tetra-aero/LTC6811_ESP32/Version Update Notes.txt

V1.0
1、Add chrysanthemum chain connection interface. （增加菊花链连接接口 ）

V1.2 
1、Rectify the issue of USB port being obstructed.（修正USB接口被遮挡的问题）
2、Change the maximum output current of the 3.3V DC-DC chip to 2A.（更改3.3V DCDC芯片最大输出电流为2A）
3、Remove the power supply circuit from the traction battery and switch to a 12V storage battery.（取消从动力电池供电电路，更改为12V蓄电池供电）
4、Optimize isolation partition（优化隔离分区）

V1.3
1、Correcting UART interface.
2、Optimizing signal transmission lines.
