tetra-aero/LTC6811_ESP32/LTC6811_ESP32_V6/Master_V6P1/LTC6811_ESP32_Master_V6P1_BOM.xlsx

Item | Qty | Reference | Value | Description | Datasheet | Footprint | Link | MPN | weight | total weight
1 | 44 | C1,C2,C3,C4,C5,C6,C7,C8,C9,C10,C27,C28,C32,C37,C41,C47,C49,C51,C52,C53,C54,C55,C56,C57,C58,C59,C60,C61,C62,C63,C67,C68,C77,C78,C79,C80,C81,C82,C83,C84,C85,C86,C87,C88 | 100nF/100V | 0.1 uF ±10% 100V Ceramic Capacitor X7R 0603 (1608 Metric) | https://www.digikey.jp/en/products/detail/samsung-electro-mechanics/CL10B104KC8NNNC/5961291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 | Capacitor_SMD:C_0603_1608Metric | https://www.digikey.jp/en/products/detail/samsung-electro-mechanics/CL10B104KC8NNNC/5961291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 | CL10B104KC8NNNC | 0.0063 | 0.2772
2 | 2 | C20,C33 | 2.2uF/25V | 2.2 uF ±10% 25V Ceramic Capacitor X5R 0603 (1608 Metric) | https://search.murata.co.jp/Ceramy/image/img/A01X/G101/ENG/GRM188R61E225KA12-01.pdf | Capacitor_SMD:C_0603_1608Metric | https://www.digikey.jp/en/products/detail/murata-electronics/GRM188R61E225KA12D/4905349 | GRM188R61E225KA12D | 0.0063 | 0.0126
3 | 2 | C21,C48 | 1nF/16V | 1000 pF ±10% 16V Ceramic Capacitor X7R 0603 (1608 Metric) | https://connect.kemet.com:7667/gateway/IntelliData-ComponentDocumentation/1.0/download/datasheet/C0603C102K4RECAUTO | Capacitor_SMD:C_0603_1608Metric | https://www.digikey.jp/en/products/detail/kemet/C0603C102K4RECAUTO/8640472 | C0603C102K4RECAUTO | 0.0063 | 0.0126
4 | 10 | C24,C26,C29,C30,C45,C50,C69,C70,C73,C74 | 10nF/100V | 10000 pF ±10% 100V Ceramic Capacitor X7R 0603 (1608 Metric) | https://content.kemet.com/datasheets/KEM_X7R_FT_VW_AUDI.pdf | Capacitor_SMD:C_0603_1608Metric | https://www.digikey.jp/en/products/detail/kemet/C0603X103K1RAC3316/10315782 | C0603X103K1RAC3316 | 0.0063 | 0.063
5 | 7 | C31,C34,C35,C38,C39,C64,C65 | 1uF/25V | 1 uF ±10% 25V Ceramic Capacitor X7R 0603 (1608 Metric) | https://mm.digikey.com/Volume0/opasdata/d220001/medias/docus/3644/CL10B105KA8NNNC_spec.pdf | Capacitor_SMD:C_0603_1608Metric | https://www.digikey.jp/en/products/detail/samsung-electro-mechanics/CL10B105KA8NNNC/3886842 | CL10B105KA8NNNC | 0.0063 | 0.0441
6 | 2 | C40,C42 | 4.7uF/16V | 4.7 uF ±10% 16V Ceramic Capacitor X5R 0603 (1608 Metric) | https://mm.digikey.com/Volume0/opasdata/d220001/medias/docus/2328/CL10A475KO8NNNC_Spec.pdf | Capacitor_SMD:C_0603_1608Metric | https://www.digikey.jp/en/products/detail/samsung-electro-mechanics/CL10A475KO8NNNC/3887442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 | CL10A475KO8NNNC | 0.0063 | 0.0126
7 | 3 | CR1,CR2,CR3 | S-562T | CURRENT REGULATOR DIODES 100V 5. | https://www.semitec-global.com/uploads/2022/01/P22-23-CRD.pdf | Diode_SMD:D_SOD-123F | https://www.digikey.jp/en/products/detail/semitec-usa-corp/S-562T/16578981 | S-562T
8 | 4 | D1,D4,D9,D25 | LED Red | Red 631nm LED Indication - Discrete 2V 0603 (1608 Metric) | https://optoelectronics.liteon.com/upload/download/DS-22-99-0151/LTST-C190KRKT.pdf | LED_SMD:LED_0603_1608Metric | https://www.digikey.jp/en/products/detail/liteon/LTST-C190KRKT/386817 | LTST-C190KRKT | 0.028 | 0.112
9 | 4 | D6,D7,D22,D23 | 1N4148W | Diode 100 V 300mA Surface Mount SOD-123 | https://www.diodes.com/assets/Datasheets/BAV16W_1N4148W.pdf | Diode_SMD:D_SOD-123 | https://www.digikey.jp/en/products/detail/diodes-incorporated/1N4148W-7-F/814371 | 1N4148W-7-F | 0.01 | 0.04
10 | 2 | D8,D24 | BZT52H-C62 | Zener Diode 62 V 375 mW ±5% Surface Mount SOD-123F | https://assets.nexperia.com/documents/data-sheet/BZT52H_SER.pdf | Diode_SMD:D_SOD-123F | https://www.digikey.jp/en/products/detail/nexperia-usa-inc/BZT52H-C62-115/1162867 | BZT52H-C62,115 | 0.0098 | 0.0196
11 | 24 | D10,D11,D12,D13,D14,D15,D16,D17,D18,D19,D20,D21,D26,D27,D28,D29,D30,D31,D32,D33,D34,D35,D36,D37 | PDZ7.5B | Zener Diode 7.6 V 400 mW ±2% Surface Mount SOD-323 | https://assets.nexperia.com/documents/data-sheet/PDZ-B_SER.pdf | Diode_SMD:D_SOD-323_HandSoldering | https://www.digikey.jp/en/products/detail/nexperia-usa-inc/PDZ7-5BZ/7495708 | PDZ7.5BZ | 0.001 | 0.024
12 | 26 | F1,F2,F3,F4,F5,F6,F7,F8,F9,F10,F11,F12,F13,F14,F15,F16,F17,F18,F19,F20,F21,F22,F23,F24,F25,F26 | MPZ2012S102ATD25 | 1 kOhms @ 100 MHz 1 Power Line Ferrite Bead 0805 (2012 Metric) 1.5A 150mOhm | https://product.tdk.com/en/system/files | Fuse:Fuse_0805_2012Metric | https://www.digikey.jp/en/products/detail/tdk-corporation/MPZ2012S102ATD25/5040327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 | MPZ2012S102ATD25 | 0.008 | 0.208
13 | 2 | FB1,FB2 | BLM18PG330SN1D | 33 Ohms @ 100 MHz 1 Power Line Ferrite Bead 0603 (1608 Metric) 3A 25mOhm | https://www.murata.com/en-us/products/productdata/8796738650142/ENFA0003.pdf | Resistor_SMD:R_0603_1608Metric | https://www.digikey.jp/en/products/detail/murata-electronics/BLM18PG330SN1D/1948325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 | BLM18PG330SN1D | 0.035 | 0.07
14 |  | J1 | B6B-XH-A | Connector Header Through Hole 6 position 0.098" (2.50mm) | https://www.jst-mfg.com/product/pdf/eng/eXH.pdf | Connector_JST:JST_XH_B6B-XH-A_1x06_P2.50mm_Vertical | https://www.digikey.jp/en/products/detail/jst-sales-america-inc/B6B-XH-A/1000381 | B6B-XH-A
15 | 2 | J5,J23 | CAN | Connector Header Through Hole 4 position 0.098" (2.50mm) | chrome-extension://efaidnbmnnnibpcajpcglclefindmkaj/https://www.jst-mfg.com/product/pdf/eng/eXH.pdf | Connector_JST:JST_XH_B4B-XH-A_1x04_P2.50mm_Vertical | https://www.digikey.jp/en/products/detail/jst-sales-america-inc/B4B-XH-A/1651047 | B4B-XH-A | 0.4 | 0.8
16 | 1 | J6 | B2P-VH-B | Connector Header Through Hole 2 position 0.100" (2.54mm) | https://tools.molex.com/pdm_docs/sd/705430001_sd.pdf | Connector_JST:JST_VH_B2P-VH-B_1x02_P3.96mm_Vertical | https://www.digikey.jp/en/products/detail/jst-sales-america-inc/B2P-VH/926547 | B2P-VH | 0.58 | 0.58
17 | 4 | J10,J11,J12,J13 | B7B-XH-A | Connector Header Through Hole 7 position 0.098" (2.50mm) | https://www.jst-mfg.com/product/pdf/eng/eXH.pdf | Connector_JST:JST_XH_B7B-XH-A_1x07_P2.50mm_Vertical_BAT_6S | https://www.digikey.jp/en/products/detail/jst-sales-america-inc/B7B-XH-A/1651050 | B7B-XH-A | 0.652 | 2.608
18 | 2 | Q1,Q14 | NSV1C201MZ4 | Bipolar (BJT) Transistor NPN 100 V 2 A 100MHz 800 mW Surface Mount SOT-223 (TO-261) | https://www.onsemi.com/pdf/datasheet/nss1c201mz4-d.pdf | Package_TO_SOT_SMD:SOT-223 | https://www.digikey.jp/en/products/detail/onsemi/NSV1C201MZ4T1G/4848737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 | NSV1C201MZ4T1G | 0.112 | 0.224
19 | 24 | Q2,Q3,Q4,Q5,Q6,Q7,Q8,Q9,Q10,Q11,Q12,Q13,Q15,Q16,Q17,Q18,Q19,Q20,Q21,Q22,Q23,Q24,Q25,Q26 | TSM2323 | P-Channel 20 V 4.7A (Ta) 1.25W (Ta) Surface Mount SOT-23 | https://www.taiwansemi.com/assets/uploads/datasheet/TSM2323_F15.pdf | Package_TO_SOT_SMD:SOT-23 | https://www.digikey.jp/en/products/detail/taiwan-semiconductor-corporation/TSM2323CX-RFG/7360264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 | TSM2323CX RFG | 0.008 | 0.192
20 | 3 | Q27,Q28,Q28 | SSM3J332R,LF | P-MOSFET transistor, gate/source/drain | https://toshiba.semicon-storage.com/info/SSM3J332R_datasheet_en_20250523.pdf?did=2620&prodName=SSM3J332R | PCM_Package_TO_SOT_SMD_AKL:TSOT-23 | https://www.digikey.jp/en/products/detail/toshiba-semiconductor-and-storage/SSM3J332R-LF/3522371 | SSM3J332R,LF
21 | 6 | R1,R2,R36,R37,R46,R49 | 49.9R | 49.9 Ohms ±1% 0.1W, 1/10W Chip Resistor 0603 (1608 Metric) Automotive AEC-Q200 Thick Film | https://industrial.panasonic.com/cdbs/www-data/pdf/RDA0000/AOA0000C304.pdf | Resistor_SMD:R_0603_1608Metric | https://www.digikey.jp/en/products/detail/panasonic-electronic-components/ERJ-3EKF49R9V/196378 | ERJ-3EKF49R9V | 0.002 | 0.012
22 | 21 | R3,R4,R5,R6,R7,R8,R9,R10,R11,R12R13,R14,R16,,R34,R102,R103,R104,R105,R144,R148,R149,R151 | 10K | 10 kOhms ±1% 0.1W, 1/10W Chip Resistor 0603 (1608 Metric) Moisture Resistant Thick Film | https://www.yageo.com/upload/media/product/products/datasheet/rchip/PYu-RC_Group_51_RoHS_L_12.pdf | Resistor_SMD:R_0603_1608Metric | https://www.digikey.jp/en/products/detail/yageo/RC0603FR-0710KL/726880 | RC0603FR-0710KL | 0.002 | 0.042
23 | 2 | R27,R33 | 470R | 470 Ohms ±5% 0.1W, 1/10W Chip Resistor 0603 (1608 Metric) Moisture Resistant Thick Film | https://www.yageo.com/upload/media/product/products/datasheet/rchip/PYu-RC_Group_51_RoHS_L_12.pdf | Resistor_SMD:R_0603_1608Metric | https://www.digikey.jp/en/products/detail/yageo/RC0603JR-07470RL/726791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 | RC0603JR-07470RL | 0.002 | 0.004
24 | 4 | R29,R32,R154,R155 | 51R | 51 Ohms ±5% 0.1W, 1/10W Chip Resistor 0603 (1608 Metric) Moisture Resistant Thick Film | https://www.yageo.com/upload/media/product/productsearch/datasheet/rchip/PYu-RC_Group_51_RoHS_L_12.pdf | Resistor_SMD:R_0603_1608Metric | https://www.digikey.jp/en/products/detail/yageo/RC0603JR-0751RL/726803 | RC0603JR-0751RL | 0.002 | 0.008
25 | 9 | R15,R17,R21,R35,R38,R42,R47,R97,R98 | 1K | 1 kOhms ±1% 0.1W, 1/10W Chip Resistor 0603 (1608 Metric) Moisture Resistant Thick Film | https://www.yageo.com/upload/media/product/products/datasheet/rchip/PYu-RC_Group_51_RoHS_L_12.pdf | Resistor_SMD:R_0603_1608Metric | https://www.digikey.jp/en/products/detail/yageo/RC0603FR-071KL/726843 | RC0603FR-071KL | 0.002 | 0.018
26 | 1 | R39 | 2K | 2 kOhms ±1% 0.1W, 1/10W Chip Resistor 0603 (1608 Metric) Moisture Resistant Thick Film | https://www.yageo.com/upload/media/product/app/datasheet/rchip/pyu-rc_group_51_rohs_l.pdf | Resistor_SMD:R_0603_1608Metric | https://www.digikey.jp/en/products/detail/yageo/RC0603FR-072KL/727009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 | RC0603FR-072KL | 0.002 | 0.002
27 | 28 | R40,R41,R56,R59,R62,R65,R68,R71,R74,R77,R80,R83,R86,R89,R91,R92,R107,R110,R113,R116,R119,R122,R125,R128,R131,R134,R137,R140 | 100R | 100 Ohms ±1% 0.1W, 1/10W Chip Resistor 0603 (1608 Metric) Moisture Resistant Thick Film | https://www.yageo.com/upload/media/product/app/datasheet/rchip/pyu-rc_group_51_rohs_l.pdf | Resistor_SMD:R_0603_1608Metric | https://www.digikey.jp/en/products/detail/yageo/RC0603FR-07100RL/726888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 | RC0603FR-07100RL | 0.002 | 0.056
28 | 4 | R43,R45,R94,R96 | 0 | 0 Ohms Jumper Chip Resistor 0603 (1608 Metric) Moisture Resistant Thick Film | https://www.yageo.com/upload/media/product/products/datasheet/rchip/PYu-RC_Group_51_RoHS_L_12.pdf | Resistor_SMD:R_0603_1608Metric | https://www.digikey.jp/en/products/detail/yageo/RC0603JR-070RL/726675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 | RC0603JR-070RL | 0.002 | 0.008
29 | 2 | R44,R95 | 1M | 1 MOhms ±5% 0.1W, 1/10W Chip Resistor 0603 (1608 Metric) Moisture Resistant Thick Film | https://www.yageo.com/upload/media/product/app/datasheet/rchip/pyu-rc_group_51_rohs_l.pdf | Resistor_SMD:R_0603_1608Metric | https://www.digikey.jp/en/products/detail/yageo/RC0603JR-071ML/726678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 | RC0603JR-071ML | 0.002 | 0.004
30 | 2 | R48,R99 | 1.2K | 1.2 kOhms ±5% 0.1W, 1/10W Chip Resistor 0603 (1608 Metric) Moisture Resistant Thick Film | https://www.yageo.com/upload/media/product/productsearch/datasheet/rchip/PYu-RC_Group_51_RoHS_L_12.pdf | Resistor_SMD:R_0603_1608Metric | https://www.digikey.jp/en/products/detail/yageo/RC0603JR-071K2L/726683 | RC0603JR-071K2L | 0.002 | 0.004
31 | 24 | R55,R58,R61,R64,R67,R70,R73,R76,R79,R82,R85,R88,R106,R109,R112,R115,R118,R121,R124,R127,R130,R133,R136,R139 | 36R 1W 2512 | 36 Ohms ±5% 1W Chip Resistor 2512 (6432 Metric) Automotive AEC-Q200 Thick Film | https://www.seielect.com/catalog/sei-rmcf_rmcp.pdf | Resistor_SMD:R_2512_6332Metric | https://www.digikey.jp/en/products/detail/stackpole-electronics-inc/RMCF2512JT36R0/1716346 | RTT25360JTE | 0.004 | 0.096
32 | 24 | R57,R60,R63,R66,R69,R72,R75,R78,R81,R84,R87,R90,R108,R111,R114,R117,R120,R123,R126,R129,R132,R135,R138,R141 | 3.3K | 3.3 kOhms ±1% 0.1W, 1/10W Chip Resistor 0603 (1608 Metric) Moisture Resistant Thick Film | https://www.yageo.com/upload/media/product/app/datasheet/rchip/pyu-rc_group_51_rohs_l.pdf | Resistor_SMD:R_0603_1608Metric | https://www.digikey.jp/en/products/detail/yageo/RC0603FR-073K3L/727126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 | RC0603FR-073K3L | 0.002 | 0.048
33 | 1 | R153 | 120R | 120 Ohms ±5% 0.1W, 1/10W Chip Resistor 0603 (1608 Metric) Moisture Resistant Thick Film | https://www.yageo.com/upload/media/product/app/datasheet/rchip/pyu-rc_group_51_rohs_l.pdf | Resistor_SMD:R_0603_1608Metric | https://www.digikey.jp/en/products/detail/yageo/RC0603JR-07120RL/726706 | RC0603JR-07120RL | 0.002 | 0.002
34 | 1 | SW1 | 218-8LPSTJ | Dip Switch SPST 8 Position Surface Mount Slide (Standard) Actuator 25mA 24VDC | https://www.ctscorp.com/Files/DataSheets/Switches/DIP-Switches/CTS-Switches-DIP-218-Series-Datasheet.pdf | Button_Switch_SMD:SW_218-8LPSTJ_11.33×6.05_P1.27 | https://www.digikey.jp/en/products/detail/cts-electrocomponents/218-8LPSTJ/5223872 | 218-8LPSTJ | 2 | 2
35 | 2 | TH1,TH6 | 10K NTC SMD | THERMISTOR NTC 10KOHM 3380K 0603 | https://www.murata.com/en-us/api/pdfdownloadapi?cate=luNTCforTempeSenso&partno=NCU18XH103F6SRB | Resistor_SMD:R_0603_1608Metric | https://www.digikey.jp/en/products/detail/murata-electronics/NCU18XH103F6SRB/7243451 | NCU18XH103F6SRB | 0.034 | 0.068
36 | 8 | TH2,TH3,TH4,TH5,TH7,TH8,TH9,TH10 | 10K NTC | THERMISTOR NTC 10KOHM 3380K BEAD | https://www.cantherm.com/wp-content/uploads/2017/05/cantherm_mf52_1.pdf | Resistor_THT:R_Axial_DIN0204_L3.6mm_D1.6mm_P1.90mm_Vertical | https://www.digikey.jp/en/products/detail/cantherm/MF52C1103F3380/1840604 | MF52C1103F3380 | 0.28 | 2.24
37 | 3 | TR1,TR3,TR7 | HM2108NL | 135uH Pulse Transformer Surface Mount | https://productfinder.pulseelectronics.com/api/open/part-attachments/datasheet/HM2108NL | Transformer_SMD:HM2108NL | https://www.digikey.jp/en/products/detail/pulse-electronics/HM2108NL/7914611 | HM2108NL | 2 | 6
38 | 1 | U1 | MCP23017T-E/SS | I/O Expander 16 I2C 1.7 MHz 28-SSOP | https://ww1.microchip.com/downloads/aemDocuments/documents/APID/ProductDocuments/DataSheets/MCP23017-Data-Sheet-DS20001952.pdf | Package_SO:SSOP-28_5.3x10.2mm_P0.65mm | https://www.digikey.jp/en/products/detail/microchip-technology/MCP23017T-E-SS/964185 | MCP23017T-E/SS | 0.7704 | 0.7704
39 | 1 | U2 | MCP2562T-E/SN | 1/1 Transceiver Half CANbus 8-SOIC | https://ww1.microchip.com/downloads/en/DeviceDoc/20005167C.pdf | Package_SO:SOIC-8_3.9x4.9mm_P1.27mm | https://www.digikey.jp/en/products/detail/microchip-technology/MCP2562T-E-SN/4079891 | MCP2562T-E/SN | 0.54 | 0.54
40 | 1 | U3 | BD33FC0FP-E2 | Linear Voltage Regulator IC Positive Fixed 1 Output 1A TO-252 | https://fscdn.rohm.com/en/products/databook/datasheet/ic/power/linear_regulator/bdxxfc0wefj-e.pdf | Package_TO_SOT_SMD:TO252-3_ROM | https://www.digikey.jp/en/products/detail/rohm-semiconductor/BD33FC0FP-E2/7896452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 | BD33FC0FP-E2 | 3.698 | 3.698
41 | 1 | U4 | BD50FC0FP-E2 | Linear Voltage Regulator IC Positive Fixed 1 Output 1A TO-252 | https://fscdn.rohm.com/en/products/databook/datasheet/ic/power/linear_regulator/bdxxfc0wefj-e.pdf | Package_TO_SOT_SMD:TO252-3_ROM | https://www.digikey.jp/en/products/detail/rohm-semiconductor/BD50FC0FP-E2/7896453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 | BD50FC0FP-E2 | 4.885 | 4.885
42 | 3 | U5,U6,U7 | TLP291 | Optoisolator Transistor Output 3750Vrms 1 Channel 4-SO | https://toshiba.semicon-storage.com/info/TLP291%28SE_datasheet_en_20190708.pdf?did=14152&prodName=TLP291(SE | Package_SO:SOIC-4_4.55x2.6mm_P1.27mm | https://www.digikey.jp/en/products/detail/toshiba-semiconductor-and-storage/TLP291-GR-TP-SE/4562877 | TLP291(GR-TP,SE
43 | 1 | U8 | ESP32-DevKitC V4 | - ESP32-WROOM-32E Transceiver; 802.11 b/g/n (Wi-Fi, WiFi, WLAN), Bluetooth庐 Smart Ready 4.x Dual Mode 2.4GHz Evaluation Board | https://mm.digikey.com/Volume0/opasdata/d220001/medias/docus/754/ESP32-DevKitC_GSG_Ver1.4_2017.pdf | RF_Module:ESP32-DevKitc V4_DIP-38_27.9mm脳48.2mm | https://www.digikey.jp/en/products/detail/espressif-systems/ESP32-DEVKITC-32E/12091810 | ESP32-DEVKITC-32E | 272.16 | 272.16
44 | 1 | U9 | LTC6820 | Isolated Communications Interface Interface 16-MSOP | https://www.analog.com/media/en/technical-documentation/data-sheets/LTC6820.pdf | Package_SO:MSOP-16_3x4mm_P0.5mm | https://www.digikey.jp/en/products/detail/analog-devices-inc/LTC6820IMS-PBF/3838555 | LTC6820IMS#PBF | 0.035866 | 0.035866
45 | 2 | U11,U12 | LTC6811HG-1 | Battery Battery Monitor IC Multi-Chemistry 48-SSOP | https://www.analog.com/media/en/technical-documentation/data-sheets/LTC6811-1-6811-2.pdf | Package_SO:TSSOP-48_6.1x12.5mm_P0.5mm | https://www.digikey.jp/en/products/detail/analog-devices-inc/LTC6811HG-1-3ZZPBF/9739208 | LTC6811HG-1#3ZZPBF | 2 | 4
 | 8 |  | B2B-ZR | Connector Header Through Hole 2 position 0.059" (1.50mm) | https://www.jst-mfg.com/product/pdf/eng/eZH.pdf | Connector_JST:JST_ZR_B2B-ZR_1x02_P1.50mm_Vertical | https://www.digikey.jp/en/products/detail/jst-sales-america-inc/B2B-ZR/926564 | B2B-ZR
 | 8 |  | ZHR-2 | 2 Rectangular Connectors - Housings Receptacle Natural 0.059" (1.50mm) | https://www.jst-mfg.com/product/pdf/eng/eZH.pdf |  | https://www.digikey.jp/en/products/detail/jst-sales-america-inc/ZHR-2/566476 | ZHR-2
 | 16 |  | SZH-003T-P0.5 | CONN SOCKET 28-32AWG CRIMP TIN | https://www.jst.com/wp-content/uploads/2025/06/eZM.pdf |  | https://www.digikey.jp/en/products/detail/jst-sales-america-inc/SZH-003T-P0-5/608722 | SZH-003T-P0.5
46 | 1 | PCB |  | 200mm*55mm |  |  |  |  | 32.56 | 32.56
 |  |  |  |  |  |  |  |  |  | 0
 |  |  |  |  |  |  |  |  |  | 0
 |  |  |  |  |  |  |  |  |  | 334.560966
