tetra-aero/LTC6811_ESP32/Master/ESP32_Master_V2/ESP32_Master_V2_BOM.xlsx

ESP32_Master_V2_BOM
Item | Qty | Reference(s) | Value | Footprint | Datasheet | Description | Link | MPN
1 | 5 | C1, C10, C13, C24, C27 | 10uF/16V | Capacitor_SMD:C_0805_2012Metric | https://mm.digikey.com/Volume0/opasdata/d220001/medias/docus/609/CL21A106KOQNNNE_Spec.pdf | 10uF ±10% 16V Ceramic Capacitor X5R 0805 (2012 Metric) | https://www.digikey.jp/en/products/detail/samsung-electro-mechanics/CL21A106KOQNNNE/3886754 | CL21A106KOQNNNE
2 | 17 | C2, C5, C6, C8, C9, C18, C19, C20, C21, C23, C25, C28, C29, C31, C32, C33, C37 | 100nF/100V | Capacitor_SMD:C_0603_1608Metric | https://www.digikey.jp/en/products/detail/samsung-electro-mechanics/CL10B104KC8NNNC/5961291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 | 0.1uF ±10% 100V Ceramic Capacitor X7R 0603 (1608 Metric) | https://www.digikey.jp/en/products/detail/samsung-electro-mechanics/CL10B104KC8NNNC/5961291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 | CL10B104KC8NNNC
3 | 3 | C3, C11, C12 | 2.2uF/25V | Capacitor_SMD:C_0603_1608Metric | https://search.murata.co.jp/Ceramy/image/img/A01X/G101/ENG/GRM188R61E225KA12-01.pdf | 2.2uF ±10% 25V Ceramic Capacitor X5R 0603 (1608 Metric) | https://www.digikey.jp/en/products/detail/murata-electronics/GRM188R61E225KA12D/4905349 | GRM188R61E225KA12D
4 | 2 | C4, C7 | 330pF/100V | Capacitor_SMD:C_0603_1608Metric | https://search.murata.co.jp/Ceramy/image/img/A01X/G101/ENG/GRM188R72A331KA01-01.pdf | 330 pF ±10% 100V Ceramic Capacitor X7R 0603 (1608 Metric) | https://www.digikey.jp/en/products/detail/murata-electronics/GRM188R72A331KA01D/587128 | GRM188R72A331KA01D
5 | 2 | C14, C15 | 2.2nF/16V | Capacitor_SMD:C_0603_1608Metric | https://connect.kemet.com:7667/gateway/IntelliData-ComponentDocumentation/1.0/download/datasheet/C0603C222K4RECAUTO | 2200 pF ±10% 16V Ceramic Capacitor X7R 0603 (1608 Metric) | https://www.digikey.jp/en/products/detail/kemet/C0603C222K4RECAUTO/8646528 | C0603C222K4RECAUTO
6 | 2 | C16, C17 | 220pF/50V | Capacitor_SMD:C_0603_1608Metric | https://search.murata.co.jp/Ceramy/image/img/A01X/G101/ENG/GCM1885C1H221JA16-01.pdf | 220 pF ±5% 50V Ceramic Capacitor C0G, NP0 0603 (1608 Metric) | https://www.digikey.jp/en/products/detail/murata-electronics/GCM1885C1H221JA16D/1765211 | GCM1885C1H221JA16D
7 | 4 | C22, C30, C36, C71 | 1uF/25V | Capacitor_SMD:C_0603_1608Metric | https://mm.digikey.com/Volume0/opasdata/d220001/medias/docus/3644/CL10B105KA8NNNC_spec.pdf | 1 µF ±10% 25V Ceramic Capacitor X7R 0603 (1608 Metric) | https://www.digikey.jp/en/products/detail/samsung-electro-mechanics/CL10B105KA8NNNC/3886842 | CL10B105KA8NNNC
8 | 1 | C26 | 4.7uF/16V | Capacitor_SMD:C_0603_1608Metric | https://mm.digikey.com/Volume0/opasdata/d220001/medias/docus/2328/CL10A475KO8NNNC_Spec.pdf | 4.7uF ±10% 16V Ceramic Capacitor X5R 0603 (1608 Metric) | https://www.digikey.jp/en/products/detail/samsung-electro-mechanics/CL10A475KO8NNNC/3887442 | CL10A475KO8NNNC
9 | 2 | C34, C35 | 10nF/100V | Capacitor_SMD:C_0603_1608Metric | https://search.murata.co.jp/Ceramy/image/img/A01X/G101/ENG/GCM188R72A103KA37-01.pdf | 10000 pF ±10% 100V Ceramic Capacitor X7R 0603 (1608 Metric) | https://www.digikey.jp/en/products/detail/murata-electronics/GCM188R72A103KA37D/1641655 | GCM188R72A103KA37D
10 | 2 | D1, D3 | LED Red | LED_SMD:LED_0603_1608Metric | https://docs.broadcom.com/doc/AV02-0112EN | Red 626nm LED Indication - Discrete 1.9V 0603 (1608 Metric) | https://www.digikey.jp/en/products/detail/broadcom-limited/HSMC-C191/2403196 | HSMC-C191
11 | 1 | D2 | ESD24VS2U | Package_TO_SOT_SMD:SOT-23 | https://www.infineon.com/dgdl/Infineon-ESD24VS2U-DS-v01_01-en.pdf?fileId=db3a3043340fff53013413a2249d2ff3 | 41V Clamp 5A (8/20us) Ipp Tvs Diode Surface Mount PG-SOT23 | https://www.digikey.jp/en/products/detail/infineon-technologies/ESD24VS2UE6327HTSA1/1785650 | ESD24VS2UE6327HTSA1
12 | 2 | D4, D5 | MBR0520 | Diode_SMD:D_SOD-123 | http://www.mccsemi.com/up_pdf/MBR0520~MBR0580(SOD123).pdf | Diode 20 V 500mA Surface Mount SOD-123 | https://www.digikey.jp/en/products/detail/micro-commercial-co/MBR0520-TP/717250 | MBR0520-TP
13 | 4 | J1，J3，J7, J8 | JST_VH_B2P | Connector_JST:JST_VH_B2P-VH-B_1x02_P3.96mm_Vertical | https://www.jst-mfg.com/product/pdf/eng/eVH.pdf | Connector Header Through Hole 2 position 0.156" (3.96mm) | https://www.digikey.jp/en/products/detail/jst-sales-america-inc/B2P-VH/926547 | B2P-VH
14 | 2 | J2，J6 | JTAG /NC | Connector_PinHeader_2.54mm:PinHeader_1x04_P2.54mm_Vertical | https://cdn.amphenol-cs.com/media/wysiwyg/files/drawing/g800wxxxxxxeu_1.pdf | Connector Header Through Hole 4 position 0.100" (2.54mm) | https://www.digikey.jp/en/products/detail/amphenol-cs-commercial-products/G800W304018EU/13682993 | G800W304018EU
15 | 1 | L1 | 3.3uH | Inductor_SMD:L_Bourns_SRP5030T | https://www.bourns.com/docs/Product-Datasheets/SRP5030CC.pdf | 3.3uH Shielded Wirewound Inductor 5 A 38mOhm Max Nonstandard | https://www.digikey.jp/en/products/detail/bourns-inc/SRP5030CC-3R3M/21263799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 | SRP5030CC-3R3M
16 | 2 | R1, R10 | 470R | Resistor_SMD:R_0603_1608Metric | https://www.yageo.com/upload/media/product/products/datasheet/rchip/PYu-RC_Group_51_RoHS_L_12.pdf | 470 Ohms ±5% 0.1W, 1/10W Chip Resistor 0603 (1608 Metric) Moisture Resistant Thick Film | https://www.digikey.jp/en/products/detail/yageo/RC0603JR-07470RL/726791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 | RC0603JR-07470RL
17 | 4 | R9, R11, R12, R14 | 470KΩ ±0.1% 250mW | Resistor_SMD:R_0805_2012Metric | https://industrial.panasonic.com/cdbs/www-data/pdf/RDM0000/AOA0000C328.pdf | 470 kOhms ±0.1% 0.25W, 1/4W Chip Resistor 0805 (2012 Metric) Automotive AEC-Q200, Pulse Withstanding Thick Film | https://www.digikey.jp/en/products/detail/panasonic-electronic-components/ERJ-PB6B4703V/6213681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 | ERJ-PB6B4703V
18 | 1 | R13 | 100uOhm 1% 15W | Resistor_SMD:R_PSR500HTQFB0L10_Metric_Pad5.2x8.75mm_Hole | https://fscdn.rohm.com/en/products/databook/datasheet/passive/resistor/chip_resistor/psr-e.pdf | 100uOhms ±1% 15W Chip Resistor Nonstandard Automotive AEC-Q200, Current Sense Metal Element | https://www.digikey.jp/en/products/detail/rohm-semiconductor/PSR500HTQFB0L10/17140191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 | PSR500HTQFB0L10
19 | 1 | R15 | 1KΩ ±0.1% 250mW | Resistor_SMD:R_0805_2012Metric | https://industrial.panasonic.com/cdbs/www-data/pdf/RDM0000/AOA0000C328.pdf | 1 kOhms ±0.1% 0.25W, 1/4W Chip Resistor 0805 (2012 Metric) Automotive AEC-Q200, Pulse Withstanding Thick Film | https://www.digikey.jp/en/products/detail/panasonic-electronic-components/ERJ-PB6B1001V/6213377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 | ERJ-PB6B1001V
20 | 8 | R16, R17, R18, R24, R25, R26, R27, R32 | 1K | Resistor_SMD:R_0603_1608Metric | https://www.vishay.com/docs/20035/dcrcwe3.pdf | 1 kOhms ±1% 0.1W, 1/10W Chip Resistor 0603 (1608 Metric) Automotive AEC-Q200 Thick Film | https://www.digikey.jp/en/products/detail/vishay-dale/CRCW06031K00FKEA/1179809 | CRCW06031K00FKEA
21 | 1 | R19 | 10R | Resistor_SMD:R_0603_1608Metric | https://www.yageo.com/upload/media/product/app/datasheet/rchip/pyu-rc_group_51_rohs_l.pdf | 10 Ohms ±5% 0.1W, 1/10W Chip Resistor 0603 (1608 Metric) Moisture Resistant Thick Film | https://www.digikey.jp/en/products/detail/yageo/RC0603JR-0710RL/726699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 | RC0603JR-0710RL
22 | 4 | R20, R21, R22, R23 | 100R | Resistor_SMD:R_0603_1608Metric | https://www.yageo.com/upload/media/product/app/datasheet/rchip/pyu-rc_group_51_rohs_l.pdf | 100 Ohms ±1% 0.1W, 1/10W Chip Resistor 0603 (1608 Metric) Moisture Resistant Thick Film | https://www.digikey.jp/en/products/detail/yageo/RC0603FR-07100RL/726888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 | RC0603FR-07100RL
23 | 2 | R28, R29 | 5.6K | Resistor_SMD:R_0603_1608Metric | https://www.yageo.com/upload/media/product/productsearch/datasheet/rchip/PYu-RC_Group_51_RoHS_L_12.pdf | 5.6 kOhms ±5% 0.1W, 1/10W Chip Resistor 0603 (1608 Metric) Moisture Resistant Thick Film | https://www.digikey.jp/en/products/detail/yageo/RC0603JR-075K6L/726799 | RC0603JR-075K6L
24 | 2 | R30, R31 | 3.3K | Resistor_SMD:R_0603_1608Metric | https://www.yageo.com/upload/media/product/app/datasheet/rchip/pyu-rc_group_51_rohs_l.pdf | 3.3 kOhms ±1% 0.1W, 1/10W Chip Resistor 0603 (1608 Metric) Moisture Resistant Thick Film | https://www.digikey.jp/en/products/detail/yageo/RC0603FR-073K3L/727126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 | RC0603FR-073K3L
25 | 2 | R33, R34 | 33K | Resistor_SMD:R_0603_1608Metric | https://www.yageo.com/upload/media/product/productsearch/datasheet/rchip/PYu-AC_51_RoHS_L_10.pdf | 33 kOhms ±1% 0.1W, 1/10W Chip Resistor 0603 (1608 Metric) Automotive AEC-Q200, Moisture Resistant Thick Film | https://www.digikey.jp/en/products/detail/yageo/AC0603FR-0733KL/6006447 | AC0603FR-0733KL
26 | 2 | R35, R36 | 4.7K | Resistor_SMD:R_0603_1608Metric | https://www.yageo.com/upload/media/product/products/datasheet/rchip/PYu-RC_Group_51_RoHS_L_12.pdf | 4.7 kOhms ±5% 0.1W, 1/10W Chip Resistor 0603 (1608 Metric) Moisture Resistant Thick Film | https://www.digikey.jp/en/products/detail/yageo/RC0603JR-074K7L/726785 | RC0603JR-074K7L
27 | 1 | R37 | 100K | Resistor_SMD:R_0603_1608Metric | https://www.yageo.com/upload/media/product/app/datasheet/rchip/pyu-rc_group_51_rohs_l.pdf | 100 kOhms ±5% 0.1W, 1/10W Chip Resistor 0603 (1608 Metric) Moisture Resistant Thick Film | https://www.digikey.jp/en/products/detail/yageo/RC0603JR-07100KL/726698 | RC0603JR-07100KL
28 | 1 | R38 | 22.1K | Resistor_SMD:R_0603_1608Metric | https://www.seielect.com/catalog/sei-rmcf_rmcp.pdf | 22.1 kOhms ±1% 0.1W, 1/10W Chip Resistor 0603 (1608 Metric) Automotive AEC-Q200 Thick Film | https://www.digikey.jp/en/products/detail/stackpole-electronics-inc/RMCF0603FT22K1/1760764 | RMCF0603FT22K1
29 | 1 | R43 | 10K | Resistor_SMD:R_0603_1608Metric | https://www.seielect.com/catalog/sei-rmcf_rmcp.pdf | 10 kOhms ±1% 0.1W, 1/10W Chip Resistor 0603 (1608 Metric) Automotive AEC-Q200 Thick Film | https://www.digikey.jp/en/products/detail/stackpole-electronics-inc/RMCF0603FT10K0/1761235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 | RMCF0603FT10K0
30 | 1 | R44 | 806R | Resistor_SMD:R_0603_1608Metric | https://www.yageo.com/upload/media/product/app/datasheet/rchip/pyu-rc_group_51_rohs_l.pdf | 806 Ohms ±1% 0.1W, 1/10W Chip Resistor 0603 (1608 Metric) Moisture Resistant Thick Film | https://www.digikey.jp/en/products/detail/yageo/RC0603FR-07806RL/727397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 | RC0603FR-07806RL
31 | 2 | R45, R46 | 51R | Resistor_SMD:R_0603_1608Metric | https://www.yageo.com/upload/media/product/productsearch/datasheet/rchip/PYu-RC_Group_51_RoHS_L_12.pdf | 51 Ohms ±5% 0.1W, 1/10W Chip Resistor 0603 (1608 Metric) Moisture Resistant Thick Film | https://www.digikey.jp/en/products/detail/yageo/RC0603JR-0751RL/726803 | RC0603JR-0751RL
32 | 1 | R47 | 1.2K | Resistor_SMD:R_0603_1608Metric | https://www.yageo.com/upload/media/product/productsearch/datasheet/rchip/PYu-RC_Group_51_RoHS_L_12.pdf | 1.2 kOhms ±5% 0.1W, 1/10W Chip Resistor 0603 (1608 Metric) Moisture Resistant Thick Film | https://www.digikey.jp/en/products/detail/yageo/RC0603JR-071K2L/726683 | RC0603JR-071K2L
33 | 1 | R48 | 2K | Resistor_SMD:R_0603_1608Metric | https://www.yageo.com/upload/media/product/app/datasheet/rchip/pyu-rc_group_51_rohs_l.pdf | 2 kOhms ±1% 0.1W, 1/10W Chip Resistor 0603 (1608 Metric) Moisture Resistant Thick Film | https://www.digikey.jp/en/products/detail/yageo/RC0603FR-072KL/727009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 | RC0603FR-072KL
34 | 1 | TR1 | Transformer | Connector_Wuerth:WURTH-760390015 | https://mm.digikey.com/Volume0/opasdata/d220001/medias/docus/2416/760390015%20Dwg.pdf | Forward, Push-Pull Converters For For DC/DC Converters SMPS Transformer 3125Vrms Isolation 10kHz Surface Mount | https://www.digikey.jp/en/products/detail/w%C3%BCrth-elektronik/760390015/3831267 | 760390015
35 | 1 | TR2 | HM2108NL | Transformer_SMD:HM2108NL | https://productfinder.pulseelectronics.com/api/open/part-attachments/datasheet/HM2108NL | 135uH Pulse Transformer Surface Mount | https://www.digikey.jp/en/products/detail/pulse-electronics/HM2108NL/7914611 | HM2108NL
36 | 1 | U1 | TPS76350 | Package_TO_SOT_SMD:SOT-23-5 | https://www.ti.com/lit/ds/symlink/tps763.pdf?ts=1704882534161 | Linear Voltage Regulator IC Positive Fixed 1 Output 150mA SOT-23-5 | https://www.digikey.jp/en/products/detail/texas-instruments/TPS76350DBVR/382163 | TPS76350DBVR
37 | 2 | U2,U3 | AMC1301 | Package_SO:SSO-8_6.8x5.9mm_P1.27mm_Clearance8mm | https://www.ti.com/lit/ds/symlink/amc1301.pdf?ts=1697691105837 | Isolation Amplifier 1 Circuit 8-SOIC | https://www.digikey.jp/en/products/detail/texas-instruments/AMC1301DWV/6131500 | AMC1301DWV
38 | 1 | U4 | SN6501DBV | Package_TO_SOT_SMD:SOT-23-5 | https://www.ti.com.cn/cn/lit/ds/symlink/sn6501.pdf?ts=1707800085827 | Transformer Driver PMIC SOT-23-5 | https://www.digikey.jp/en/products/detail/texas-instruments/SN6501DBVR/3431175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 | SN6501DBVR
39 | 1 | U5 | OPA2197IDR | Package_SO:SOIC-8_3.9x4.9mm_P1.27mm | https://www.ti.com/lit/ds/symlink/opa2197.pdf?HQS=dis-dk-null-digikeymode-dsf-pf-null-wwe&ts=1698207032697 | General Purpose Amplifier 2 Circuit Rail-to-Rail 8-SOIC | https://www.digikey.jp/en/products/detail/texas-instruments/OPA2197IDR/6175210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 | OPA2197IDR
40 | 1 | U6 | ISL28022 | Package_SO:MSOP-10_3x3mm_P0.5mm | https://www.renesas.com/us/en/document/dst/isl28022-datasheet | Power Supply Controller Power Supply Monitor 10-MSOP | https://www.digikey.jp/en/products/detail/renesas-electronics-america-inc/ISL28022FUZ-T7A/4765786 | ISL28022FUZ-T7A
41 | 1 | U7 | LMR51420XDDCR | Package_TO_SOT_SMD:SOT-23-6_Handsoldering | https://www.ti.com/lit/ds/symlink/lmr51420.pdf | Buck Switching Regulator IC Positive Adjustable 0.6V 1 Output 2A SOT-23-6 Thin, TSOT-23-6 | https://www.digikey.jp/en/products/detail/texas-instruments/LMR51420XDDCR/16705125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 | LMR51420XDDCR
42 | 1 | U8 | ESP32-DevKitC V4 | RF_Module:ESP32-DevKitc V4_DIP-38_27.9mmﾃ・8.2mm | https://mm.digikey.com/Volume0/opasdata/d220001/medias/docus/754/ESP32-DevKitC_GSG_Ver1.4_2017.pdf | - ESP32-WROOM-32E Transceiver; 802.11 b/g/n (Wi-Fi, WiFi, WLAN), Bluetoothﾂｮ Smart Ready 4.x Dual Mode 2.4GHz Evaluation Board | https://www.digikey.jp/en/products/detail/espressif-systems/ESP32-DEVKITC-32E/12091810 | ESP32-DEVKITC-32E
43 | 1 | U9 | LTC6820 | Package_SO:MSOP-16_3x4mm_P0.5mm | https://www.analog.com/media/en/technical-documentation/data-sheets/LTC6820.pdf | Isolated Communications Interface Interface 16-MSOP | https://www.digikey.jp/en/products/detail/analog-devices-inc/LTC6820IMS-PBF/3838555 | LTC6820IMS#PBF
44 | 1 | U10 | ISO1050DUBR | Package_SO:SOP-8_6.62x9.15mm_P2.54mm | https://www.ti.com/general/docs/suppproductinfo.tsp?distId=10 | 1/1 Transceiver, Isolated Half CANbus 8-SOP | https://www.digikey.jp/en/products/detail/texas-instruments/ISO1050DUBR/2094633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 | ISO1050DUBR
