tetra-aero/LTC6811_ESP32/LTC6811_ESP32_V1p3/document/LTC6811_ESP32_V1p3_BOM.xlsx

LTC6811_ESP32_V1p3 BOM
 | Reference | Value | Footprint | Datasheet | Description | Link | MPN | Quantity
1 | BZ1 | AI-1027-TWT-5V | Buzzer_Beeper:Beeper_AI-1027-TWT-5V | https://www.puiaudio.com/media/SpecSheet/AI-1027-TWT-5V-2-R.pdf | Buzzers Indicator, Internally Driven Electromechanical/Magnetic 5 V 30mA 2.73kHz 82dB @ 5V, 10cm Through Hole PC Pins | https://www.digikey.jp/en/products/detail/pui-audio-inc/AI-1027-TWT-5V-2-R/5011389 | AI-1027-TWT-5V-2-R | 1
2 | C1, C10, C13, C24, C27 | 10uF/16V | Capacitor_SMD:C_0805_2012Metric | https://mm.digikey.com/Volume0/opasdata/d220001/medias/docus/609/CL21A106KOQNNNE_Spec.pdf | 10 uF ±10% 16V Ceramic Capacitor X5R 0805 (2012 Metric) | https://www.digikey.jp/en/products/detail/samsung-electro-mechanics/CL21A106KOQNNNE/3886754 | CL21A106KOQNNNE | 5
3 | C2, C5, C6, C8, C9, C18-C21, C23, C25, C28, C32, C33, C37, C40, C48, C49, C54-C70 | 100nF/100V | Capacitor_SMD:C_0603_1608Metric | https://www.digikey.jp/en/products/detail/samsung-electro-mechanics/CL10B104KC8NNNC/5961291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 | 0.1 uF ±10% 100V Ceramic Capacitor X7R 0603 (1608 Metric) | https://www.digikey.jp/en/products/detail/samsung-electro-mechanics/CL10B104KC8NNNC/5961291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 | CL10B104KC8NNNC | 35
4 | C3, C11, C12, C38, C41 | 2.2uF/25V | Capacitor_SMD:C_0603_1608Metric | https://search.murata.co.jp/Ceramy/image/img/A01X/G101/ENG/GRM188R61E225KA12-01.pdf | 2.2 uF ±10% 25V Ceramic Capacitor X5R 0603 (1608 Metric) | https://www.digikey.jp/en/products/detail/murata-electronics/GRM188R61E225KA12D/4905349 | GRM188R61E225KA12D | 5
5 | C4, C7 | 330pF/100V | Capacitor_SMD:C_0603_1608Metric | https://datasheets.kyocera-avx.com/KGM_X7R.pdf | 330 pF ±10% 100V Ceramic Capacitor X7R 0603 (1608 Metric) | https://www.digikey.jp/en/products/detail/kyocera-avx/KGM15AR72A331KT/563306 | GRM188R72A331KA01D | 2
6 | C14, C15 | 2.2nF/16V | Capacitor_SMD:C_0603_1608Metric | https://connect.kemet.com:7667/gateway/IntelliData-ComponentDocumentation/1.0/download/datasheet/C0603C222K4RECAUTO | 2200 pF ±10% 16V Ceramic Capacitor X7R 0603 (1608 Metric) | https://www.digikey.jp/en/products/detail/kemet/C0603C222K4RECAUTO/8646528 | C0603C222K4RECAUTO | 2
7 | C16, C17 | 220pF/50V | Capacitor_SMD:C_0603_1608Metric | https://search.murata.co.jp/Ceramy/image/img/A01X/G101/ENG/GCM1885C1H221JA16-01.pdf | 220 pF ±5% 50V Ceramic Capacitor C0G, NP0 0603 (1608 Metric) | https://www.digikey.jp/en/products/detail/murata-electronics/GCM1885C1H221JA16D/1765211 | GCM1885C1H221JA16D | 2
8 | C22, C53 | 100pF/100V | Capacitor_SMD:C_0603_1608Metric | https://search.murata.co.jp/Ceramy/image/img/A01X/G101/ENG/GCM188R72A103KA37-01.pdf | 100 pF ±10% 100V Ceramic Capacitor X7R 0603 (1608 Metric) | https://www.digikey.jp/en/products/detail/murata-electronics/GCM188R72A103KA37D/1641655 | 0603B101K101SD | 2
9 | C26, C39 | 4.7uF/16V | Capacitor_SMD:C_0603_1608Metric | https://mm.digikey.com/Volume0/opasdata/d220001/medias/docus/2328/CL10A475KO8NNNC_Spec.pdf | 4.7 uF ±10% 16V Ceramic Capacitor X5R 0603 (1608 Metric) | https://www.digikey.jp/en/products/detail/samsung-electro-mechanics/CL10A475KO8NNNC/3887442 | CL10A475KO8NNNC | 2
10 | C34, C35 | 10nF/100V | Capacitor_SMD:C_0603_1608Metric | https://search.murata.co.jp/Ceramy/image/img/A01X/G101/ENG/GCM188R72A103KA37-01.pdf | 10000 pF ±10% 100V Ceramic Capacitor X7R 0603 (1608 Metric) | https://www.digikey.jp/en/products/detail/murata-electronics/GCM188R72A103KA37D/1641655 | GCM188R72A103KA37D | 2
11 | C36, C46, C47, C50-C52, C71 | 1uF/25V | Capacitor_SMD:C_0603_1608Metric | https://mm.digikey.com/Volume0/opasdata/d220001/medias/docus/3644/CL10B105KA8NNNC_spec.pdf | 1 uF ±10% 25V Ceramic Capacitor X7R 0603 (1608 Metric) | https://www.digikey.jp/en/products/detail/samsung-electro-mechanics/CL10B105KA8NNNC/3886842 | 0603B105K250XD | 7
12 | D1-D3, D12 | LED Red | LED_SMD:LED_0603_1608Metric | https://optoelectronics.liteon.com/upload/download/DS-22-99-0151/LTST-C190KRKT.pdf | Red 631nm LED Indication - Discrete 2V 0603 (1608 Metric) | https://www.digikey.jp/en/products/detail/liteon/LTST-C190KRKT/386817 | LTST-C190KRKT | 4
13 | D4, D5 | MBR0520 | Diode_SMD:D_SOD-123 | http://www.mccsemi.com/up_pdf/MBR0520~MBR0580(SOD123).pdf | Diode 20 V 500mA Surface Mount SOD-123 | https://www.digikey.jp/en/products/detail/micro-commercial-co/MBR0520-TP/717250 | MBR0520-TP | 2
14 | D7 | ESD24VS2U | Package_TO_SOT_SMD:SOT-23 | https://www.infineon.com/dgdl/Infineon-ESD24VS2U-DS-v01_01-en.pdf?fileId=db3a3043340fff53013413a2249d2ff3 | 41V Clamp 5A (8/20us) Ipp Tvs Diode Surface Mount PG-SOT23 | https://www.digikey.jp/en/products/detail/infineon-technologies/ESD24VS2UE6327HTSA1/1785650 | ESD24VS2UE6327HTSA1 | 1
15 | D9, D10 | 1N4148W | Diode_SMD:D_SOD-123 | https://www.diodes.com/assets/Datasheets/BAV16W_1N4148W.pdf | Diode 100 V 300mA Surface Mount SOD-123 | https://www.digikey.jp/en/products/detail/diodes-incorporated/1N4148W-7-F/814371 | 1N4148W-7-F | 2
16 | D11 | BZT52H-C62 | Diode_SMD:D_SOD-123F | https://assets.nexperia.com/documents/data-sheet/BZT52H_SER.pdf | Zener Diode 62 V 375 mW ±5% Surface Mount SOD-123F | https://www.digikey.jp/en/products/detail/nexperia-usa-inc/BZT52H-C62-115/1162867 | BZT52H-C62,115 | 1
17 | D13-D24 | PDZ7.5B | Diode_SMD:D_SOD-323_HandSoldering | https://assets.nexperia.com/documents/data-sheet/PDZ-B_SER.pdf | Zener Diode 7.6 V 400 mW ±2% Surface Mount SOD-323 | https://www.digikey.jp/en/products/detail/nexperia-usa-inc/PDZ7-5BZ/7495708 | PDZ7.5BZ | 12
18 | F1-F6, F8-F14 | MPZ2012S102ATD25 | Fuse:Fuse_0805_2012Metric | https://product.tdk.com/en/system/files | 1 kOhms @ 100 MHz 1 Power Line Ferrite Bead 0805 (2012 Metric) 1.5A 150mOhm | https://www.digikey.jp/en/products/detail/tdk-corporation/MPZ2012S102ATD25/5040327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 | MPZ2012S102ATD25 | 13
19 | FB1 | BLM18PG330SN1D | Resistor_SMD:R_0603_1608Metric | https://www.murata.com/en-us/products/productdata/8796738650142/ENFA0003.pdf | 33 Ohms @ 100 MHz 1 Power Line Ferrite Bead 0603 (1608 Metric) 3A 25mOhm | https://www.digikey.jp/en/products/detail/murata-electronics/BLM18PG330SN1D/1948325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 | BLM18PG330SN1D | 1
20 | J1, J15 | PB MB | Connector_JST:JST_VH_B2P-VH-B_1x02_P3.96mm_Vertical | https://www.jst-mfg.com/product/pdf/eng/eVH.pdf | Connector Header Through Hole 2 position 0.156" (3.96mm) | https://www.digikey.jp/en/products/detail/jst-sales-america-inc/B2P-VH/926547 | B2P-VH | 2
21 | J4 | USB | Connector_USB:Micro_USB_B-2013499-1 | chrome-extension://efaidnbmnnnibpcajpcglclefindmkaj/https://www.te.com/usa-en/product-2013499-1.datasheet.pdf | USB - micro B USB 2.0 Receptacle Connector 5 Position Surface Mount, Right Angle; Through Hole | https://www.digikey.jp/en/products/detail/te-connectivity-amp-connectors/2013499-1/4021843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 | 2013499-1 | 1
22 | J13, J14 | B7B-XH-A | Connector_JST:JST_XH_B7B-XH-A_1x07_P2.50mm_Vertical_BAT_6S | https://www.jst-mfg.com/product/pdf/eng/eXH.pdf | Connector Header Through Hole 7 position 0.098" (2.50mm) | https://www.digikey.jp/en/products/detail/jst-sales-america-inc/B7B-XH-A/1651050 | B7B-XH-A | 2
23 | L1 | 3.3uH | Inductor_SMD:L_Bourns_SRP5030T | https://www.bourns.com/docs/Product-Datasheets/SRP5030CC.pdf | 3.3 uH Shielded Wirewound Inductor 5 A 38mOhm Max Nonstandard | https://www.digikey.jp/en/products/detail/bourns-inc/SRP5030CC-3R3M/21263799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 | SRP5030CC-3R3M | 1
24 | Q1 | BSS138 | Package_TO_SOT_SMD:SOT-23 | https://mm.digikey.com/Volume0/opasdata/d220001/medias/docus/3037/BSS138.pdf | N-Channel 50 V 220mA (Ta) 350mW (Ta) Surface Mount SOT-23 | https://www.digikey.jp/en/products/detail/anbon-semiconductor-int-l-limited/BSS138/16708474 | BSS138 | 1
25 | Q2 | NSV1C201MZ4 | Package_TO_SOT_SMD:SOT-223 | https://www.onsemi.com/pdf/datasheet/nss1c201mz4-d.pdf | Bipolar (BJT) Transistor NPN 100 V 2 A 100MHz 800 mW Surface Mount SOT-223 (TO-261) | https://www.digikey.jp/en/products/detail/onsemi/NSV1C201MZ4T1G/4848737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 | NSV1C201MZ4T1G | 1
26 | Q3-Q14 | TSM2323 | Package_TO_SOT_SMD:SOT-23 | https://www.taiwansemi.com/assets/uploads/datasheet/TSM2323_F15.pdf | P-Channel 20 V 4.7A (Ta) 1.25W (Ta) Surface Mount SOT-23 | https://www.digikey.jp/en/products/detail/taiwan-semiconductor-corporation/TSM2323CX-RFG/7360264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 | TSM2323CX RFG | 12
27 | R1, R2, R10 | 470R | Resistor_SMD:R_0603_1608Metric | https://www.yageo.com/upload/media/product/products/datasheet/rchip/PYu-RC_Group_51_RoHS_L_12.pdf | 470 Ohms ±5% 0.1W, 1/10W Chip Resistor 0603 (1608 Metric) Moisture Resistant Thick Film | https://www.digikey.jp/en/products/detail/yageo/RC0603JR-07470RL/726791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 | RC0603JR-07470RL | 3
28 | R5 | 1.5K | Resistor_SMD:R_0603_1608Metric | https://www.yageo.com/upload/media/product/products/datasheet/rchip/PYu-RC_Group_51_RoHS_L_12.pdf | 1.5 kOhms ±5% 0.1W, 1/10W Chip Resistor 0603 (1608 Metric) Moisture Resistant Thick Film | https://www.digikey.jp/en/products/detail/yageo/RC0603JR-071K5L/726689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 | RC0603JR-071K5L | 1
29 | R6-R8, R35, R36 | 4.7K | Resistor_SMD:R_0603_1608Metric | https://www.yageo.com/upload/media/product/products/datasheet/rchip/PYu-RC_Group_51_RoHS_L_12.pdf | 4.7 kOhms ±5% 0.1W, 1/10W Chip Resistor 0603 (1608 Metric) Moisture Resistant Thick Film | https://www.digikey.jp/en/products/detail/yageo/RC0603JR-074K7L/726785 | RC0603JR-074K7L | 5
30 | R9, R11, R12, R14 | 470K ±0.1% 250mW | Resistor_SMD:R_0805_2012Metric | https://industrial.panasonic.com/cdbs/www-data/pdf/RDM0000/AOA0000C328.pdf | 470 kOhms ±0.1% 0.25W, 1/4W Chip Resistor 0805 (2012 Metric) Automotive AEC-Q200, Pulse Withstanding Thick Film | https://www.digikey.jp/en/products/detail/panasonic-electronic-components/ERJ-PB6B4703V/6213681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 | ERJ-PB6B4703V | 4
31 | R13 | 0.1MR 1% 15W | Resistor_SMD:R_PSR500HTQFB0L10_Metric_Pad5.2x8.75mm_HandSolder | https://fscdn.rohm.com/en/products/databook/datasheet/passive/resistor/chip_resistor/psr-e.pdf | 100 uOhms ±1% 15W Chip Resistor Nonstandard Automotive AEC-Q200, Current Sense Metal Element | https://www.digikey.jp/en/products/detail/rohm-semiconductor/PSR500HTQFB0L10/17140191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 | PSR500HTQFB0L10 | 1
32 | R15 | 1K ±0.1% 250mW | Resistor_SMD:R_0805_2012Metric | https://industrial.panasonic.com/cdbs/www-data/pdf/RDM0000/AOA0000C328.pdf | 1 kOhms ±0.1% 0.25W, 1/4W Chip Resistor 0805 (2012 Metric) Automotive AEC-Q200, Pulse Withstanding Thick Film | https://www.digikey.jp/en/products/detail/panasonic-electronic-components/ERJ-PB6B1001V/6213377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 | ERJ-PB6B1001V | 1
33 | R16-R18, R24-R27, R32 | 1K | Resistor_SMD:R_0603_1608Metric | https://www.vishay.com/docs/20035/dcrcwe3.pdf | 1 kOhms ±1% 0.1W, 1/10W Chip Resistor 0603 (1608 Metric) Automotive AEC-Q200 Thick Film | https://www.digikey.jp/en/products/detail/vishay-dale/CRCW06031K00FKEA/1179809 | CRCW06031K00FKEA | 8
34 | R19 | 10R | Resistor_SMD:R_0603_1608Metric | https://www.yageo.com/upload/media/product/app/datasheet/rchip/pyu-rc_group_51_rohs_l.pdf | 10 Ohms ±5% 0.1W, 1/10W Chip Resistor 0603 (1608 Metric) Moisture Resistant Thick Film | https://www.digikey.jp/en/products/detail/yageo/RC0603JR-0710RL/726699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 | RC0603JR-0710RL | 1
35 | R20-R23, R53, R54,R58， R61, R69, R72, R75, R78, R81, R84, R87, R90, R93, R96, R99, R102 | 100R | Resistor_SMD:R_0603_1608Metric | https://www.yageo.com/upload/media/product/app/datasheet/rchip/pyu-rc_group_51_rohs_l.pdf | 100 Ohms ±1% 0.1W, 1/10W Chip Resistor 0603 (1608 Metric) Moisture Resistant Thick Film | https://www.digikey.jp/en/products/detail/yageo/RC0603FR-07100RL/726888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 | RC0603FR-07100RL | 20
36 | R28, R29 | 5.6K | Resistor_SMD:R_0603_1608Metric | https://www.yageo.com/upload/media/product/productsearch/datasheet/rchip/PYu-RC_Group_51_RoHS_L_12.pdf | 5.6 kOhms ±5% 0.1W, 1/10W Chip Resistor 0603 (1608 Metric) Moisture Resistant Thick Film | https://www.digikey.jp/en/products/detail/yageo/RC0603JR-075K6L/726799 | RC0603JR-075K6L | 2
37 | R30, R31, R70, R73, R76, R79, R82, R85, R88, R91, R94, R97, R100, R103 | 3.3K | Resistor_SMD:R_0603_1608Metric | https://www.yageo.com/upload/media/product/app/datasheet/rchip/pyu-rc_group_51_rohs_l.pdf | 3.3 kOhms ±1% 0.1W, 1/10W Chip Resistor 0603 (1608 Metric) Moisture Resistant Thick Film | https://www.digikey.jp/en/products/detail/yageo/RC0603FR-073K3L/727126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 | RC0603FR-073K3L | 14
38 | R33, R34 | 33K | Resistor_SMD:R_0603_1608Metric | https://www.yageo.com/upload/media/product/app/datasheet/rchip/pyu-rc_group_51_rohs_l.pdf | 33 kOhms ±1% 0.1W, 1/10W Chip Resistor 0603 (1608 Metric) Moisture Resistant Thick Film | https://www.digikey.jp/en/products/detail/yageo/RC0603FR-0733KL/727159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 | RC0603FR-0733KL | 2
39 | R37, R62-R65, R67 | 100K | Resistor_SMD:R_0603_1608Metric | https://www.yageo.com/upload/media/product/app/datasheet/rchip/pyu-rc_group_51_rohs_l.pdf | 100 kOhms ±5% 0.1W, 1/10W Chip Resistor 0603 (1608 Metric) Moisture Resistant Thick Film | https://www.digikey.jp/en/products/detail/yageo/RC0603JR-07100KL/726698 | RC0603JR-07100KL | 6
40 | R38 | 22.1K | Resistor_SMD:R_0603_1608Metric | https://www.seielect.com/catalog/sei-rmcf_rmcp.pdf | 22.1 kOhms ±1% 0.1W, 1/10W Chip Resistor 0603 (1608 Metric) Automotive AEC-Q200 Thick Film | https://www.digikey.jp/en/products/detail/stackpole-electronics-inc/RMCF0603FT22K1/1760764 | RMCF0603FT22K1 | 1
41 | R43, R51, R52 | 10K | Resistor_SMD:R_0603_1608Metric | https://www.seielect.com/catalog/sei-rmcf_rmcp.pdf | 10 kOhms ±1% 0.1W, 1/10W Chip Resistor 0603 (1608 Metric) Automotive AEC-Q200 Thick Film | https://www.digikey.jp/en/products/detail/stackpole-electronics-inc/RMCF0603FT10K0/1761235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 | RMCF0603FT10K0 | 3
42 | R44, R60 | 806R | Resistor_SMD:R_0603_1608Metric | https://www.yageo.com/upload/media/product/app/datasheet/rchip/pyu-rc_group_51_rohs_l.pdf | 806 Ohms ±1% 0.1W, 1/10W Chip Resistor 0603 (1608 Metric) Moisture Resistant Thick Film | https://www.digikey.jp/en/products/detail/yageo/RC0603FR-07806RL/727397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 | RC0603FR-07806RL | 2
43 | R45, R46 | 51R | Resistor_SMD:R_0603_1608Metric | https://www.yageo.com/upload/media/product/productsearch/datasheet/rchip/PYu-RC_Group_51_RoHS_L_12.pdf | 51 Ohms ±5% 0.1W, 1/10W Chip Resistor 0603 (1608 Metric) Moisture Resistant Thick Film | https://www.digikey.jp/en/products/detail/yageo/RC0603JR-0751RL/726803 | RC0603JR-0751RL | 2
44 | R47, R59, R66 | 1.2K | Resistor_SMD:R_0603_1608Metric | https://www.yageo.com/upload/media/product/productsearch/datasheet/rchip/PYu-RC_Group_51_RoHS_L_12.pdf | 1.2 kOhms ±5% 0.1W, 1/10W Chip Resistor 0603 (1608 Metric) Moisture Resistant Thick Film | https://www.digikey.jp/en/products/detail/yageo/RC0603JR-071K2L/726683 | RC0603JR-071K2L | 3
45 | R48 | 2K | Resistor_SMD:R_0603_1608Metric | https://www.yageo.com/upload/media/product/app/datasheet/rchip/pyu-rc_group_51_rohs_l.pdf | 2 kOhms ±1% 0.1W, 1/10W Chip Resistor 0603 (1608 Metric) Moisture Resistant Thick Film | https://www.digikey.jp/en/products/detail/yageo/RC0603FR-072KL/727009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 | RC0603FR-072KL | 1
46 | R49, R50, R55, R57 | 0 | Resistor_SMD:R_0603_1608Metric | https://www.yageo.com/upload/media/product/products/datasheet/rchip/PYu-RC_Group_51_RoHS_L_12.pdf | 0 Ohms Jumper Chip Resistor 0603 (1608 Metric) Moisture Resistant Thick Film | https://www.digikey.jp/en/products/detail/yageo/RC0603JR-070RL/726675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 | RC0603JR-070RL | 4
47 | R56 | 1M | Resistor_SMD:R_0603_1608Metric | https://www.yageo.com/upload/media/product/app/datasheet/rchip/pyu-rc_group_51_rohs_l.pdf | 1 MOhms ±5% 0.1W, 1/10W Chip Resistor 0603 (1608 Metric) Moisture Resistant Thick Film | https://www.digikey.jp/en/products/detail/yageo/RC0603JR-071ML/726678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 | RC0603JR-071ML | 1
48 | R68, R71, R74, R77, R80, R83, R86, R89, R92, R95, R98, R101 | 36R 1W 2512 | Resistor_SMD:R_2512_6332Metric | https://www.seielect.com/catalog/sei-rmcf_rmcp.pdf | 36 Ohms ±5% 1W Chip Resistor 2512 (6432 Metric) Automotive AEC-Q200 Thick Film | https://www.digikey.jp/en/products/detail/stackpole-electronics-inc/RMCF2512JT36R0/1716346 | RTT25360JTE | 12
49 | TH1 | 100K NTC | Resistor_SMD:R_0603_1608Metric | https://www.tdk-electronics.tdk.com/inf/50/db/ntc/NTC_SMD_Automotive_series_0603.pdf | NTC Thermistor 100k 0603 (1608 Metric) | https://www.digikey.jp/en/products/detail/epcos-tdk-electronics/B57355V5104F360/7347813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 | B57355V5104F360 | 1
50 | TH2-TH5 | 100K NTC | Resistor_THT:R_Axial_DIN0204_L3.6mm_D1.6mm_P1.90mm_Vertical | https://www.cantherm.com/wp-content/uploads/2017/05/cantherm_mf52_1.pdf | THERM NTC 100KOHM 4150K BEAD | https://www.digikey.jp/en/products/detail/cantherm/MF52C1104F4150/1840605 | MF52C1104F4150 | 4
51 | TR1 | Transformer | Connector_Wuerth:WURTH-760390015 | https://mm.digikey.com/Volume0/opasdata/d220001/medias/docus/2416/760390015%20Dwg.pdf | Forward, Push-Pull Converters For For DC/DC Converters SMPS Transformer 3125Vrms Isolation 10kHz Surface Mount | https://www.digikey.jp/en/products/detail/w%C3%BCrth-elektronik/760390015/3831267 | 760390015 | 1
52 | TR2-TR4 | HM2108NL | Transformer_SMD:HM2108NL | https://productfinder.pulseelectronics.com/api/open/part-attachments/datasheet/HM2108NL | 135uH Pulse Transformer Surface Mount | https://www.digikey.jp/en/products/detail/pulse-electronics/HM2108NL/7914611 | HM2108NL | 3
53 | U1 | TPS76350 | Package_TO_SOT_SMD:SOT-23-5 | chrome-extension://efaidnbmnnnibpcajpcglclefindmkaj/https://www.ti.com.cn/cn/lit/ds/symlink/tps763-q1.pdf?ts=1710725186011 | Linear Voltage Regulator IC Positive Fixed 1 Output 150mA SOT-23-5 | https://www.digikey.jp/en/products/detail/texas-instruments/TPS76350DBVR/382163 | TPS76350DBVR | 1
54 | U2,U3 | AMC1301 | Package_SO:SSO-8_6.8x5.9mm_P1.27mm_Clearance8mm | https://www.ti.com/lit/ds/symlink/amc1301.pdf?HQS=dis-dk-null-digikeymode-dsf-pf-null-wwe&ts=1697614208280 | Isolation Amplifier 1 Circuit 8-SOIC | https://www.digikey.jp/en/products/detail/texas-instruments/AMC1301DWV/6131500 | AMC1301DWV | 2
55 | U4 | SN6501DBV | Package_TO_SOT_SMD:SOT-23-5 | https://www.ti.com.cn/cn/lit/ds/symlink/sn6501.pdf?ts=1707800085827 | Transformer Driver PMIC SOT-23-5 | https://www.digikey.jp/en/products/detail/texas-instruments/SN6501DBVR/3431175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 | SN6501DBVR | 1
56 | U5 | OPA2197IDR | PCM_4ms_Package_SOIC:SOIC-8_3.9x4.9mm_Pitch1.27mm | https://www.ti.com/lit/ds/symlink/opa2197.pdf?HQS=dis-dk-null-digikeymode-dsf-pf-null-wwe&ts=1698207032697 | General Purpose Amplifier 2 Circuit Rail-to-Rail 8-SOIC | https://www.digikey.jp/en/products/detail/texas-instruments/OPA2197IDR/6175210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 | OPA2197IDR | 1
57 | U6 | ISL28022 | PCM_4ms_Package_SSOP:MSOP-10_3x3mm_P0.5mm | https://www.renesas.com/us/en/document/dst/isl28022-datasheet | Power Supply Controller Power Supply Monitor 10-MSOP | https://www.digikey.jp/en/products/detail/renesas-electronics-america-inc/ISL28022FUZ-T7A/4765786 | ISL28022FUZ-T7A | 1
58 | U7 | LMR51420XDDCR | Package_TO_SOT_SMD:SOT-23-6_Handsoldering | https://www.ti.com/lit/ds/symlink/lmr51420.pdf | Buck Switching Regulator IC Positive Adjustable 0.6V 1 Output 2A SOT-23-6 Thin, TSOT-23-6 | https://www.digikey.jp/en/products/detail/texas-instruments/LMR51420XDDCR/16705125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 | LMR51420XDDCR | 1
59 | U8 | ESP32-DevKitC V4 | RF_Module:ESP32-DevKitc V4_DIP-38_27.9mm脳48.2mm | https://mm.digikey.com/Volume0/opasdata/d220001/medias/docus/754/ESP32-DevKitC_GSG_Ver1.4_2017.pdf | - ESP32-WROOM-32E Transceiver; 802.11 b/g/n (Wi-Fi, WiFi, WLAN), Bluetooth庐 Smart Ready 4.x Dual Mode 2.4GHz Evaluation Board | https://www.digikey.jp/en/products/detail/espressif-systems/ESP32-DEVKITC-32E/12091810 | ESP32-DEVKITC-32E | 1
60 | U9 | LTC6820 | Package_SO:MSOP-16_3x4mm_P0.5mm | https://www.analog.com/media/en/technical-documentation/data-sheets/LTC6820.pdf | Isolated Communications Interface Interface 16-MSOP | https://www.digikey.jp/en/products/detail/analog-devices-inc/LTC6820IMS-PBF/3838555 | LTC6820IMS#PBF | 1
61 | U10 | CP2104 | Package_DFN_QFN:HVQFN-24-1EP_4x4mm_P0.5mm_EP2.6x2.6mm | https://www.silabs.com/documents/public/data-sheets/cp2104.pdf | USB Bridge, USB to UART USB 2.0 UART Interface 24-QFN (4x4) | https://www.digikey.jp/en/products/detail/silicon-labs/CP2104-F03-GM/2486177 | CP2104-F03-GM | 1
62 | U12 | LTC6811HG-1 | Package_SO:TSSOP-48_6.1x12.5mm_P0.5mm | https://www.analog.com/media/en/technical-documentation/data-sheets/LTC6811-1-6811-2.pdf | Battery Battery Monitor IC Multi-Chemistry 48-SSOP | https://www.digikey.jp/en/products/detail/analog-devices-inc/LTC6811HG-1-3ZZPBF/9739208 | LTC6811HG-1#3ZZPBF | 1
