tetra-aero/LTC6811_ESP32/LTC6811_ESP32_V5/Slaves/LTC6811_ESP32_V5.step

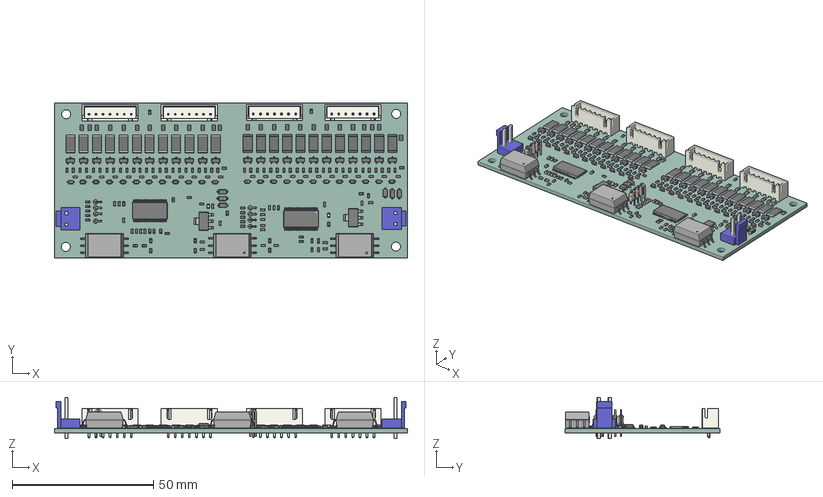
[picture p3: CAD file, 2024-09-13, an earlier design]
LTC6811_ESP32_V5/Slaves/LTC6811_ESP32_V5.step
125.0 x 55.0 x 14.6 mm
D_SOD_123 x 4
R_0603_1608Metric x 86
SOT_23 x 24
D_SOD_323 x 24
Fuse_0805_2012Metric x 26
B2P-VH x 2
C_0603_1608Metric x 52
R_Axial_DIN0204_L36mm_D16mm_P190mm_Vertical x 8
R_2512_6332Metric x 24
JST_B7B_XH_A x 4
TSSOP_48_61x125mm_P05mm x 2
D_SOD_123F x 2
LED_0603_1608Metric x 2
SOT_223 x 2
LTC6811_ESP32_Slaves_V5_PCB
