tetra-aero/LTC6811_ESP32/LTC6811_ESP32_V1p3/document/LTC6811_ESP32_V1p3.pdf

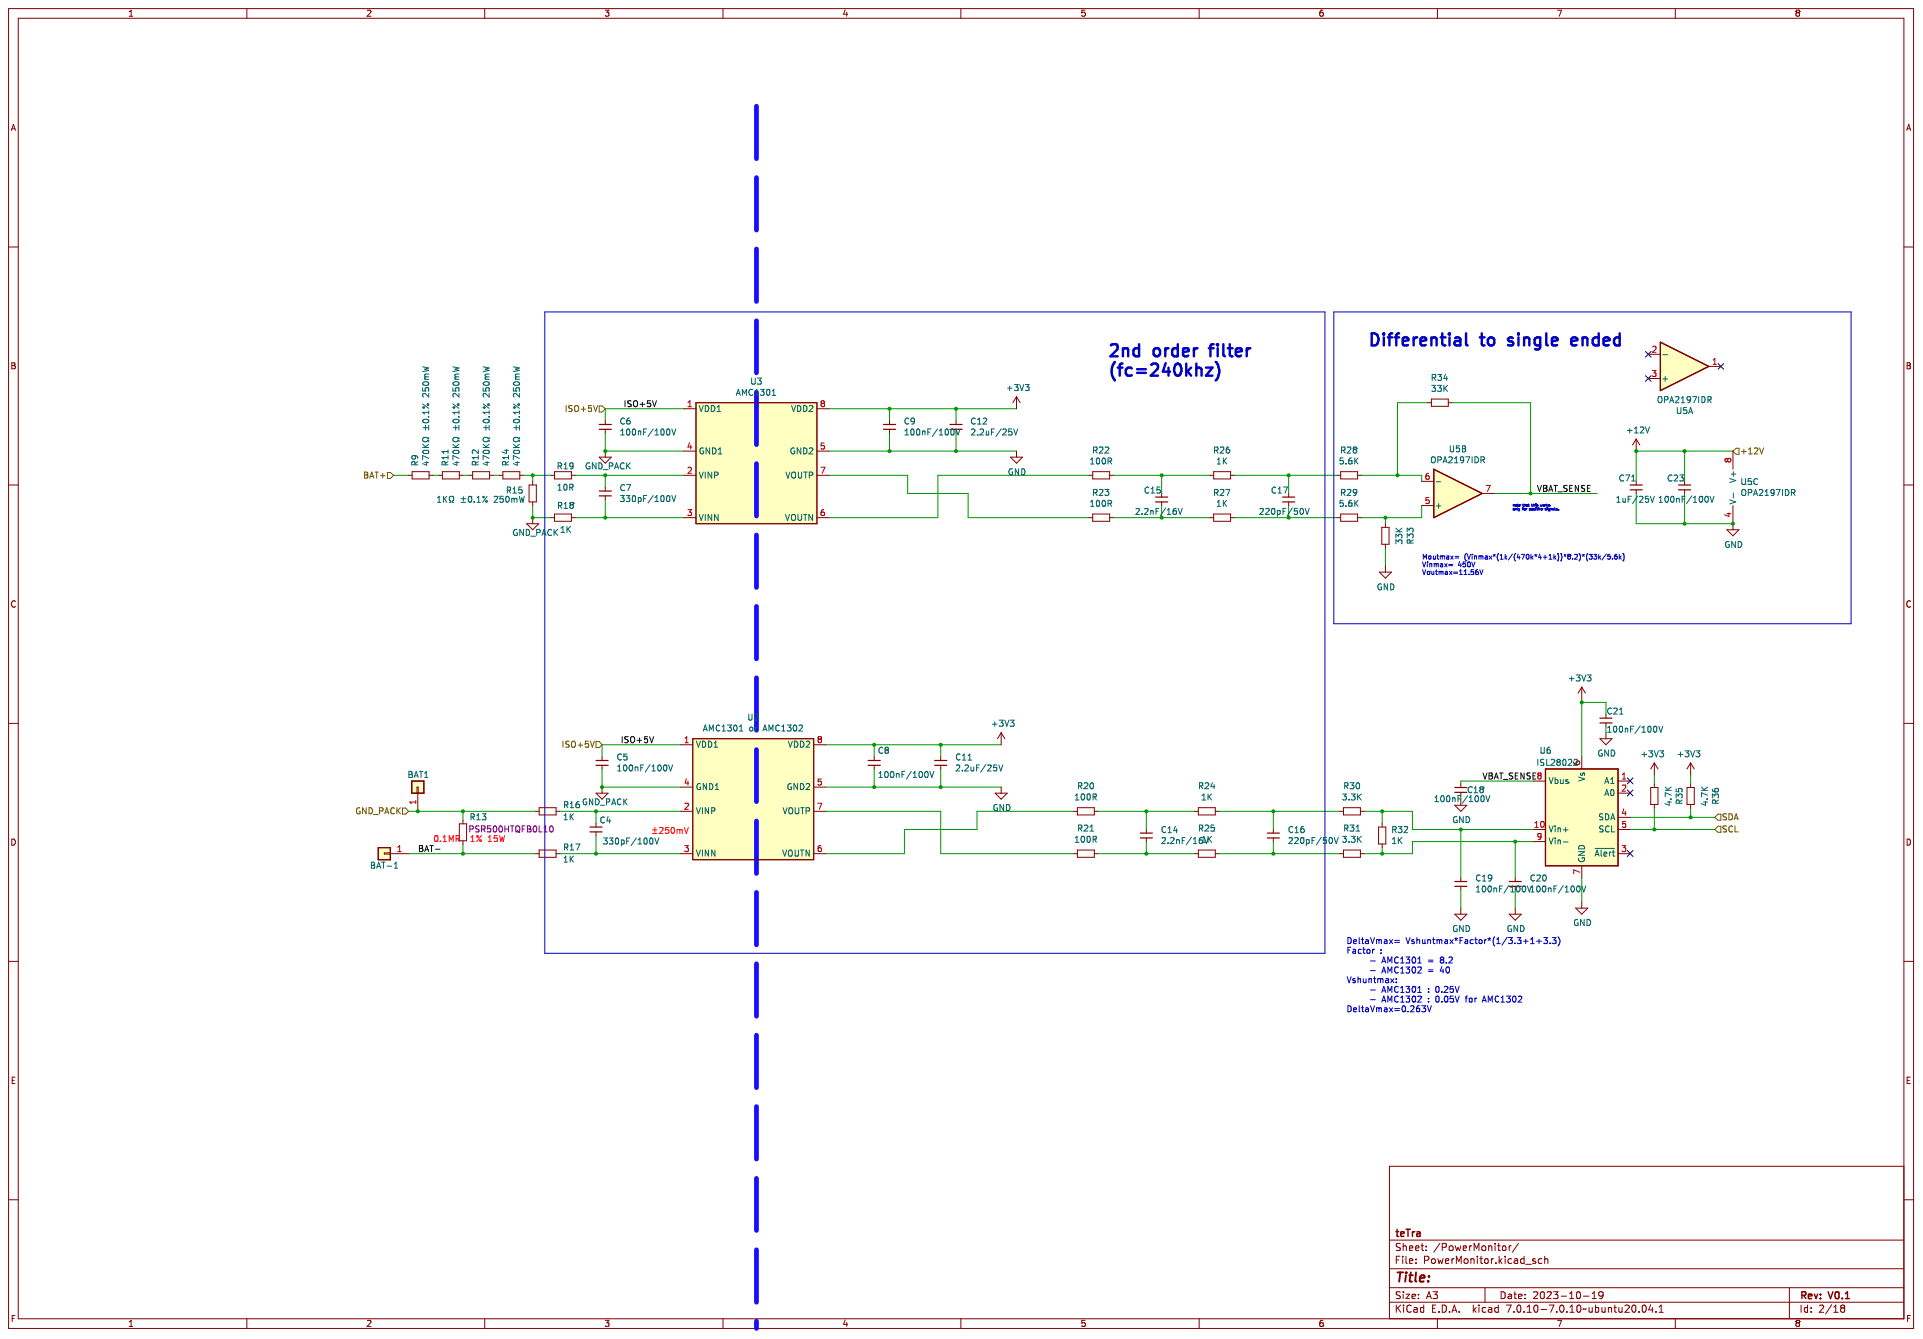
[picture p22: page 2]

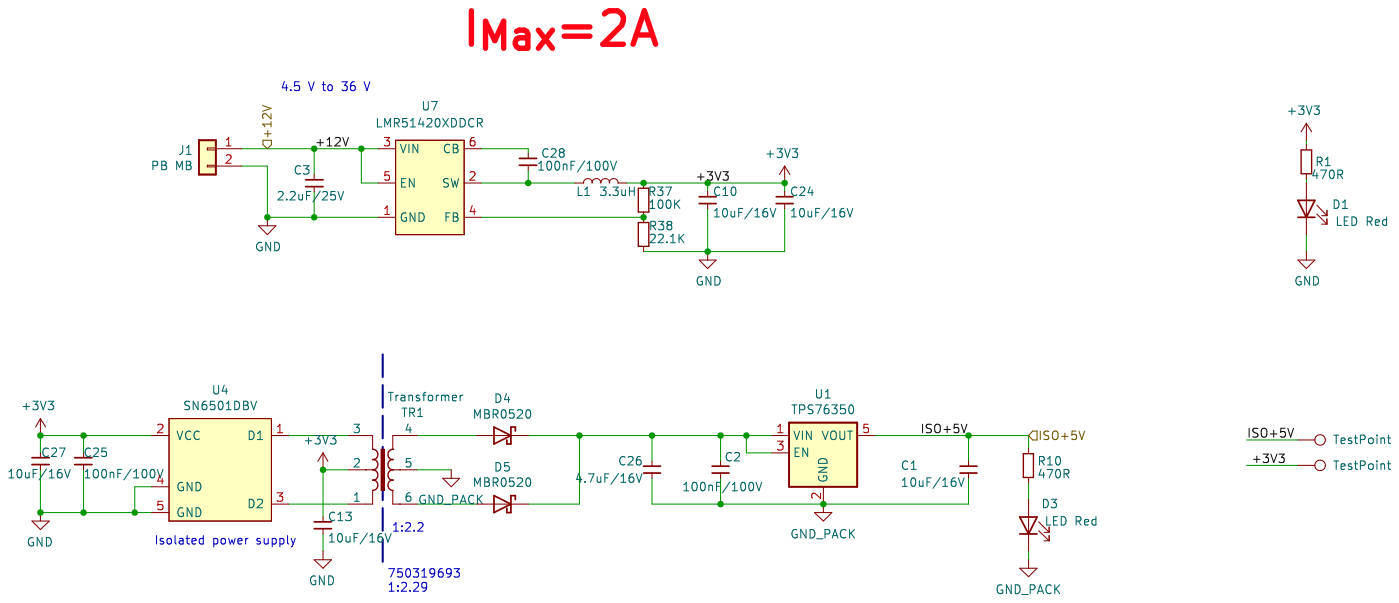
[picture p23: page 3]

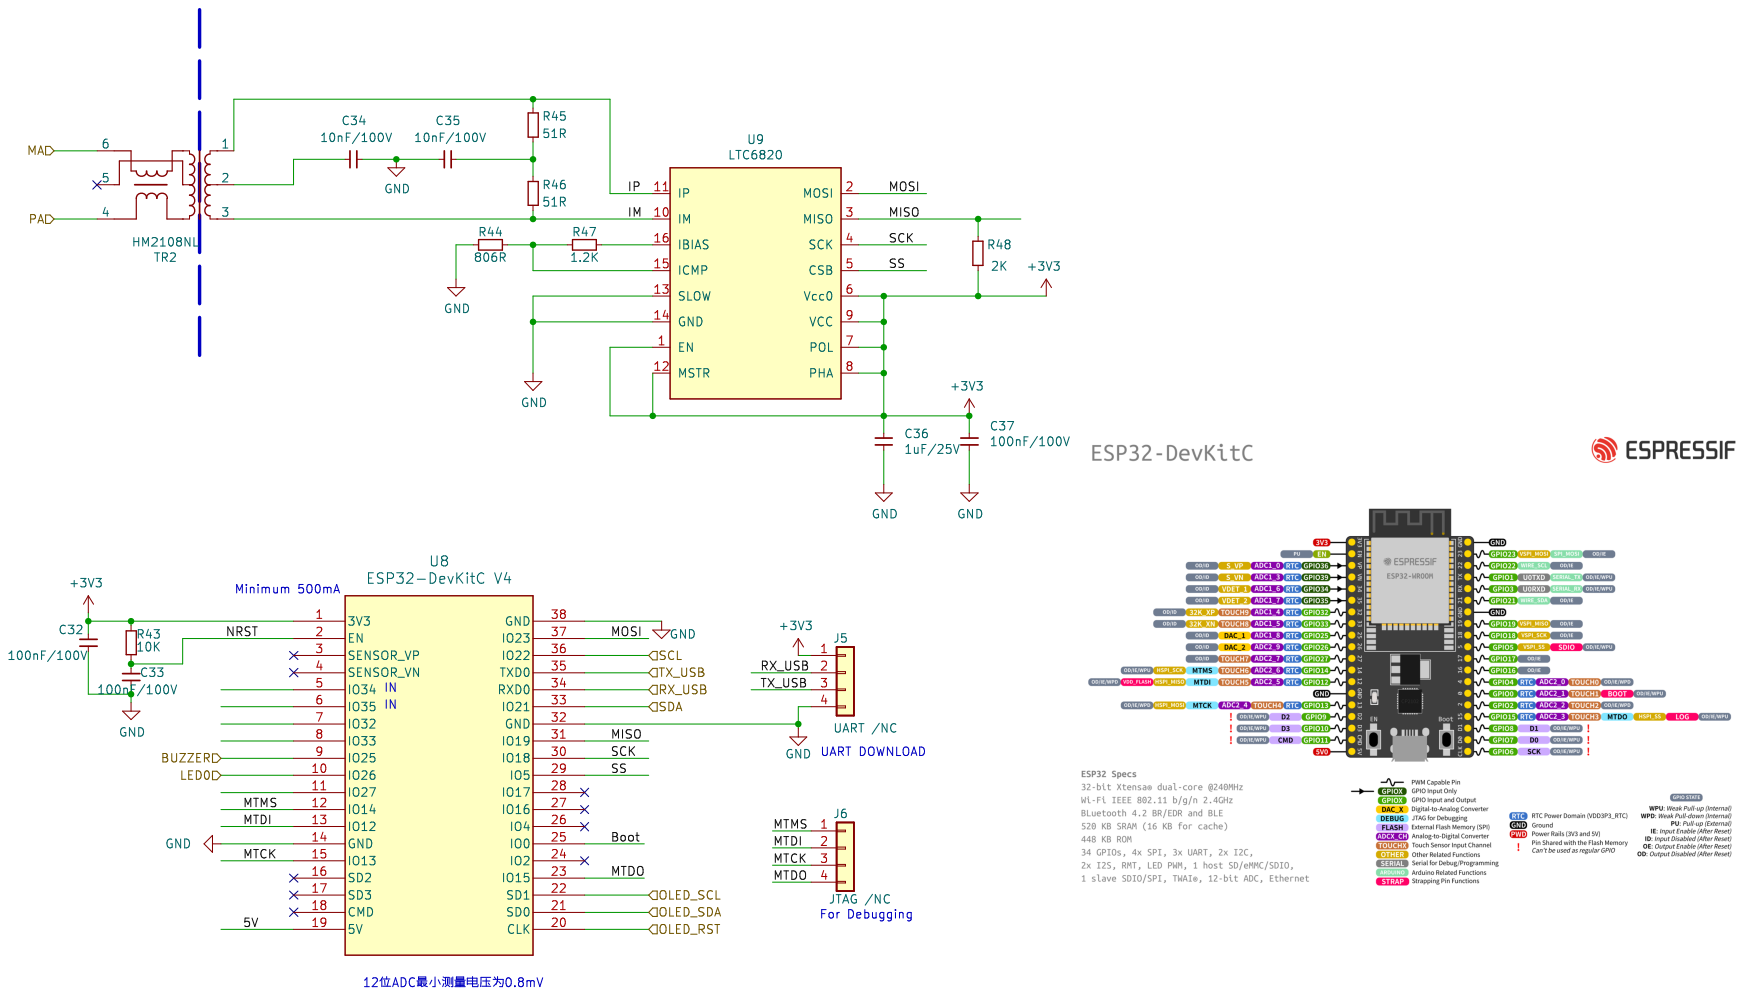
[picture p24: page 4]

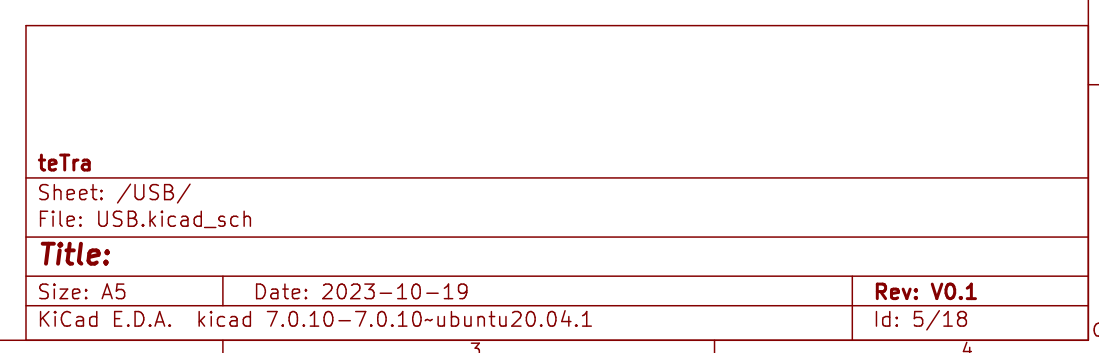
[picture p25: page 5]

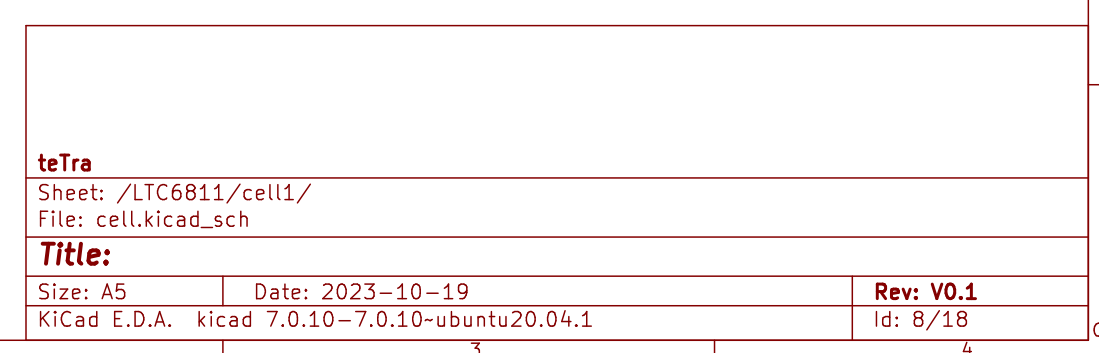
[picture p26: page 7]

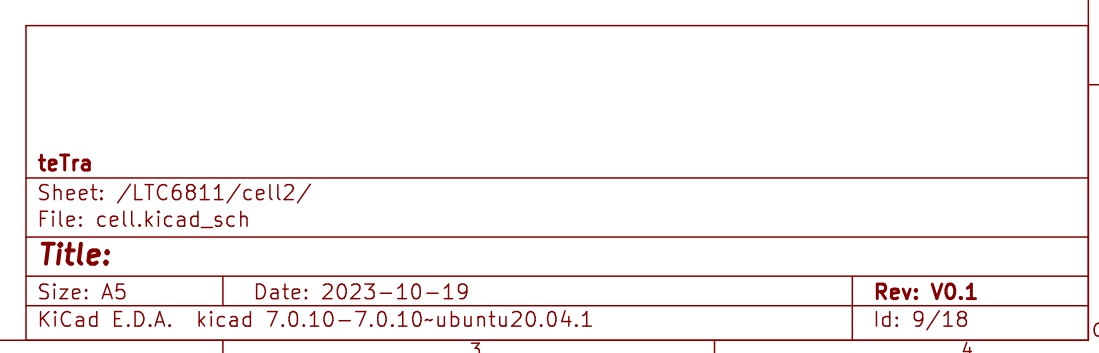
[picture p27: page 8]

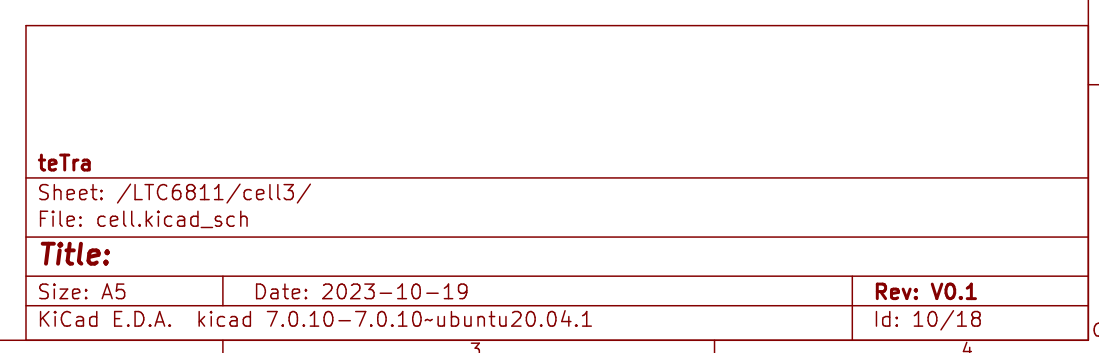
[picture p28: page 9]

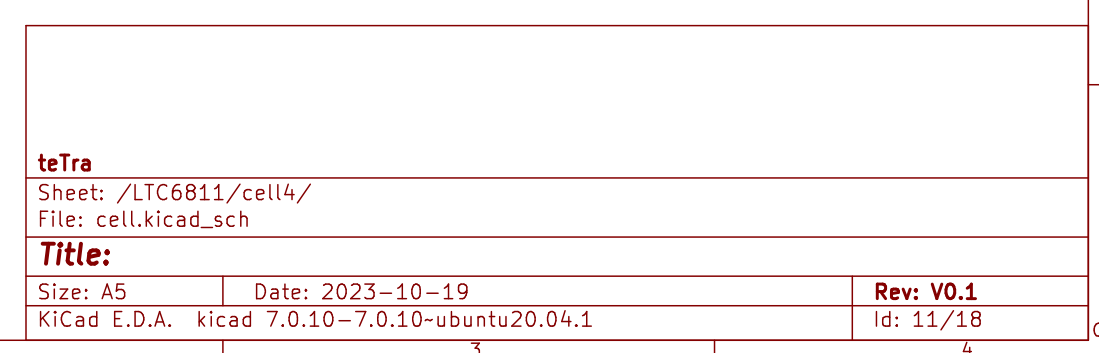
[picture p29: page 10]

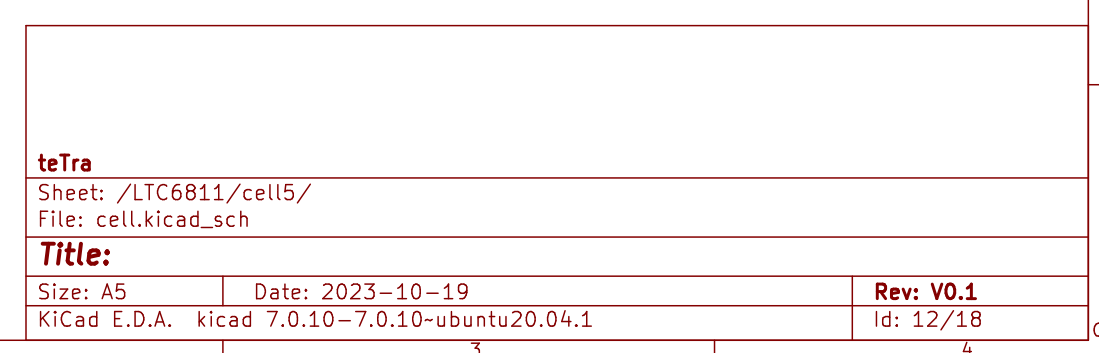
[picture p30: page 11]

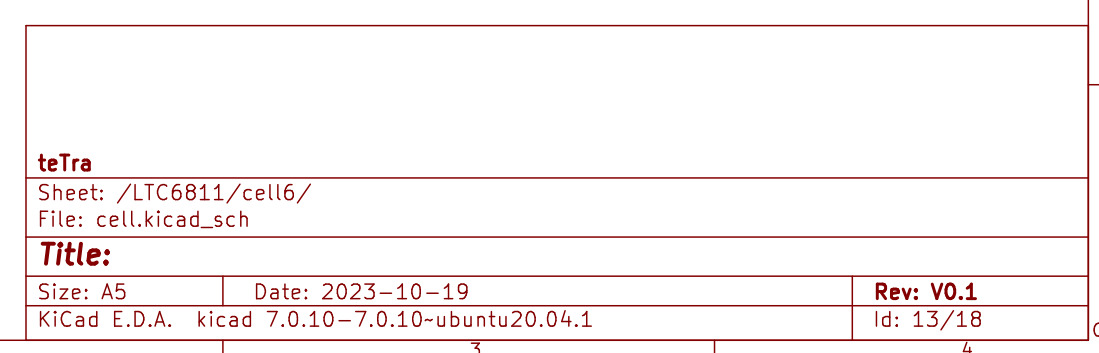
[picture p31: page 12]

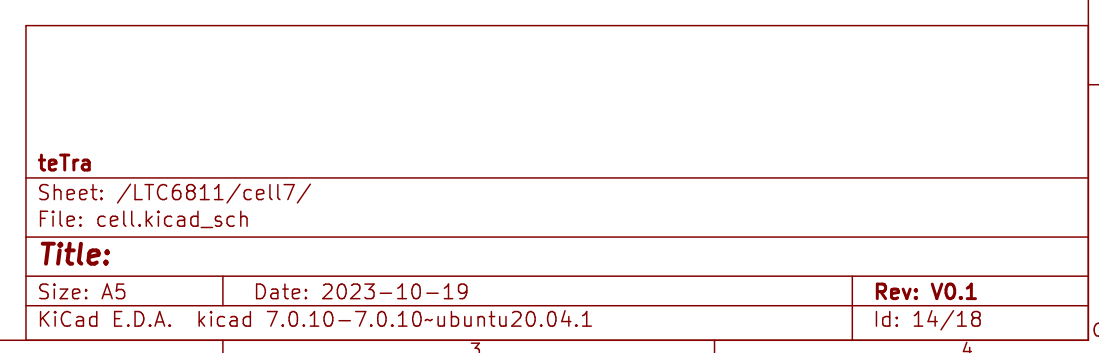
[picture p32: page 13]

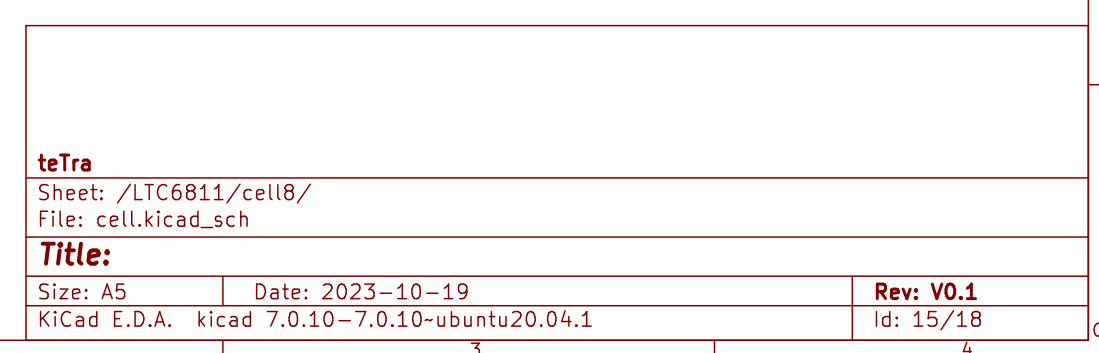
[picture p33: page 14]

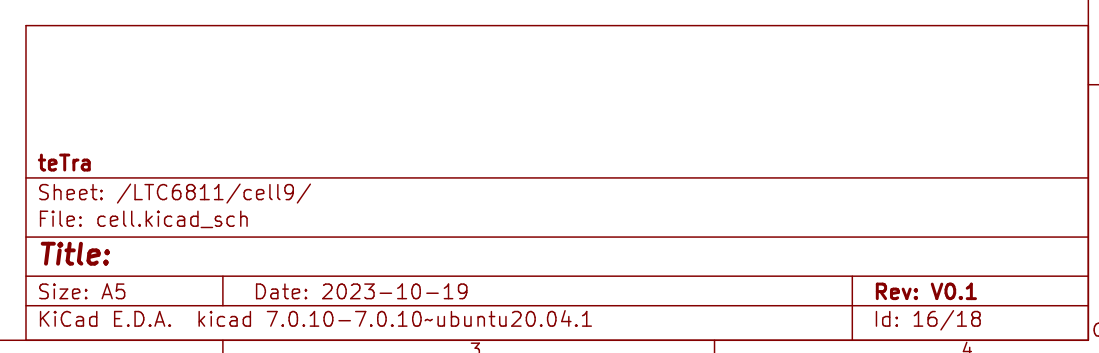
[picture p34: page 15]

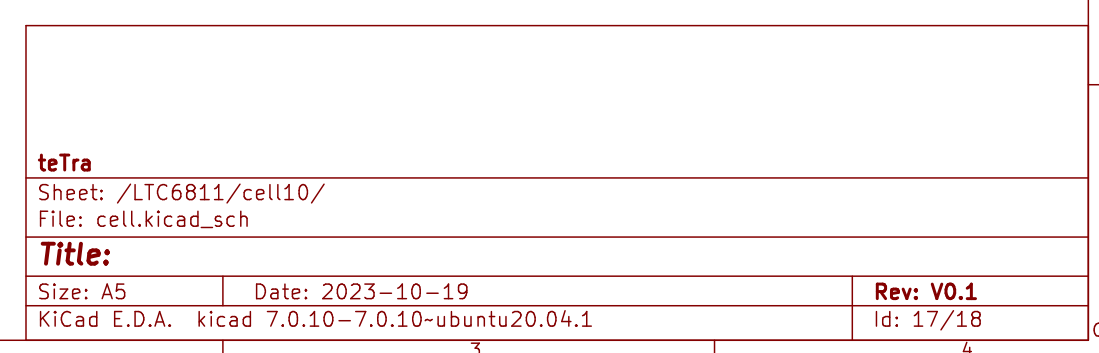
[picture p35: page 16]

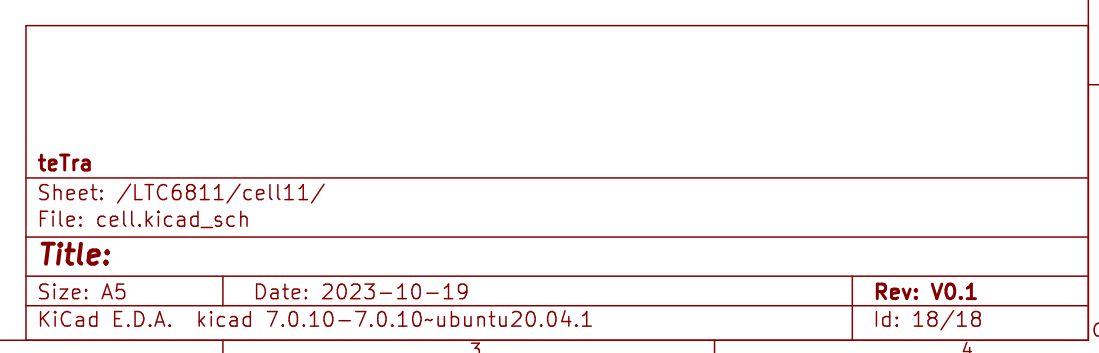
[picture p36: page 17]

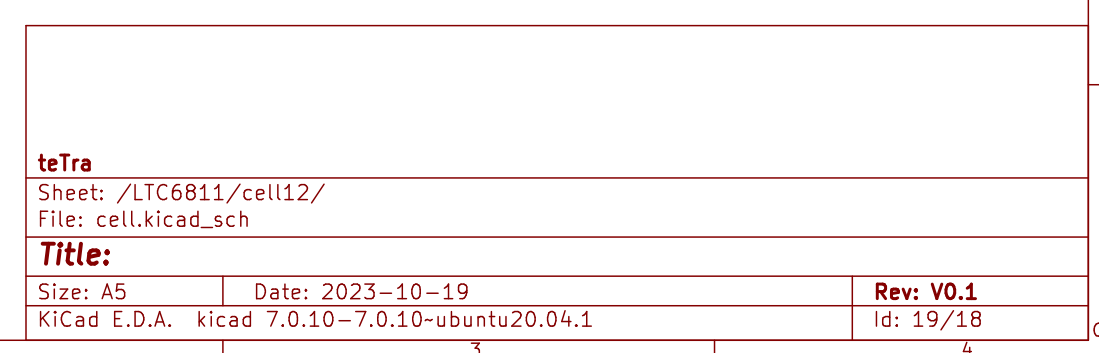
[picture p37: page 18]
