tetra-aero/LTC6811_ESP32/LTC6811_ESP32_V6/Master_V6P1/LTC6811_ESP32_Master_V6P1.kicad_pcb

## KiCad design LTC6811_ESP32_V6/Master_V6P1/LTC6811_ESP32_Master_V6P1.kicad_pcb (2025-11-14)

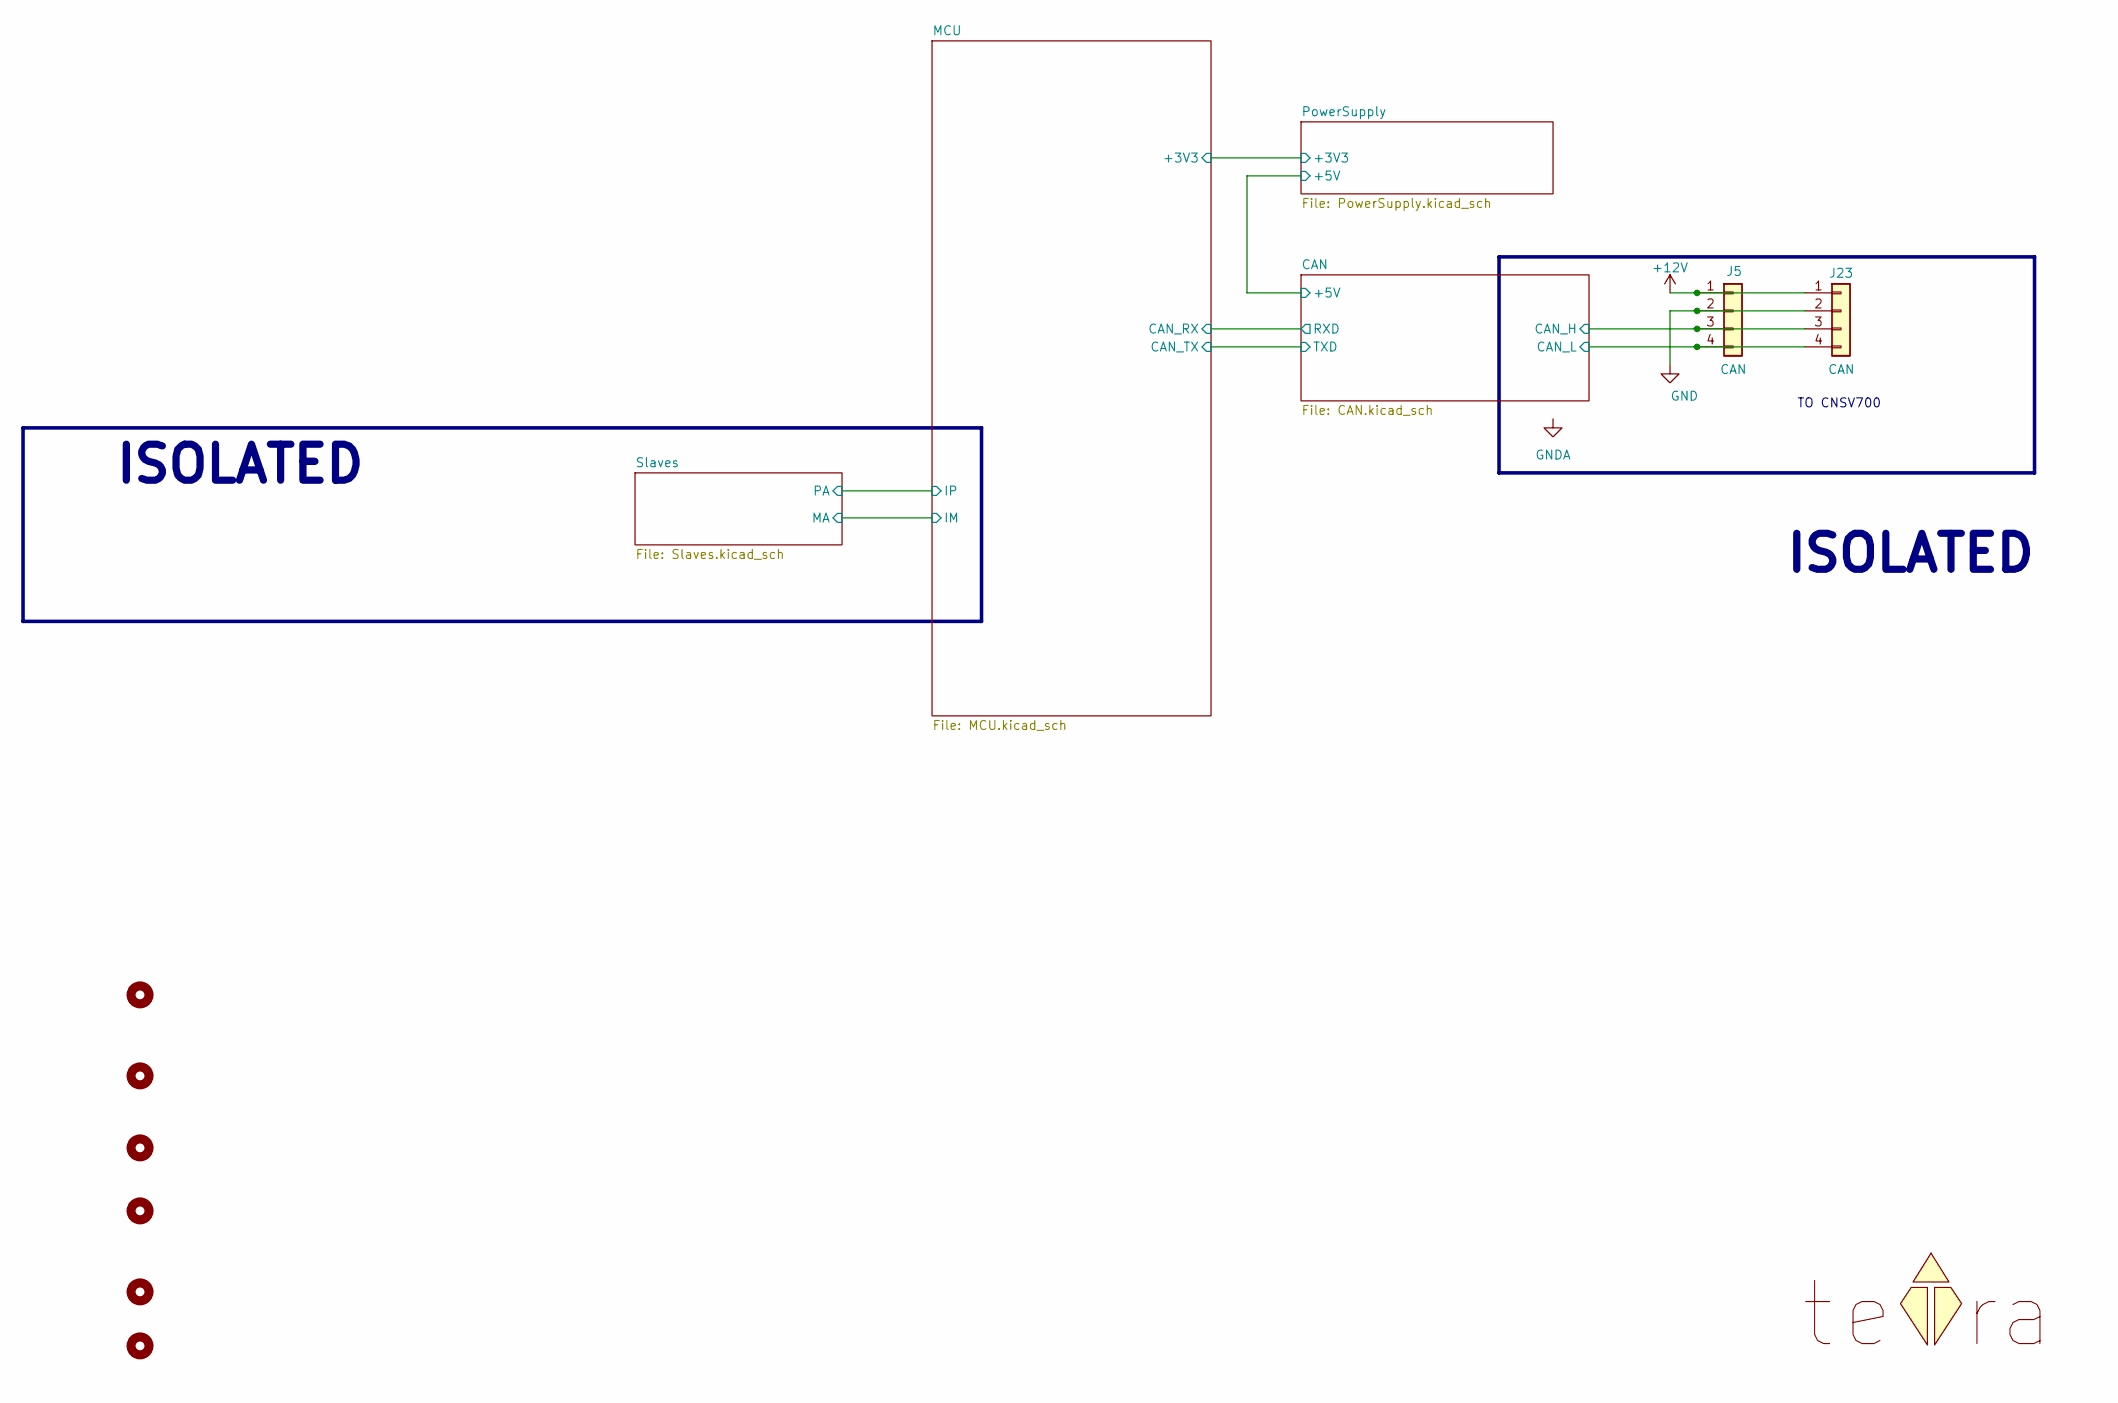
[picture p38: schematic LTC6811_ESP32_Master_V6P1.kicad_sch, BMS-Master]

Parts:
J3, J4, J7, J18, J19, J21: Hole /NC; MountingHole_3.2mm_M3_ISO7380; MPN N/A
J5, J23: CAN; JST_XH_B4B-XH-A_1x04_P2.50mm_Vertical; MPN B4B-XH-A
LOGO1: teTra /NC; teTra-LOGO

Connections:
+12V: J5.1, J23.1; also elsewhere on the board
/CAN/CAN_H: J5.3, J23.3; also elsewhere on the board
/CAN/CAN_L: J5.4, J23.4; also elsewhere on the board
GND: J5.2, J23.2; also elsewhere on the board

Notes on the sheet:
ISOLATED
TO CNSV700

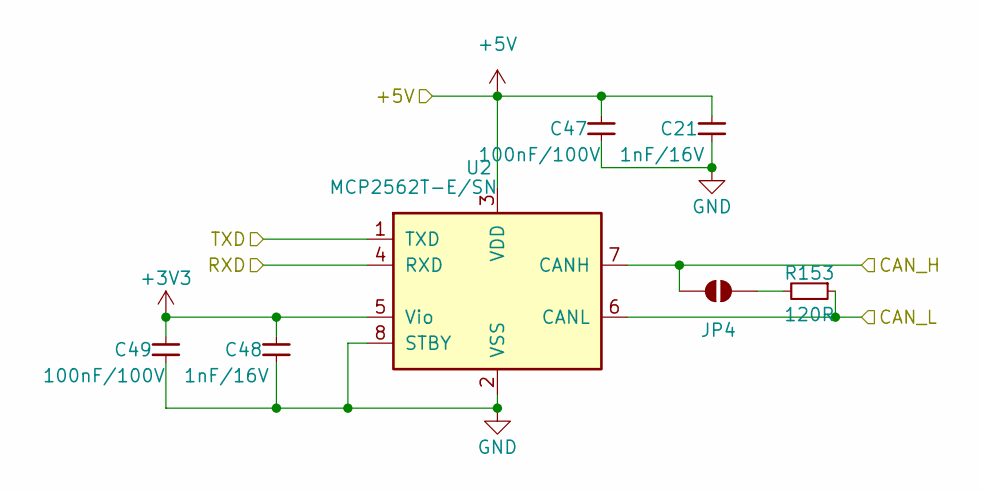
[picture p39: schematic CAN.kicad_sch]

Parts:
C21, C48: 1nF/16V; C_0603_1608Metric; MPN C0603C102K4RECAUTO
C47, C49: 100nF/100V; C_0603_1608Metric; MPN CL10B104KC8NNNC
JP4: SolderJumper_2_Open; SolderJumper-2_P1.3mm_Open_RoundedPad1.0x1.5mm
R153: 120R; R_0603_1608Metric; MPN RC0603JR-07120RL
U2: MCP2562T-E/SN; SOIC-8_3.9x4.9mm_P1.27mm; MPN MCP2562T-E/SN

Connections:
+3V3: C48.1, C49.1, U2.5 (Vio); also elsewhere on the board
+5V: C21.1, C47.1, U2.3 (VDD); also elsewhere on the board
/CAN/CAN_H: JP4.1 (A), U2.7 (CANH); also elsewhere on the board
/CAN/CAN_L: R153.1, U2.6 (CANL); also elsewhere on the board
/CAN/RXD: U2.4 (RXD); also elsewhere on the board
/CAN/TXD: U2.1 (TXD); also elsewhere on the board
GND: C21.2, C47.2, C48.2, C49.2, U2.2 (VSS), U2.8 (STBY); also elsewhere on the board
unnamed: JP4.2 (B), R153.2

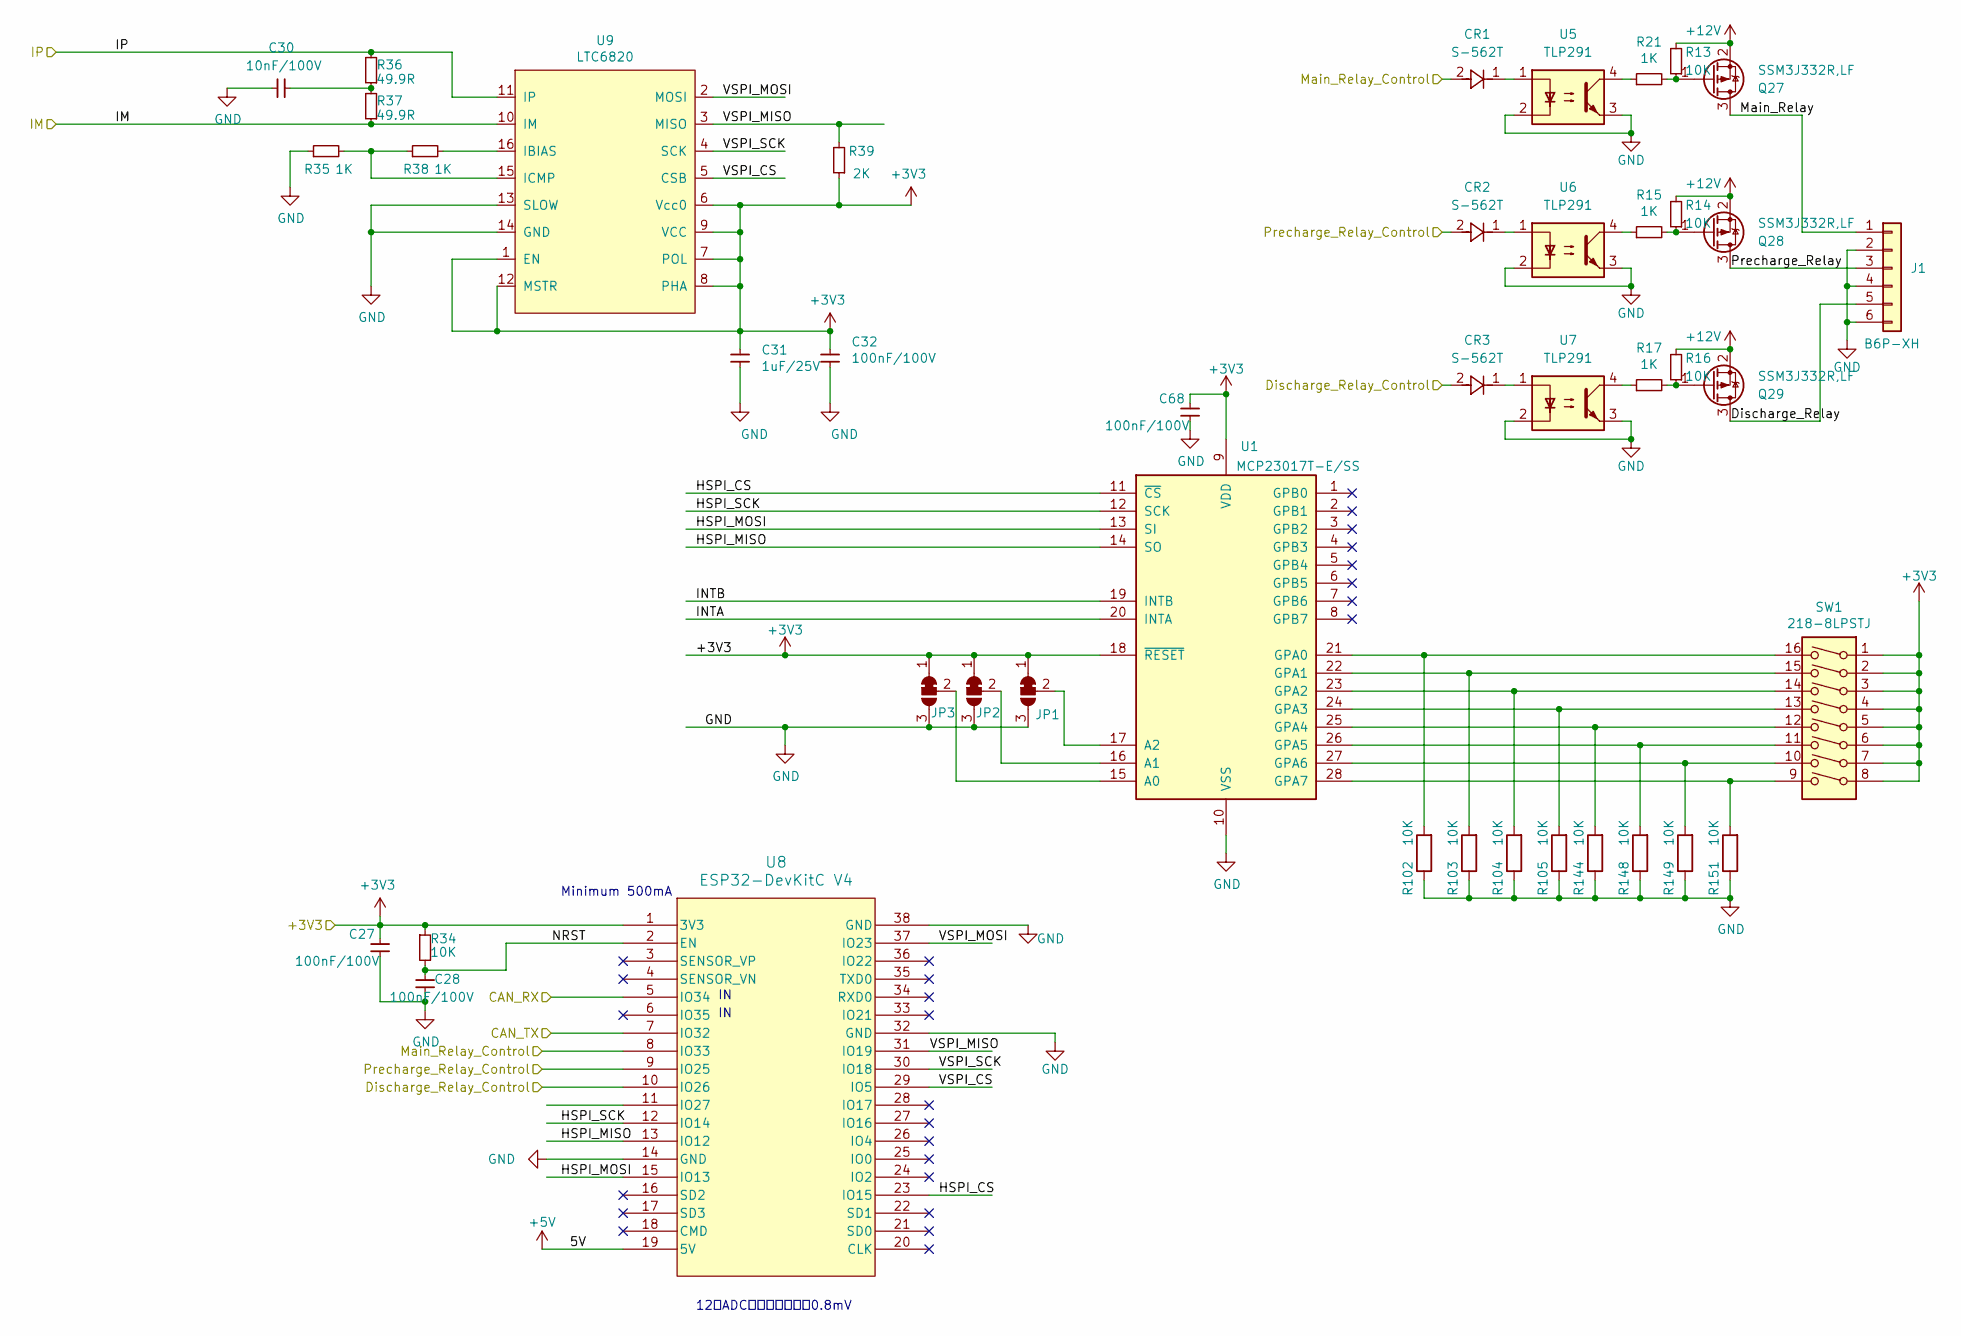
[picture p40: schematic MCU.kicad_sch]

Parts:
C27, C28, C32, C68: 100nF/100V; C_0603_1608Metric; MPN CL10B104KC8NNNC
C30: 10nF/100V; C_0603_1608Metric; MPN C0603X103K1RAC3316
C31: 1uF/25V; C_0603_1608Metric; MPN CL10B105KA8NNNC
CR1, CR2, CR3: S-562T; D_SOD-123F; MPN S-562T
J1: B6P-XH; JST_XH_B6B-XH-A_1x06_P2.50mm_Vertical; MPN B6B-XH-A
JP1, JP2, JP3: SolderJumper_3_Bridged12; SolderJumper-3_P1.3mm_Open_Pad1.0x1.5mm_NumberLabels
Q27, Q28, Q29: SSM3J332R,LF; TSOT-23; MPN SSM3J332R,LF
R13, R14, R16, R34, R102, R103, R104, R105, R144, R148, R149, R151: 10K; R_0603_1608Metric; MPN RC0603FR-071KL
R15, R17, R21, R35, R38: 1K; R_0603_1608Metric; MPN RC0603FR-071KL
R36, R37: 49.9R; R_0603_1608Metric; MPN ERJ-3EKF49R9V
R39: 2K; R_0603_1608Metric; MPN RC0603FR-072KL
SW1: 218-8LPSTJ; SW_218-8LPSTJ_11.33×6.05_P1.27; MPN 218-8LPSTJ
U1: MCP23017T-E/SS; SSOP-28_5.3x10.2mm_P0.65mm; MPN MCP23017T-E/SS
U5, U6, U7: TLP291; SOIC-4_4.55x2.6mm_P1.27mm; MPN TLP291(GR-TP,SE
U8: ESP32-DevKitC V4; ESP32-DevKitc V4_DIP-38_27.9mm×48.2mm; MPN ESP32-DEVKITC-32E
U9: LTC6820; MSOP-16_3x4mm_P0.5mm; MPN LTC6820IMS#PBF

Connections:
+3V3: C27.2, C31.2, C32.1, C68.2, JP1.1 (A), JP2.1 (A), JP3.1 (A), R34.1, R39.1, SW1.1, SW1.2, SW1.3, SW1.4, SW1.5, SW1.6, SW1.7, SW1.8, U1.9 (VDD), U1.18 (~RESET), U8.1 (3V3), U9.1 (EN), U9.6 (Vcc0), U9.7 (POL), U9.8 (PHA), U9.9 (VCC), U9.12 (MSTR); also elsewhere on the board
+5V: U8.19 (5V); also elsewhere on the board
+12V: Q27.2 (S), Q28.2 (S), Q29.2 (S), R13.2, R14.2, R16.2; also elsewhere on the board
/CAN/RXD: U8.5 (IO34); also elsewhere on the board
/CAN/TXD: U8.7 (IO32); also elsewhere on the board
/MCU/Discharge_Relay: J1.5, Q29.3 (D)
/MCU/Discharge_Relay_Control: CR3.2, U8.10 (IO26)
/MCU/HSPI_CS: U1.11 (~CS), U8.23 (IO15)
/MCU/HSPI_MISO: U1.14 (SO), U8.13 (IO12)
/MCU/HSPI_MOSI: U1.13 (SI), U8.15 (IO13)
/MCU/HSPI_SCK: U1.12 (SCK), U8.12 (IO14)
/MCU/IM: R37.1, U9.10 (IM); also elsewhere on the board
/MCU/INTA: U1.20 (INTA)
/MCU/INTB: U1.19 (INTB)
/MCU/IP: R36.2, U9.11 (IP); also elsewhere on the board
/MCU/Main_Relay: J1.1, Q27.3 (D)
/MCU/Main_Relay_Control: CR1.2, U8.8 (IO33)
/MCU/NRST: C28.2, R34.2, U8.2 (EN)
/MCU/Precharge_Relay: J1.3, Q28.3 (D)
/MCU/Precharge_Relay_Control: CR2.2, U8.9 (IO25)
/MCU/VSPI_CS: U8.29 (IO5), U9.5 (CSB)
/MCU/VSPI_MISO: R39.2, U8.31 (IO19), U9.3 (MISO)
/MCU/VSPI_MOSI: U8.37 (IO23), U9.2 (MOSI)
/MCU/VSPI_SCK: U8.30 (IO18), U9.4 (SCK)
GND: C27.1, C28.1, C30.1, C31.1, C32.2, C68.1, J1.2, J1.4, J1.6, JP1.3 (B), JP2.3 (B), JP3.3 (B), R35.1, R102.1, R103.1, R104.1, R105.1, R144.1, R148.1, R149.1, R151.1, U1.10 (VSS), U5.2, U5.3, U6.2, U6.3, U7.2, U7.3, U8.14 (GND), U8.32 (GND), U8.38 (GND), U9.13 (SLOW), U9.14 (GND); also elsewhere on the board
unnamed: C30.2, R36.1, R37.2
unnamed: CR1.1, U5.1
unnamed: CR2.1, U6.1
unnamed: CR3.1, U7.1
unnamed: JP1.2 (C), U1.17 (A2)
unnamed: JP2.2 (C), U1.16 (A1)
unnamed: JP3.2 (C), U1.15 (A0)
unnamed: Q27.1 (G), R13.1, R21.2
unnamed: Q28.1 (G), R14.1, R15.2
unnamed: Q29.1 (G), R16.1, R17.2
unnamed: R15.1, U6.4
unnamed: R17.1, U7.4
unnamed: R21.1, U5.4
unnamed: R102.2, SW1.16, U1.21 (GPA0)
unnamed: R103.2, SW1.15, U1.22 (GPA1)
unnamed: R104.2, SW1.14, U1.23 (GPA2)
unnamed: R105.2, SW1.13, U1.24 (GPA3)
unnamed: R144.2, SW1.12, U1.25 (GPA4)
unnamed: R148.2, SW1.11, U1.26 (GPA5)
unnamed: R149.2, SW1.10, U1.27 (GPA6)
unnamed: R151.2, SW1.9, U1.28 (GPA7)
unnamed: R38.2, U9.16 (IBIAS)
unnamed: R35.2, R38.1, U9.15 (ICMP)

Notes on the sheet:
12位ADC最小测量电压为0.8mV
Minimum 500mA

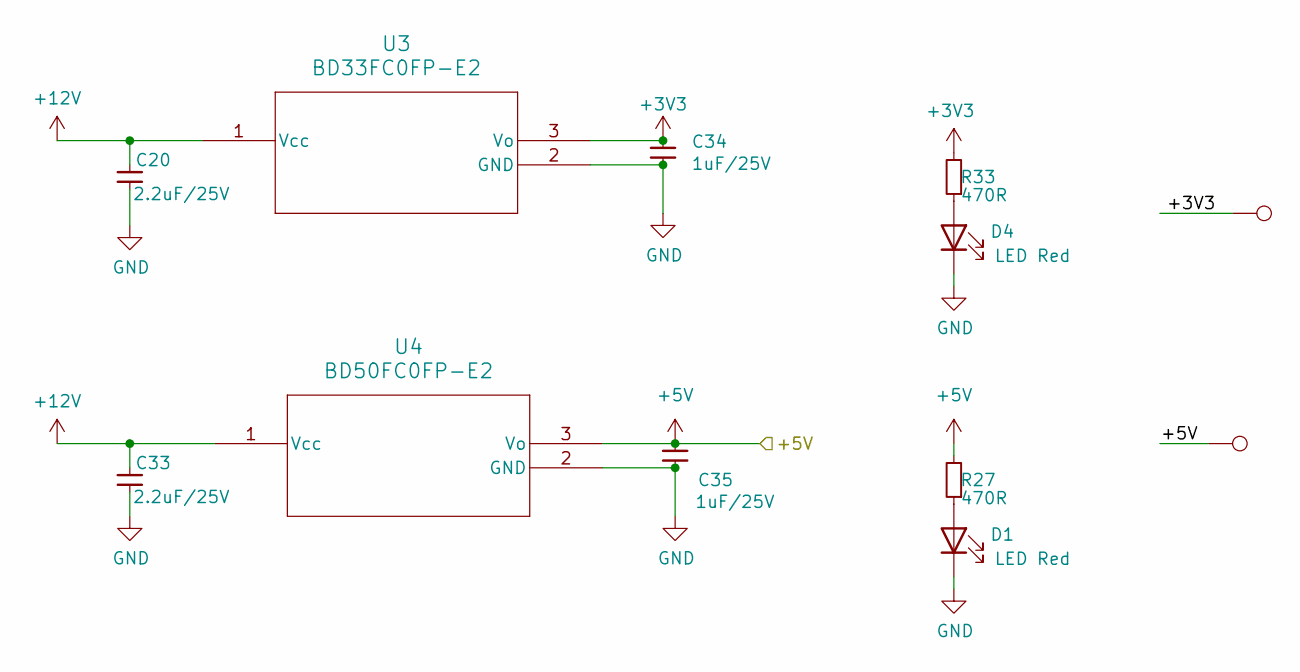
[picture p41: schematic PowerSupply.kicad_sch]

Parts:
C20, C33: 2.2uF/25V; C_0603_1608Metric; MPN GRM188R61E225KA12D
C34, C35: 1uF/25V; C_0603_1608Metric; MPN CL10B105KA8NNNC
D1, D4: LED Red; LED_0603_1608Metric; MPN LTST-C190KRKT
R27, R33: 470R; R_0603_1608Metric; MPN RC0603JR-07470RL
TP1: 5V; TestPoint_Pad_D1.0mm
TP2: 3V3; TestPoint_Pad_D1.0mm
U3: BD33FC0FP-E2; TO252-3_ROM; MPN BD33FC0FP-E2
U4: BD50FC0FP-E2; TO252-3_ROM; MPN BD50FC0FP-E2

Connections:
+3V3: C34.2, R33.2, TP2.1, U3.3 (Vo); also elsewhere on the board
+5V: C35.2, R27.2, TP1.1, U4.3 (Vo); also elsewhere on the board
+12V: C20.1, C33.1, U3.1 (Vcc), U4.1 (Vcc); also elsewhere on the board
GND: C20.2, C33.2, C34.1, C35.1, D1.1 (K), D4.1 (K), U3.2 (GND), U4.2 (GND); also elsewhere on the board
unnamed: D1.2 (A), R27.1
unnamed: D4.2 (A), R33.1

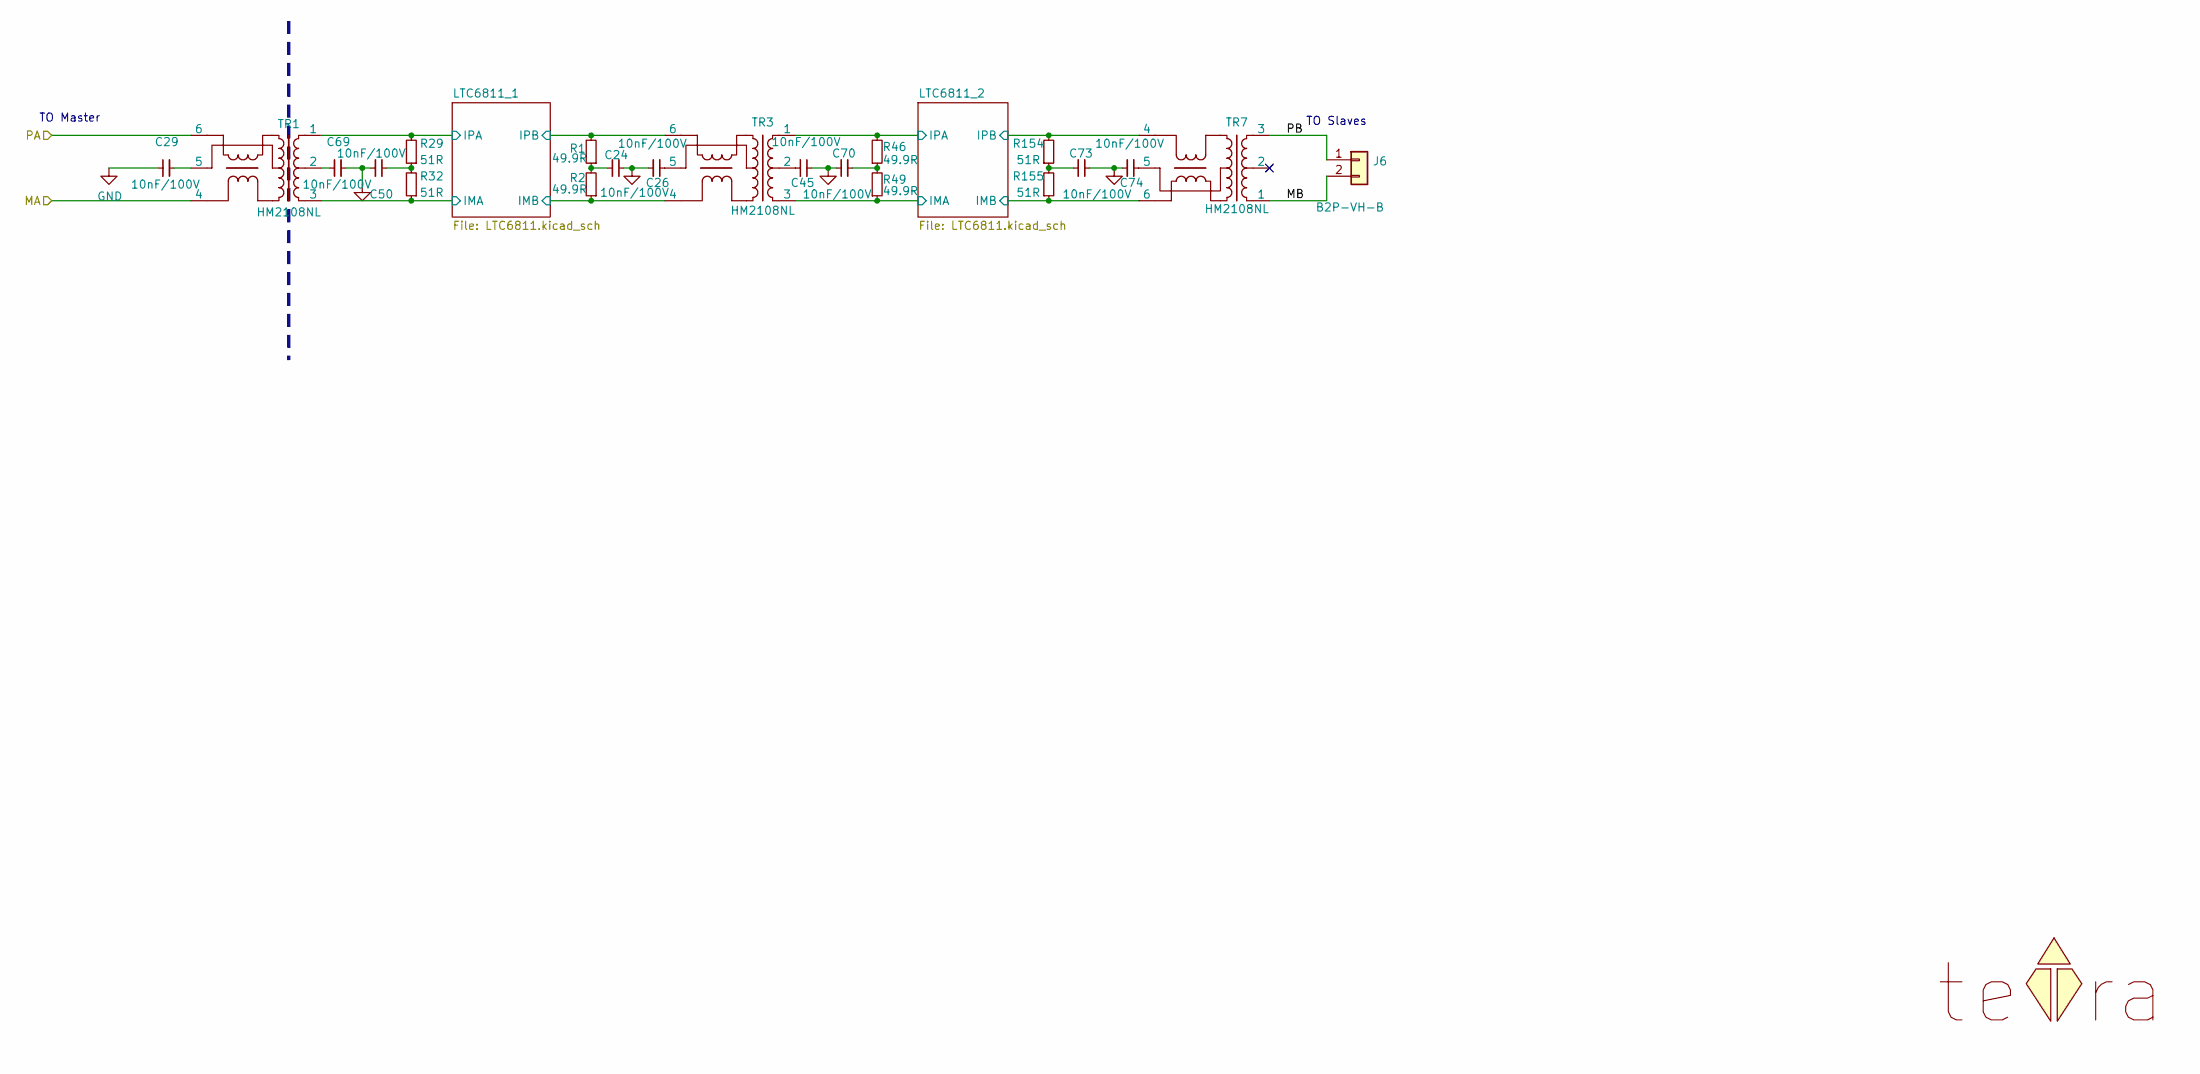
[picture p42: schematic Slaves.kicad_sch]

Parts:
C24, C26, C29, C45, C50, C69, C70, C73, C74: 10nF/100V; C_0603_1608Metric; MPN C0603X103K1RAC3316
J6: B2P-VH-B; JST_VH_B2P-VH-B_1x02_P3.96mm_Vertical; MPN B2P-VH
LOGO2: teTra /NC; teTra-LOGO
R1, R2, R46, R49: 49.9R; R_0603_1608Metric; MPN ERJ-3EKF49R9V
R29, R32, R154, R155: 51R; R_0603_1608Metric; MPN RC0603JR-0751RL
TR1, TR3, TR7: HM2108NL; MPN HM2108NL

Connections:
/MCU/IM: TR1.4; also elsewhere on the board
/MCU/IP: TR1.6; also elsewhere on the board
/Slaves/LTC6811_1/IMA: R32.1, TR1.3; also elsewhere on the board
/Slaves/LTC6811_1/IMB: R2.1, TR3.4; also elsewhere on the board
/Slaves/LTC6811_1/IPA: R29.2, TR1.1; also elsewhere on the board
/Slaves/LTC6811_1/IPB: R1.2, TR3.6; also elsewhere on the board
/Slaves/LTC6811_2/IMA: R49.1, TR3.3; also elsewhere on the board
/Slaves/LTC6811_2/IMB: R155.1, TR7.6; also elsewhere on the board
/Slaves/LTC6811_2/IPA: R46.2, TR3.1; also elsewhere on the board
/Slaves/LTC6811_2/IPB: R154.2, TR7.4; also elsewhere on the board
/Slaves/MB: J6.2, TR7.1
/Slaves/PB: J6.1, TR7.3
GND: C29.1; also elsewhere on the board
GND_PACK: C24.2, C26.2, C45.2, C50.2, C69.2, C70.2, C73.1, C74.2; also elsewhere on the board
unnamed: C24.1, R1.1, R2.2
unnamed: C26.1, TR3.5
unnamed: C29.2, TR1.5
unnamed: C45.1, TR3.2
unnamed: C50.1, R29.1, R32.2
unnamed: C69.1, TR1.2
unnamed: C70.1, R46.1, R49.2
unnamed: C73.2, R154.1, R155.2
unnamed: C74.1, TR7.5

Notes on the sheet:
TO Slaves
TO Master
