tetra-aero/LTC6811_ESP32/LTC6811_ESP32_V6/Master_V6P1/LTC6811_ESP32_Master_V6P1.kicad_pcb

## KiCad design LTC6811_ESP32_V6/Master_V6P1/LTC6811_ESP32_Master_V6P1.kicad_pcb (continued)

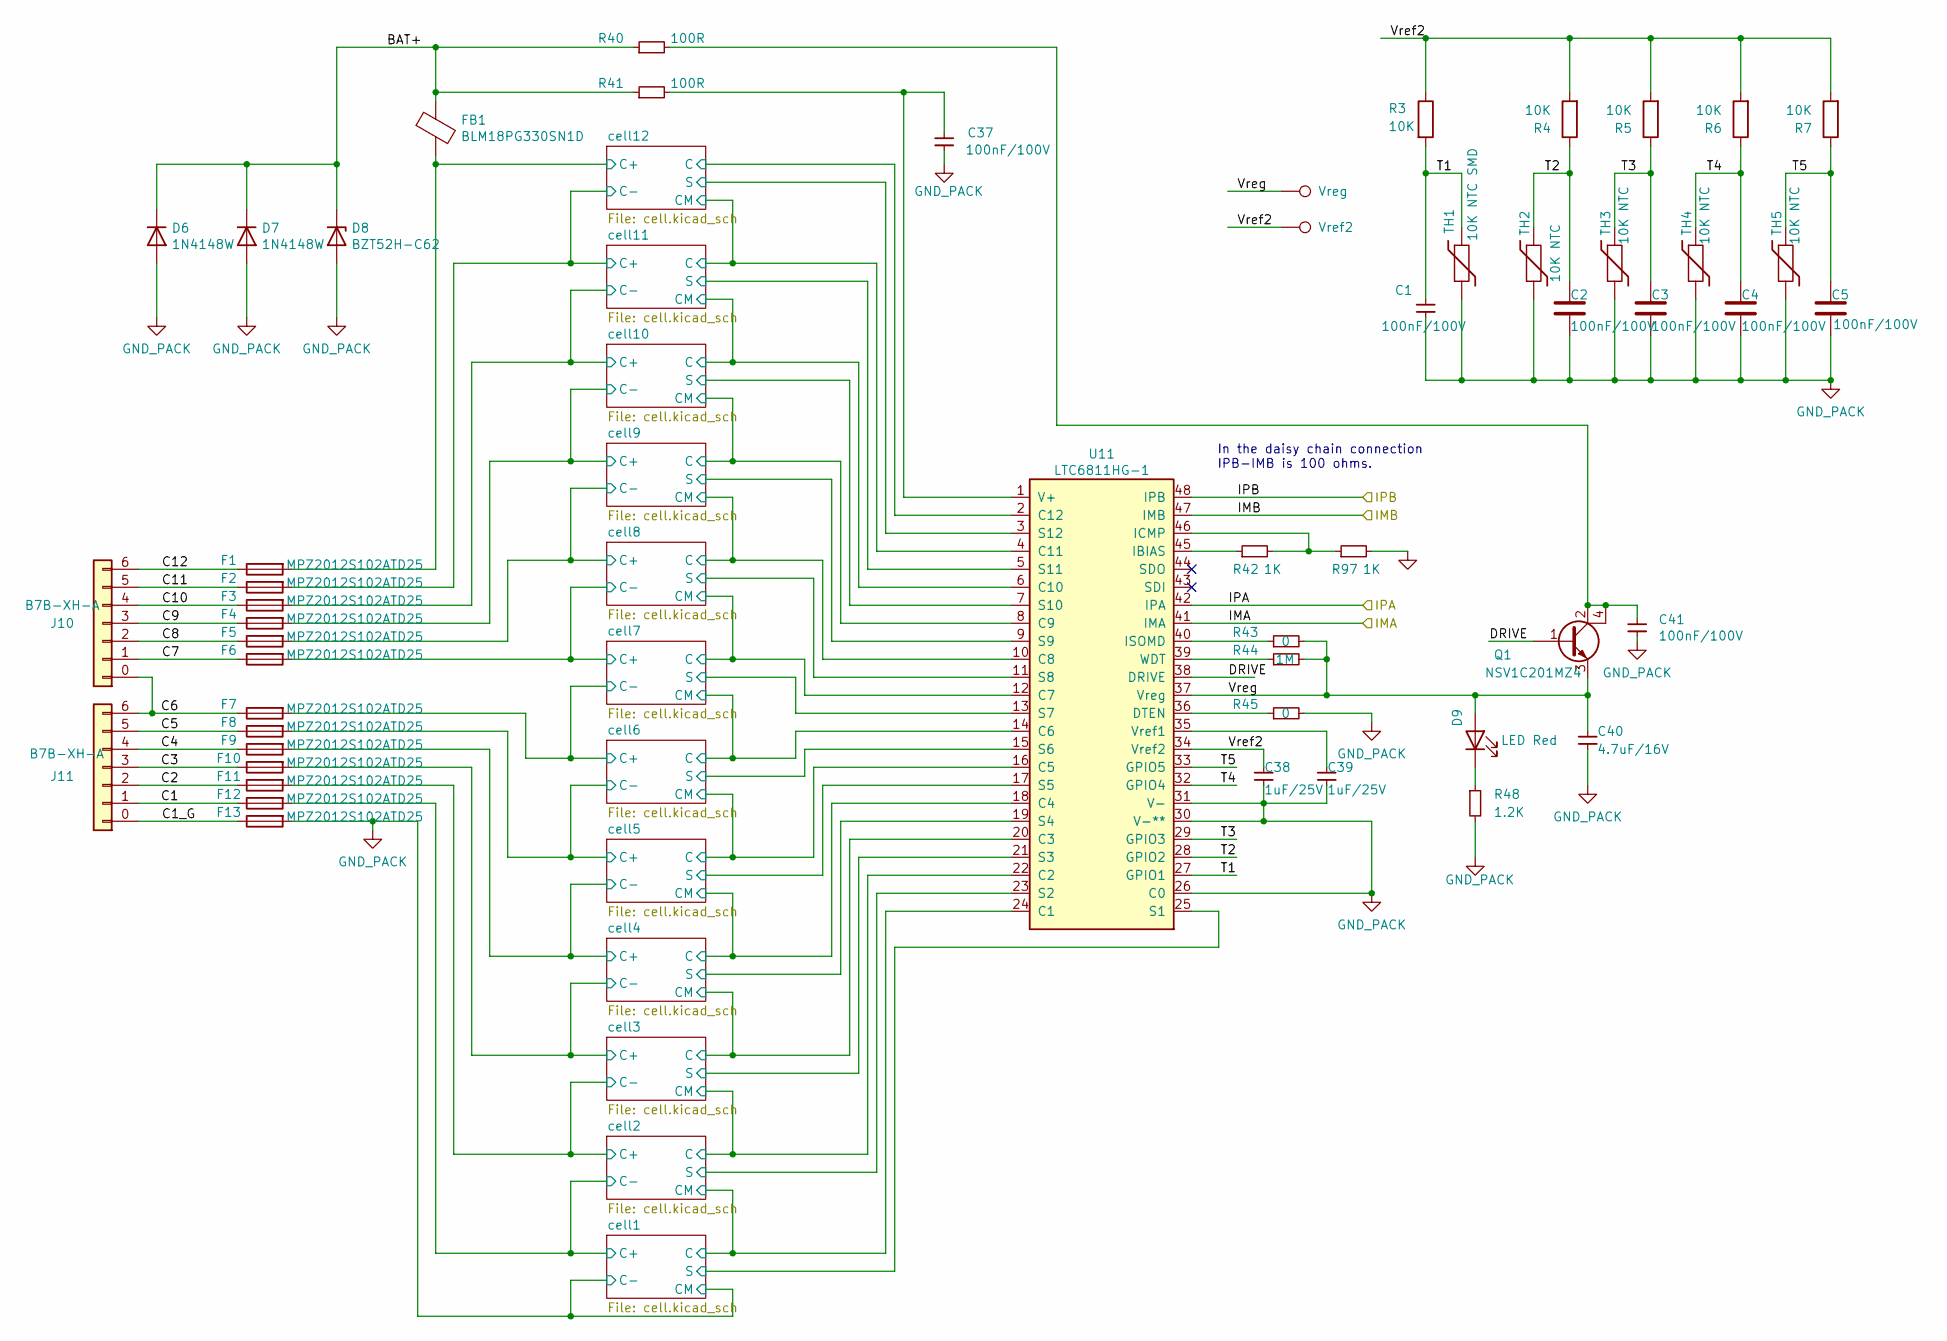
[picture p43: schematic LTC6811.kicad_sch]

Parts:
C1, C2, C3, C4, C5, C37, C41: 100nF/100V; C_0603_1608Metric; MPN CL10B104KC8NNNC
C38, C39: 1uF/25V; C_0603_1608Metric; MPN CL10B105KA8NNNC
C40: 4.7uF/16V; C_0603_1608Metric; MPN CL10A475KO8NNNC
D6, D7: 1N4148W; D_SOD-123; MPN 1N4148W-7-F
D8: BZT52H-C62; D_SOD-123F; MPN BZT52H-C62,115
D9: LED Red; LED_0603_1608Metric; MPN LTST-C190KRKT
F1, F2, F3, F4, F5, F6, F7, F8, F9, F10, F11, F12, F13: MPZ2012S102ATD25; Fuse_0805_2012Metric; MPN MPZ2012S102ATD25
FB1: BLM18PG330SN1D; R_0603_1608Metric; MPN BLM18PG330SN1D
J10, J11: B7B-XH-A; JST_XH_B7B-XH-A_1x07_P2.50mm_Vertical_BAT_6S; MPN B7B-XH-A
Q1: NSV1C201MZ4; SOT-223; MPN NSV1C201MZ4T1G
R3, R4, R5, R6, R7: 10K; R_0603_1608Metric; MPN RC0603FR-071KL
R40, R41: 100R; R_0603_1608Metric; MPN RC0603FR-07100RL
R42, R97: 1K; R_0603_1608Metric; MPN RC0603FR-071KL
R43, R45: 0; R_0603_1608Metric; MPN RC0603JR-070RL
R44: 1M; R_0603_1608Metric; MPN RC0603JR-071ML
R48: 1.2K; R_0603_1608Metric; MPN RC0603JR-071K2L
TH1: 10K NTC SMD; R_0603_1608Metric; MPN NCU18XH103F6SRB
TH2, TH3, TH4, TH5: 10K NTC; JST_ZR_B2B-ZR_1x02_P1.50mm_Vertical; MPN MF52C1103F3380
TP3: Vreg; TestPoint_Pad_D1.0mm
TP4: Vref2; TestPoint_Pad_D1.0mm
U11: LTC6811HG-1; TSSOP-48_6.1x12.5mm_P0.5mm; MPN LTC6811HG-1#3ZZPBF

Connections:
/Slaves/LTC6811_1/BAT+: D6.1 (K), D7.1 (K), D8.1 (K), FB1.1, R40.1, R41.1
/Slaves/LTC6811_1/C1: F12.1, J11.1 (Pin_2)
/Slaves/LTC6811_1/C1_G: F13.1, J11.0 (Pin_1)
/Slaves/LTC6811_1/C2: F11.1, J11.2 (Pin_3)
/Slaves/LTC6811_1/C3: F10.1, J11.3 (Pin_4)
/Slaves/LTC6811_1/C4: F9.1, J11.4 (Pin_5)
/Slaves/LTC6811_1/C5: F8.1, J11.5 (Pin_6)
/Slaves/LTC6811_1/C6: F7.1, J10.0 (Pin_1), J11.6 (Pin_7)
/Slaves/LTC6811_1/C7: F6.1, J10.1 (Pin_2)
/Slaves/LTC6811_1/C8: F5.1, J10.2 (Pin_3)
/Slaves/LTC6811_1/C9: F4.1, J10.3 (Pin_4)
/Slaves/LTC6811_1/C10: F3.1, J10.4 (Pin_5)
/Slaves/LTC6811_1/C11: F2.1, J10.5 (Pin_6)
/Slaves/LTC6811_1/C12: F1.1, J10.6 (Pin_7)
/Slaves/LTC6811_1/DRIVE: Q1.1 (B), U11.38 (DRIVE)
/Slaves/LTC6811_1/IMA: U11.41 (IMA); also elsewhere on the board
/Slaves/LTC6811_1/IMB: U11.47 (IMB); also elsewhere on the board
/Slaves/LTC6811_1/IPA: U11.42 (IPA); also elsewhere on the board
/Slaves/LTC6811_1/IPB: U11.48 (IPB); also elsewhere on the board
/Slaves/LTC6811_1/T1: C1.1, R3.2, TH1.1, U11.27 (GPIO1)
/Slaves/LTC6811_1/T2: C2.1, R4.1, TH2.1, U11.28 (GPIO2)
/Slaves/LTC6811_1/T3: C3.1, R5.1, TH3.1, U11.29 (GPIO3)
/Slaves/LTC6811_1/T4: C4.1, R6.1, TH4.1, U11.32 (GPIO4)
/Slaves/LTC6811_1/T5: C5.1, R7.1, TH5.1, U11.33 (GPIO5)
/Slaves/LTC6811_1/Vref2: C38.1, R3.1, R4.2, R5.2, R6.2, R7.2, TP4.1, U11.34 (Vref2)
/Slaves/LTC6811_1/Vreg: C40.1, D9.2 (A), Q1.3 (E), R43.2, R44.2, TP3.1, U11.37 (Vreg)
/Slaves/LTC6811_1/cell1/C: U11.24 (C1); also elsewhere on the board
/Slaves/LTC6811_1/cell1/C+: F12.2; also elsewhere on the board
/Slaves/LTC6811_1/cell1/S: U11.25 (S1); also elsewhere on the board
/Slaves/LTC6811_1/cell2/C: U11.22 (C2); also elsewhere on the board
/Slaves/LTC6811_1/cell2/C+: F11.2; also elsewhere on the board
/Slaves/LTC6811_1/cell2/S: U11.23 (S2); also elsewhere on the board
/Slaves/LTC6811_1/cell3/C: U11.20 (C3); also elsewhere on the board
/Slaves/LTC6811_1/cell3/C+: F10.2; also elsewhere on the board
/Slaves/LTC6811_1/cell3/S: U11.21 (S3); also elsewhere on the board
/Slaves/LTC6811_1/cell4/C: U11.18 (C4); also elsewhere on the board
/Slaves/LTC6811_1/cell4/C+: F9.2; also elsewhere on the board
/Slaves/LTC6811_1/cell4/S: U11.19 (S4); also elsewhere on the board
/Slaves/LTC6811_1/cell5/C: U11.16 (C5); also elsewhere on the board
/Slaves/LTC6811_1/cell5/C+: F8.2; also elsewhere on the board
/Slaves/LTC6811_1/cell5/S: U11.17 (S5); also elsewhere on the board
/Slaves/LTC6811_1/cell6/C: U11.14 (C6); also elsewhere on the board
/Slaves/LTC6811_1/cell6/C+: F7.2; also elsewhere on the board
/Slaves/LTC6811_1/cell6/S: U11.15 (S6); also elsewhere on the board
/Slaves/LTC6811_1/cell7/C: U11.12 (C7); also elsewhere on the board
/Slaves/LTC6811_1/cell7/C+: F6.2; also elsewhere on the board
/Slaves/LTC6811_1/cell7/S: U11.13 (S7); also elsewhere on the board
/Slaves/LTC6811_1/cell8/C: U11.10 (C8); also elsewhere on the board
/Slaves/LTC6811_1/cell8/C+: F5.2; also elsewhere on the board
/Slaves/LTC6811_1/cell8/S: U11.11 (S8); also elsewhere on the board
/Slaves/LTC6811_1/cell9/S: U11.9 (S9); also elsewhere on the board
/Slaves/LTC6811_1/cell10/C: U11.6 (C10); also elsewhere on the board
/Slaves/LTC6811_1/cell10/C+: F3.2; also elsewhere on the board
/Slaves/LTC6811_1/cell10/C-: F4.2; also elsewhere on the board
/Slaves/LTC6811_1/cell10/CM: U11.8 (C9); also elsewhere on the board
/Slaves/LTC6811_1/cell10/S: U11.7 (S10); also elsewhere on the board
/Slaves/LTC6811_1/cell11/C: U11.4 (C11); also elsewhere on the board
/Slaves/LTC6811_1/cell11/C+: F2.2; also elsewhere on the board
/Slaves/LTC6811_1/cell11/S: U11.5 (S11); also elsewhere on the board
/Slaves/LTC6811_1/cell12/C: U11.2 (C12); also elsewhere on the board
/Slaves/LTC6811_1/cell12/C+: F1.2, FB1.2; also elsewhere on the board
/Slaves/LTC6811_1/cell12/S: U11.3 (S12); also elsewhere on the board
GND_PACK: C1.2, C2.2, C3.2, C4.2, C5.2, C37.2, C38.2, C39.2, C40.2, C41.2, D6.2 (A), D7.2 (A), D8.2 (A), F13.2, R45.2, R48.2, R97.2, TH1.2, TH2.2, TH3.2, TH4.2, TH5.2, U11.26 (C0), U11.30 (V-**), U11.31 (V-); also elsewhere on the board
unnamed: C41.1, Q1.2 (C), Q1.4 (C), R40.2
unnamed: D9.1 (K), R48.1
unnamed: R45.1, U11.36 (DTEN)
unnamed: R42.1, U11.45 (IBIAS)
unnamed: R42.2, R97.1, U11.46 (ICMP)
unnamed: R43.1, U11.40 (ISOMD)
unnamed: C37.1, R41.2, U11.1 (V+)
unnamed: C39.1, U11.35 (Vref1)
unnamed: R44.1, U11.39 (WDT)

Parts of its further copies:
C6, C7, C8, C9, C10, C63, C67: 100nF/100V; C_0603_1608Metric; MPN CL10B104KC8NNNC
C42: 4.7uF/16V; C_0603_1608Metric; MPN CL10A475KO8NNNC
C64, C65: 1uF/25V; C_0603_1608Metric; MPN CL10B105KA8NNNC
D22, D23: 1N4148W; D_SOD-123; MPN 1N4148W-7-F
D24: BZT52H-C62; D_SOD-123F; MPN BZT52H-C62,115
D25: LED Red; LED_0603_1608Metric; MPN LTST-C190KRKT
F14, F15, F16, F17, F18, F19, F20, F21, F22, F23, F24, F25, F26: MPZ2012S102ATD25; Fuse_0805_2012Metric; MPN MPZ2012S102ATD25
FB2: BLM18PG330SN1D; R_0603_1608Metric; MPN BLM18PG330SN1D
J12, J13: B7B-XH-A; JST_XH_B7B-XH-A_1x07_P2.50mm_Vertical_BAT_6S; MPN B7B-XH-A
Q14: NSV1C201MZ4; SOT-223; MPN NSV1C201MZ4T1G
R8, R9, R10, R11, R12: 10K; R_0603_1608Metric; MPN RC0603FR-071KL
R47, R98: 1K; R_0603_1608Metric; MPN RC0603FR-071KL
R91, R92: 100R; R_0603_1608Metric; MPN RC0603FR-07100RL
R94, R96: 0; R_0603_1608Metric; MPN RC0603JR-070RL
R95: 1M; R_0603_1608Metric; MPN RC0603JR-071ML
R99: 1.2K; R_0603_1608Metric; MPN RC0603JR-071K2L
TH6: 10K NTC SMD; R_0603_1608Metric; MPN NCU18XH103F6SRB
TH7, TH8, TH9, TH10: 10K NTC; JST_ZR_B2B-ZR_1x02_P1.50mm_Vertical; MPN MF52C1103F3380
TP5: Vreg; TestPoint_Pad_D1.0mm
TP6: Vref2; TestPoint_Pad_D1.0mm
U12: LTC6811HG-1; TSSOP-48_6.1x12.5mm_P0.5mm; MPN LTC6811HG-1#3ZZPBF

Connections of its further copies:
/Slaves/LTC6811_2/BAT+: D22.1 (K), D23.1 (K), D24.1 (K), FB2.1, R91.1, R92.1
/Slaves/LTC6811_2/C1: F25.1, J13.1 (Pin_2)
/Slaves/LTC6811_2/C1_G: F26.1, J13.0 (Pin_1)
/Slaves/LTC6811_2/C2: F24.1, J13.2 (Pin_3)
/Slaves/LTC6811_2/C3: F23.1, J13.3 (Pin_4)
/Slaves/LTC6811_2/C4: F22.1, J13.4 (Pin_5)
/Slaves/LTC6811_2/C5: F21.1, J13.5 (Pin_6)
/Slaves/LTC6811_2/C6: F20.1, J12.0 (Pin_1), J13.6 (Pin_7)
/Slaves/LTC6811_2/C7: F19.1, J12.1 (Pin_2)
/Slaves/LTC6811_2/C8: F18.1, J12.2 (Pin_3)
/Slaves/LTC6811_2/C9: F17.1, J12.3 (Pin_4)
/Slaves/LTC6811_2/C10: F16.1, J12.4 (Pin_5)
/Slaves/LTC6811_2/C11: F15.1, J12.5 (Pin_6)
/Slaves/LTC6811_2/C12: F14.1, J12.6 (Pin_7)
/Slaves/LTC6811_2/DRIVE: Q14.1 (B), U12.38 (DRIVE)
/Slaves/LTC6811_2/IMA: U12.41 (IMA); also elsewhere on the board
/Slaves/LTC6811_2/IMB: U12.47 (IMB); also elsewhere on the board
/Slaves/LTC6811_2/IPA: U12.42 (IPA); also elsewhere on the board
/Slaves/LTC6811_2/IPB: U12.48 (IPB); also elsewhere on the board
/Slaves/LTC6811_2/T1: C6.1, R8.2, TH6.1, U12.27 (GPIO1)
/Slaves/LTC6811_2/T2: C7.1, R9.1, TH7.1, U12.28 (GPIO2)
/Slaves/LTC6811_2/T3: C8.1, R10.1, TH8.1, U12.29 (GPIO3)
/Slaves/LTC6811_2/T4: C9.1, R11.1, TH9.1, U12.32 (GPIO4)
/Slaves/LTC6811_2/T5: C10.1, R12.1, TH10.1, U12.33 (GPIO5)
/Slaves/LTC6811_2/Vref2: C64.1, R8.1, R9.2, R10.2, R11.2, R12.2, TP6.1, U12.34 (Vref2)
/Slaves/LTC6811_2/Vreg: C42.1, D25.2 (A), Q14.3 (E), R94.2, R95.2, TP5.1, U12.37 (Vreg)
/Slaves/LTC6811_2/cell1/C: U12.24 (C1); also elsewhere on the board
/Slaves/LTC6811_2/cell1/C+: F25.2; also elsewhere on the board
/Slaves/LTC6811_2/cell1/S: U12.25 (S1); also elsewhere on the board
/Slaves/LTC6811_2/cell2/C: U12.22 (C2); also elsewhere on the board
/Slaves/LTC6811_2/cell2/C+: F24.2; also elsewhere on the board
/Slaves/LTC6811_2/cell2/S: U12.23 (S2); also elsewhere on the board
/Slaves/LTC6811_2/cell3/C: U12.20 (C3); also elsewhere on the board
/Slaves/LTC6811_2/cell3/C+: F23.2; also elsewhere on the board
/Slaves/LTC6811_2/cell3/S: U12.21 (S3); also elsewhere on the board
/Slaves/LTC6811_2/cell4/C: U12.18 (C4); also elsewhere on the board
/Slaves/LTC6811_2/cell4/C+: F22.2; also elsewhere on the board
/Slaves/LTC6811_2/cell4/S: U12.19 (S4); also elsewhere on the board
/Slaves/LTC6811_2/cell5/C: U12.16 (C5); also elsewhere on the board
/Slaves/LTC6811_2/cell5/C+: F21.2; also elsewhere on the board
/Slaves/LTC6811_2/cell5/S: U12.17 (S5); also elsewhere on the board
/Slaves/LTC6811_2/cell6/C: U12.14 (C6); also elsewhere on the board
/Slaves/LTC6811_2/cell6/C+: F20.2; also elsewhere on the board
/Slaves/LTC6811_2/cell6/S: U12.15 (S6); also elsewhere on the board
/Slaves/LTC6811_2/cell7/C: U12.12 (C7); also elsewhere on the board
/Slaves/LTC6811_2/cell7/C+: F19.2; also elsewhere on the board
/Slaves/LTC6811_2/cell7/S: U12.13 (S7); also elsewhere on the board
/Slaves/LTC6811_2/cell8/C: U12.10 (C8); also elsewhere on the board
/Slaves/LTC6811_2/cell8/C+: F18.2; also elsewhere on the board
/Slaves/LTC6811_2/cell8/S: U12.11 (S8); also elsewhere on the board
/Slaves/LTC6811_2/cell9/S: U12.9 (S9); also elsewhere on the board
/Slaves/LTC6811_2/cell10/C: U12.6 (C10); also elsewhere on the board
/Slaves/LTC6811_2/cell10/C+: F16.2; also elsewhere on the board
/Slaves/LTC6811_2/cell10/C-: F17.2; also elsewhere on the board
/Slaves/LTC6811_2/cell10/CM: U12.8 (C9); also elsewhere on the board
/Slaves/LTC6811_2/cell10/S: U12.7 (S10); also elsewhere on the board
/Slaves/LTC6811_2/cell11/C: U12.4 (C11); also elsewhere on the board
/Slaves/LTC6811_2/cell11/C+: F15.2; also elsewhere on the board
/Slaves/LTC6811_2/cell11/S: U12.5 (S11); also elsewhere on the board
/Slaves/LTC6811_2/cell12/C: U12.2 (C12); also elsewhere on the board
/Slaves/LTC6811_2/cell12/C+: F14.2, FB2.2; also elsewhere on the board
/Slaves/LTC6811_2/cell12/S: U12.3 (S12); also elsewhere on the board
GND_PACK: C6.2, C7.2, C8.2, C9.2, C10.2, C42.2, C63.2, C64.2, C65.2, C67.2, D22.2 (A), D23.2 (A), D24.2 (A), F26.2, R96.2, R98.2, R99.2, TH6.2, TH7.2, TH8.2, TH9.2, TH10.2, U12.26 (C0), U12.30 (V-**), U12.31 (V-); also elsewhere on the board
unnamed: C67.1, Q14.2 (C), Q14.4 (C), R91.2
unnamed: D25.1 (K), R99.1
unnamed: R96.1, U12.36 (DTEN)
unnamed: R47.1, U12.45 (IBIAS)
unnamed: R47.2, R98.1, U12.46 (ICMP)
unnamed: R94.1, U12.40 (ISOMD)
unnamed: C63.1, R92.2, U12.1 (V+)
unnamed: C65.1, U12.35 (Vref1)
unnamed: R95.1, U12.39 (WDT)

Notes on the sheet:
In the daisy chain connection IPB-IMB is 100 ohms.

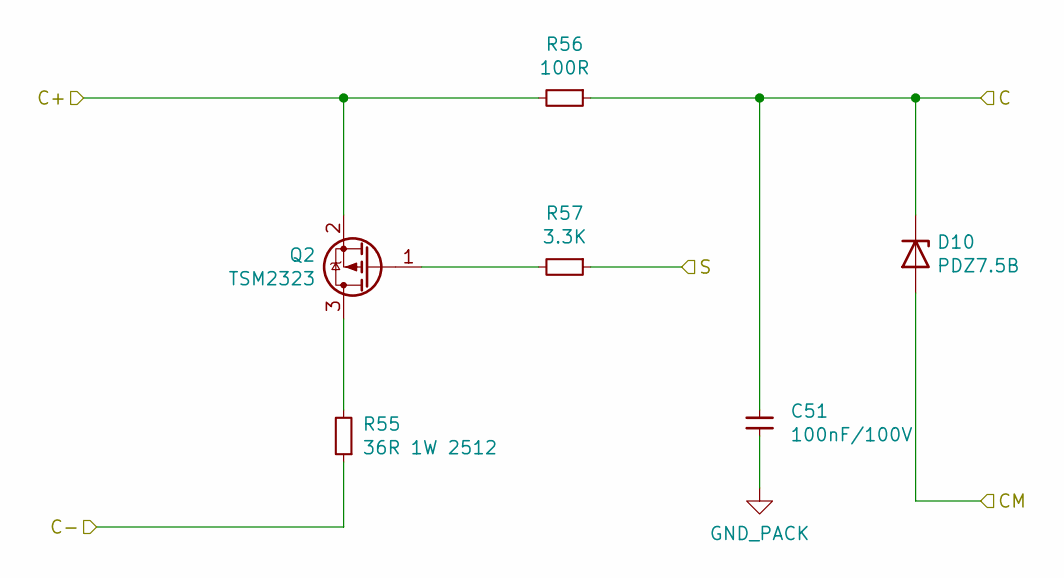
[picture p44: schematic cell.kicad_sch]

Parts:
C51: 100nF/100V; C_0603_1608Metric; MPN CL10B104KC8NNNC
D10: PDZ7.5B; D_SOD-323_HandSoldering; MPN PDZ7.5BZ
Q2: TSM2323; SOT-23; MPN TSM2323CX RFG
R55: 36R 1W 2512; R_2512_6332Metric; MPN RTT25360JTE
R56: 100R; R_0603_1608Metric; MPN RC0603FR-07100RL
R57: 3.3K; R_0603_1608Metric; MPN RC0603FR-073K3L

Connections:
/Slaves/LTC6811_1/cell11/C: D10.2 (A); also elsewhere on the board
/Slaves/LTC6811_1/cell11/C+: R55.1; also elsewhere on the board
/Slaves/LTC6811_1/cell12/C: C51.1, D10.1 (K), R56.1; also elsewhere on the board
/Slaves/LTC6811_1/cell12/C+: Q2.2 (S), R56.2; also elsewhere on the board
/Slaves/LTC6811_1/cell12/S: R57.1; also elsewhere on the board
GND_PACK: C51.2; also elsewhere on the board
unnamed: Q2.3 (D), R55.2
unnamed: Q2.1 (G), R57.2

Parts of its further copies:
C52, C53, C54, C55, C56, C57, C58, C59, C60, C61, C62, C77, C78, C79, C80, C81, C82, C83, C84, C85, C86, C87, C88: 100nF/100V; C_0603_1608Metric; MPN CL10B104KC8NNNC
D11, D12, D13, D14, D15, D16, D17, D18, D19, D20, D21, D26, D27, D28, D29, D30, D31, D32, D33, D34, D35, D36, D37: PDZ7.5B; D_SOD-323_HandSoldering; MPN PDZ7.5BZ
Q3, Q4, Q5, Q6, Q7, Q8, Q9, Q10, Q11, Q12, Q13, Q15, Q16, Q17, Q18, Q19, Q20, Q21, Q22, Q23, Q24, Q25, Q26: TSM2323; SOT-23; MPN TSM2323CX RFG
R58, R61, R64, R67, R70, R73, R76, R79, R82, R85, R88, R106, R109, R112, R115, R118, R121, R124, R127, R130, R133, R136, R139: 36R 1W 2512; R_2512_6332Metric; MPN RTT25360JTE
R59, R62, R65, R68, R71, R74, R77, R80, R83, R86, R89, R107, R110, R113, R116, R119, R122, R125, R128, R131, R134, R137, R140: 100R; R_0603_1608Metric; MPN RC0603FR-07100RL
R60, R63, R66, R69, R72, R75, R78, R81, R84, R87, R90, R108, R111, R114, R117, R120, R123, R126, R129, R132, R135, R138, R141: 3.3K; R_0603_1608Metric; MPN RC0603FR-073K3L

Connections of its further copies:
/Slaves/LTC6811_1/cell1/C: C62.1, D20.2 (A), D21.1 (K), R89.1; also elsewhere on the board
/Slaves/LTC6811_1/cell1/C+: Q13.2 (S), R85.1, R89.2; also elsewhere on the board
/Slaves/LTC6811_1/cell1/S: R90.1; also elsewhere on the board
/Slaves/LTC6811_1/cell2/C: C61.1, D19.2 (A), D20.1 (K), R86.1; also elsewhere on the board
/Slaves/LTC6811_1/cell2/C+: Q12.2 (S), R82.1, R86.2; also elsewhere on the board
/Slaves/LTC6811_1/cell2/S: R87.1; also elsewhere on the board
/Slaves/LTC6811_1/cell3/C: C60.1, D18.2 (A), D19.1 (K), R83.1; also elsewhere on the board
/Slaves/LTC6811_1/cell3/C+: Q11.2 (S), R79.1, R83.2; also elsewhere on the board
/Slaves/LTC6811_1/cell3/S: R84.1; also elsewhere on the board
/Slaves/LTC6811_1/cell4/C: C59.1, D17.2 (A), D18.1 (K), R80.1; also elsewhere on the board
/Slaves/LTC6811_1/cell4/C+: Q10.2 (S), R76.1, R80.2; also elsewhere on the board
/Slaves/LTC6811_1/cell4/S: R81.1; also elsewhere on the board
/Slaves/LTC6811_1/cell5/C: C58.1, D16.2 (A), D17.1 (K), R77.1; also elsewhere on the board
/Slaves/LTC6811_1/cell5/C+: Q9.2 (S), R73.1, R77.2; also elsewhere on the board
/Slaves/LTC6811_1/cell5/S: R78.1; also elsewhere on the board
/Slaves/LTC6811_1/cell6/C: C57.1, D15.2 (A), D16.1 (K), R74.1; also elsewhere on the board
/Slaves/LTC6811_1/cell6/C+: Q8.2 (S), R70.1, R74.2; also elsewhere on the board
/Slaves/LTC6811_1/cell6/S: R75.1; also elsewhere on the board
/Slaves/LTC6811_1/cell7/C: C56.1, D14.2 (A), D15.1 (K), R71.1; also elsewhere on the board
/Slaves/LTC6811_1/cell7/C+: Q7.2 (S), R67.1, R71.2; also elsewhere on the board
/Slaves/LTC6811_1/cell7/S: R72.1; also elsewhere on the board
/Slaves/LTC6811_1/cell8/C: C55.1, D13.2 (A), D14.1 (K), R68.1; also elsewhere on the board
/Slaves/LTC6811_1/cell8/C+: Q6.2 (S), R64.1, R68.2; also elsewhere on the board
/Slaves/LTC6811_1/cell8/S: R69.1; also elsewhere on the board
/Slaves/LTC6811_1/cell9/S: R66.1; also elsewhere on the board
/Slaves/LTC6811_1/cell10/C: C53.1, D11.2 (A), D12.1 (K), R62.1; also elsewhere on the board
/Slaves/LTC6811_1/cell10/C+: Q4.2 (S), R58.1, R62.2; also elsewhere on the board
/Slaves/LTC6811_1/cell10/C-: Q5.2 (S), R61.1, R65.2; also elsewhere on the board
/Slaves/LTC6811_1/cell10/CM: C54.1, D12.2 (A), D13.1 (K), R65.1; also elsewhere on the board
/Slaves/LTC6811_1/cell10/S: R63.1; also elsewhere on the board
/Slaves/LTC6811_1/cell11/C: C52.1, D11.1 (K), R59.1; also elsewhere on the board
/Slaves/LTC6811_1/cell11/C+: Q3.2 (S), R59.2; also elsewhere on the board
/Slaves/LTC6811_1/cell11/S: R60.1; also elsewhere on the board
/Slaves/LTC6811_2/cell1/C: C88.1, D36.2 (A), D37.1 (K), R140.1; also elsewhere on the board
/Slaves/LTC6811_2/cell1/C+: Q26.2 (S), R136.1, R140.2; also elsewhere on the board
/Slaves/LTC6811_2/cell1/S: R141.1; also elsewhere on the board
/Slaves/LTC6811_2/cell2/C: C87.1, D35.2 (A), D36.1 (K), R137.1; also elsewhere on the board
/Slaves/LTC6811_2/cell2/C+: Q25.2 (S), R133.1, R137.2; also elsewhere on the board
/Slaves/LTC6811_2/cell2/S: R138.1; also elsewhere on the board
/Slaves/LTC6811_2/cell3/C: C86.1, D34.2 (A), D35.1 (K), R134.1; also elsewhere on the board
/Slaves/LTC6811_2/cell3/C+: Q24.2 (S), R130.1, R134.2; also elsewhere on the board
/Slaves/LTC6811_2/cell3/S: R135.1; also elsewhere on the board
/Slaves/LTC6811_2/cell4/C: C85.1, D33.2 (A), D34.1 (K), R131.1; also elsewhere on the board
/Slaves/LTC6811_2/cell4/C+: Q23.2 (S), R127.1, R131.2; also elsewhere on the board
/Slaves/LTC6811_2/cell4/S: R132.1; also elsewhere on the board
/Slaves/LTC6811_2/cell5/C: C84.1, D32.2 (A), D33.1 (K), R128.1; also elsewhere on the board
/Slaves/LTC6811_2/cell5/C+: Q22.2 (S), R124.1, R128.2; also elsewhere on the board
/Slaves/LTC6811_2/cell5/S: R129.1; also elsewhere on the board
/Slaves/LTC6811_2/cell6/C: C83.1, D31.2 (A), D32.1 (K), R125.1; also elsewhere on the board
/Slaves/LTC6811_2/cell6/C+: Q21.2 (S), R121.1, R125.2; also elsewhere on the board
/Slaves/LTC6811_2/cell6/S: R126.1; also elsewhere on the board
/Slaves/LTC6811_2/cell7/C: C82.1, D30.2 (A), D31.1 (K), R122.1; also elsewhere on the board
/Slaves/LTC6811_2/cell7/C+: Q20.2 (S), R118.1, R122.2; also elsewhere on the board
/Slaves/LTC6811_2/cell7/S: R123.1; also elsewhere on the board
/Slaves/LTC6811_2/cell8/C: C81.1, D29.2 (A), D30.1 (K), R119.1; also elsewhere on the board
/Slaves/LTC6811_2/cell8/C+: Q19.2 (S), R115.1, R119.2; also elsewhere on the board
/Slaves/LTC6811_2/cell8/S: R120.1; also elsewhere on the board
/Slaves/LTC6811_2/cell9/S: R117.1; also elsewhere on the board
/Slaves/LTC6811_2/cell10/C: C79.1, D27.2 (A), D28.1 (K), R113.1; also elsewhere on the board
/Slaves/LTC6811_2/cell10/C+: Q17.2 (S), R109.1, R113.2; also elsewhere on the board
/Slaves/LTC6811_2/cell10/C-: Q18.2 (S), R112.1, R116.2; also elsewhere on the board
/Slaves/LTC6811_2/cell10/CM: C80.1, D28.2 (A), D29.1 (K), R116.1; also elsewhere on the board
/Slaves/LTC6811_2/cell10/S: R114.1; also elsewhere on the board
/Slaves/LTC6811_2/cell11/C: C78.1, D26.2 (A), D27.1 (K), R110.1; also elsewhere on the board
/Slaves/LTC6811_2/cell11/C+: Q16.2 (S), R106.1, R110.2; also elsewhere on the board
/Slaves/LTC6811_2/cell11/S: R111.1; also elsewhere on the board
/Slaves/LTC6811_2/cell12/C: C77.1, D26.1 (K), R107.1; also elsewhere on the board
/Slaves/LTC6811_2/cell12/C+: Q15.2 (S), R107.2; also elsewhere on the board
/Slaves/LTC6811_2/cell12/S: R108.1; also elsewhere on the board
GND_PACK: C52.2, C53.2, C54.2, C55.2, C56.2, C57.2, C58.2, C59.2, C60.2, C61.2, C62.2, C77.2, C78.2, C79.2, C80.2, C81.2, C82.2, C83.2, C84.2, C85.2, C86.2, C87.2, C88.2, D21.2 (A), D37.2 (A), R88.1, R139.1; also elsewhere on the board
unnamed: Q3.3 (D), R58.2
unnamed: Q3.1 (G), R60.2
unnamed: Q4.3 (D), R61.2
unnamed: Q4.1 (G), R63.2
unnamed: Q5.3 (D), R64.2
unnamed: Q5.1 (G), R66.2
unnamed: Q6.3 (D), R67.2
unnamed: Q6.1 (G), R69.2
unnamed: Q7.3 (D), R70.2
unnamed: Q7.1 (G), R72.2
unnamed: Q8.3 (D), R73.2
unnamed: Q8.1 (G), R75.2
unnamed: Q9.3 (D), R76.2
unnamed: Q9.1 (G), R78.2
unnamed: Q10.3 (D), R79.2
unnamed: Q10.1 (G), R81.2
unnamed: Q11.3 (D), R82.2
unnamed: Q11.1 (G), R84.2
unnamed: Q12.3 (D), R85.2
unnamed: Q12.1 (G), R87.2
unnamed: Q13.3 (D), R88.2
unnamed: Q13.1 (G), R90.2
unnamed: Q15.3 (D), R106.2
unnamed: Q15.1 (G), R108.2
unnamed: Q16.3 (D), R109.2
unnamed: Q16.1 (G), R111.2
unnamed: Q17.3 (D), R112.2
unnamed: Q17.1 (G), R114.2
unnamed: Q18.3 (D), R115.2
unnamed: Q18.1 (G), R117.2
unnamed: Q19.3 (D), R118.2
unnamed: Q19.1 (G), R120.2
unnamed: Q20.3 (D), R121.2
unnamed: Q20.1 (G), R123.2
unnamed: Q21.3 (D), R124.2
unnamed: Q21.1 (G), R126.2
unnamed: Q22.3 (D), R127.2
unnamed: Q22.1 (G), R129.2
unnamed: Q23.3 (D), R130.2
unnamed: Q23.1 (G), R132.2
unnamed: Q24.3 (D), R133.2
unnamed: Q24.1 (G), R135.2
unnamed: Q25.3 (D), R136.2
unnamed: Q25.1 (G), R138.2
unnamed: Q26.3 (D), R139.2
unnamed: Q26.1 (G), R141.2

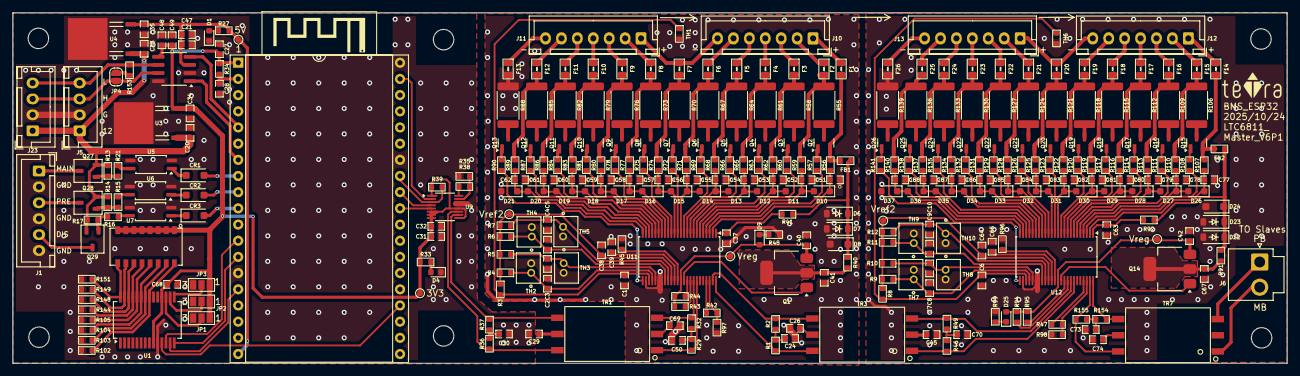
[picture p45: board LTC6811_ESP32_Master_V6P1.kicad_pcb from above]

Board: 2 copper layers, 200.0 x 55.0 mm, 341 parts (1 on the bottom side), 253 nets.
