tetra-aero/LTC6811_ESP32/LTC6811_ESP32_V5/Slaves/LTC6811_ESP32_Slaves_V5.kicad_pcb

## KiCad design LTC6811_ESP32_V5/Slaves/LTC6811_ESP32_Slaves_V5.kicad_pcb (2024-09-13, an earlier design)

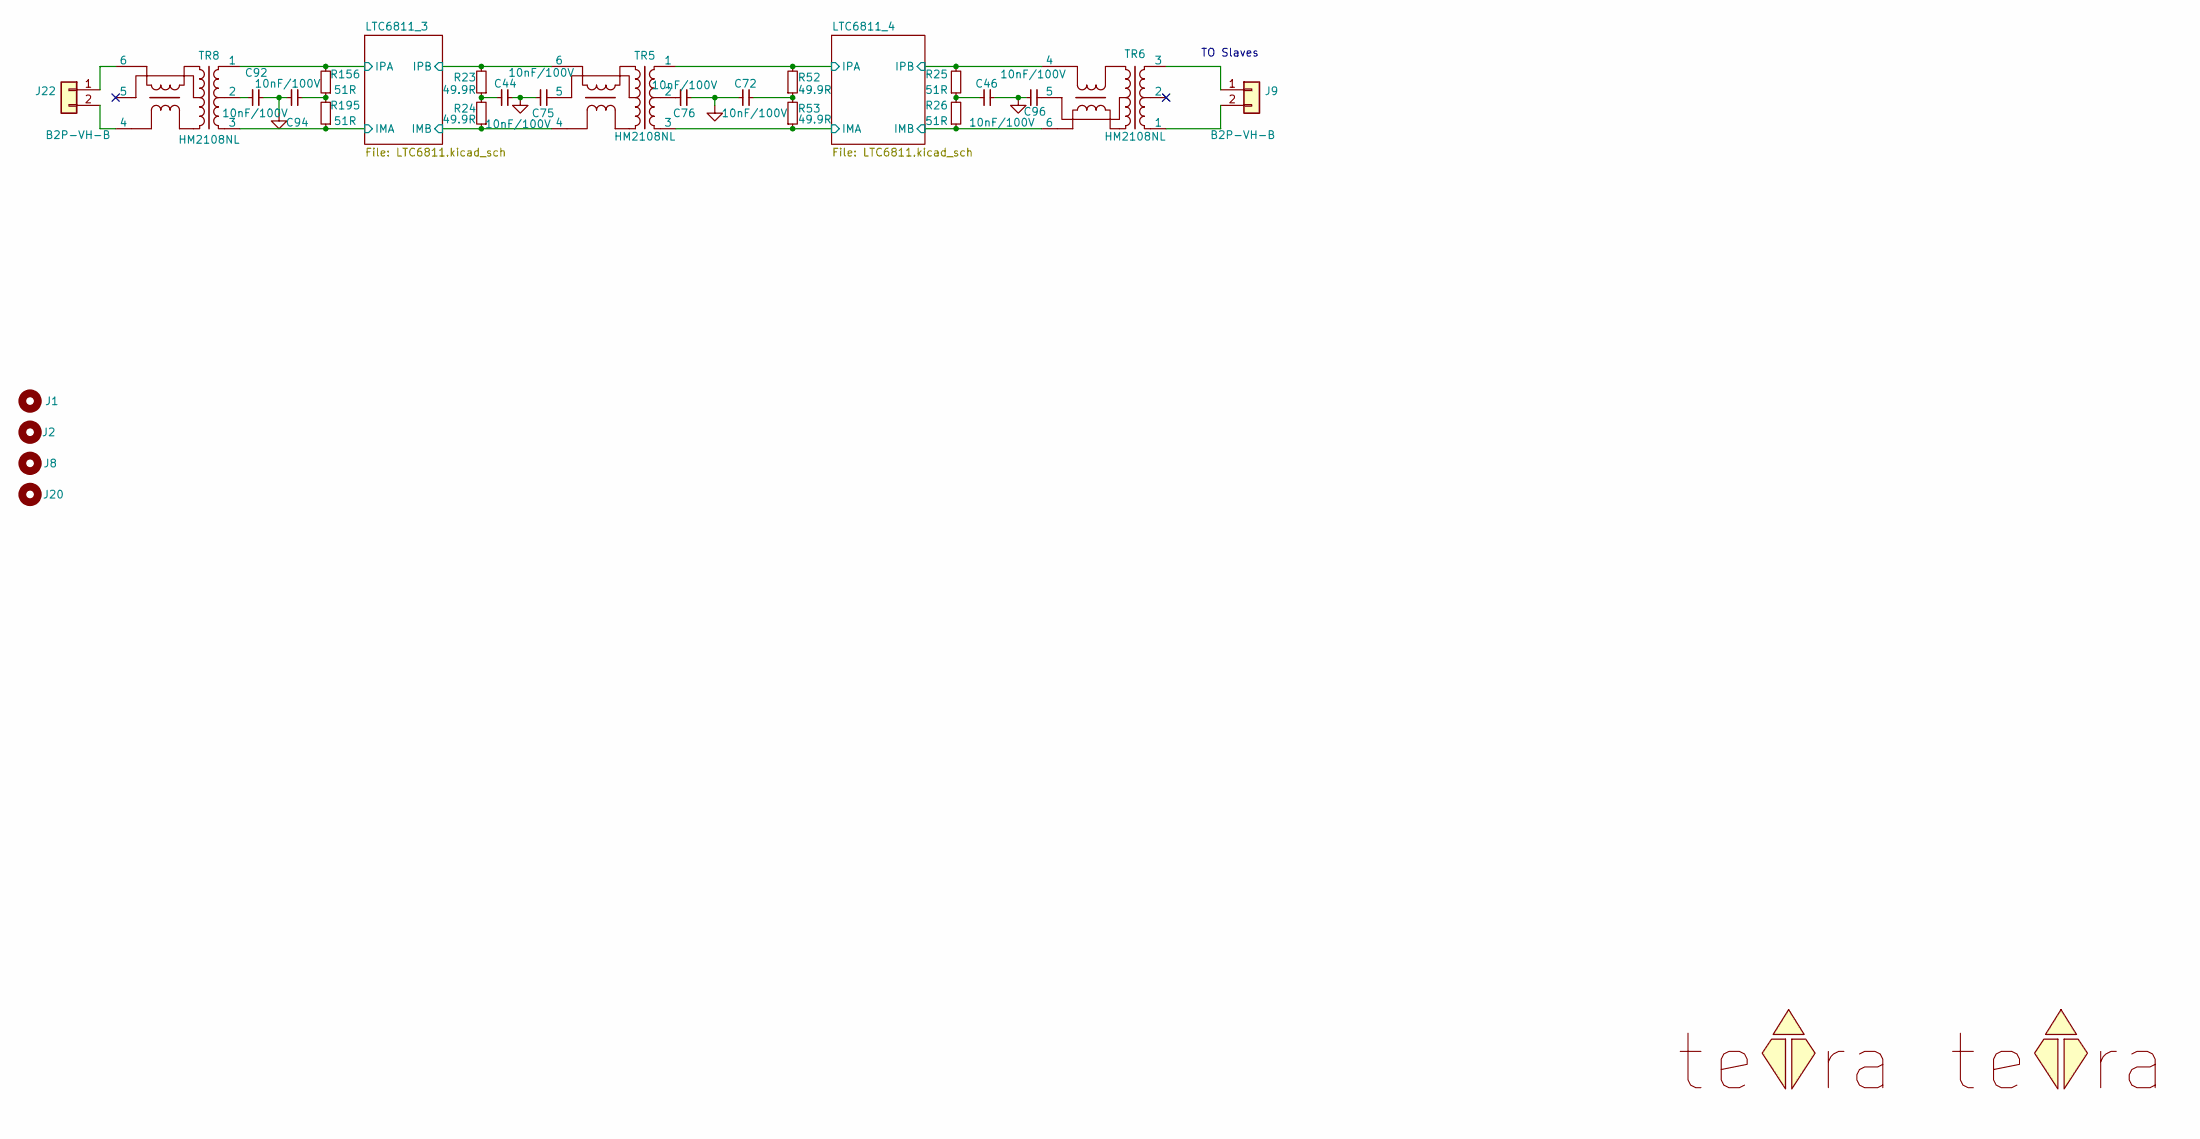
[picture p46: schematic LTC6811_ESP32_Slaves_V5.kicad_sch, LTC6811_ESP32_Slaves]

Parts:
C44, C46, C72, C75, C76, C92, C94, C96: 10nF/100V; C_0603_1608Metric; MPN C0603X103K1RAC3316
J1, J2, J8, J20: Hole /NC; MountingHole_3.2mm_M3_ISO7380; MPN N/A
J9, J22: B2P-VH-B; JST_VH_B2P-VH-B_1x02_P3.96mm_Vertical; MPN B2P-VH
LOGO1, LOGO2: teTra /NC; teTra-LOGO
R23, R24, R52, R53: 49.9R; R_0603_1608Metric; MPN ERJ-3EKF49R9V
R25, R26, R156, R195: 51R; R_0603_1608Metric; MPN RC0603JR-0751RL
TR5, TR6, TR8: HM2108NL; MPN HM2108NL

Connections:
/LTC6811_3/IMA: R195.1, TR8.3; also elsewhere on the board
/LTC6811_3/IMB: R24.1, TR5.4; also elsewhere on the board
/LTC6811_3/IPA: R156.2, TR8.1; also elsewhere on the board
/LTC6811_3/IPB: R23.2, TR5.6; also elsewhere on the board
/LTC6811_4/IMA: R53.1, TR5.3; also elsewhere on the board
/LTC6811_4/IMB: R26.1, TR6.6; also elsewhere on the board
/LTC6811_4/IPA: R52.2, TR5.1; also elsewhere on the board
/LTC6811_4/IPB: R25.2, TR6.4; also elsewhere on the board
GND_PACK: C44.2, C46.1, C72.2, C75.2, C76.2, C92.2, C94.2, C96.2; also elsewhere on the board
unnamed: C44.1, R23.1, R24.2
unnamed: C46.2, R25.1, R26.2
unnamed: C72.1, R52.1, R53.2
unnamed: C75.1, TR5.5
unnamed: C76.1, TR5.2
unnamed: C92.1, TR8.2
unnamed: C94.1, R156.1, R195.2
unnamed: C96.1, TR6.5
unnamed: J9.1, TR6.3
unnamed: J9.2, TR6.1
unnamed: J22.1, TR8.6
unnamed: J22.2, TR8.4

Notes on the sheet:
TO Slaves
