tetra-aero/LTC6811_ESP32/LTC6811_ESP32_V5/Slaves/LTC6811_ESP32_Slaves_V5.kicad_pcb

## KiCad design LTC6811_ESP32_V5/Slaves/LTC6811_ESP32_Slaves_V5.kicad_pcb (continued)

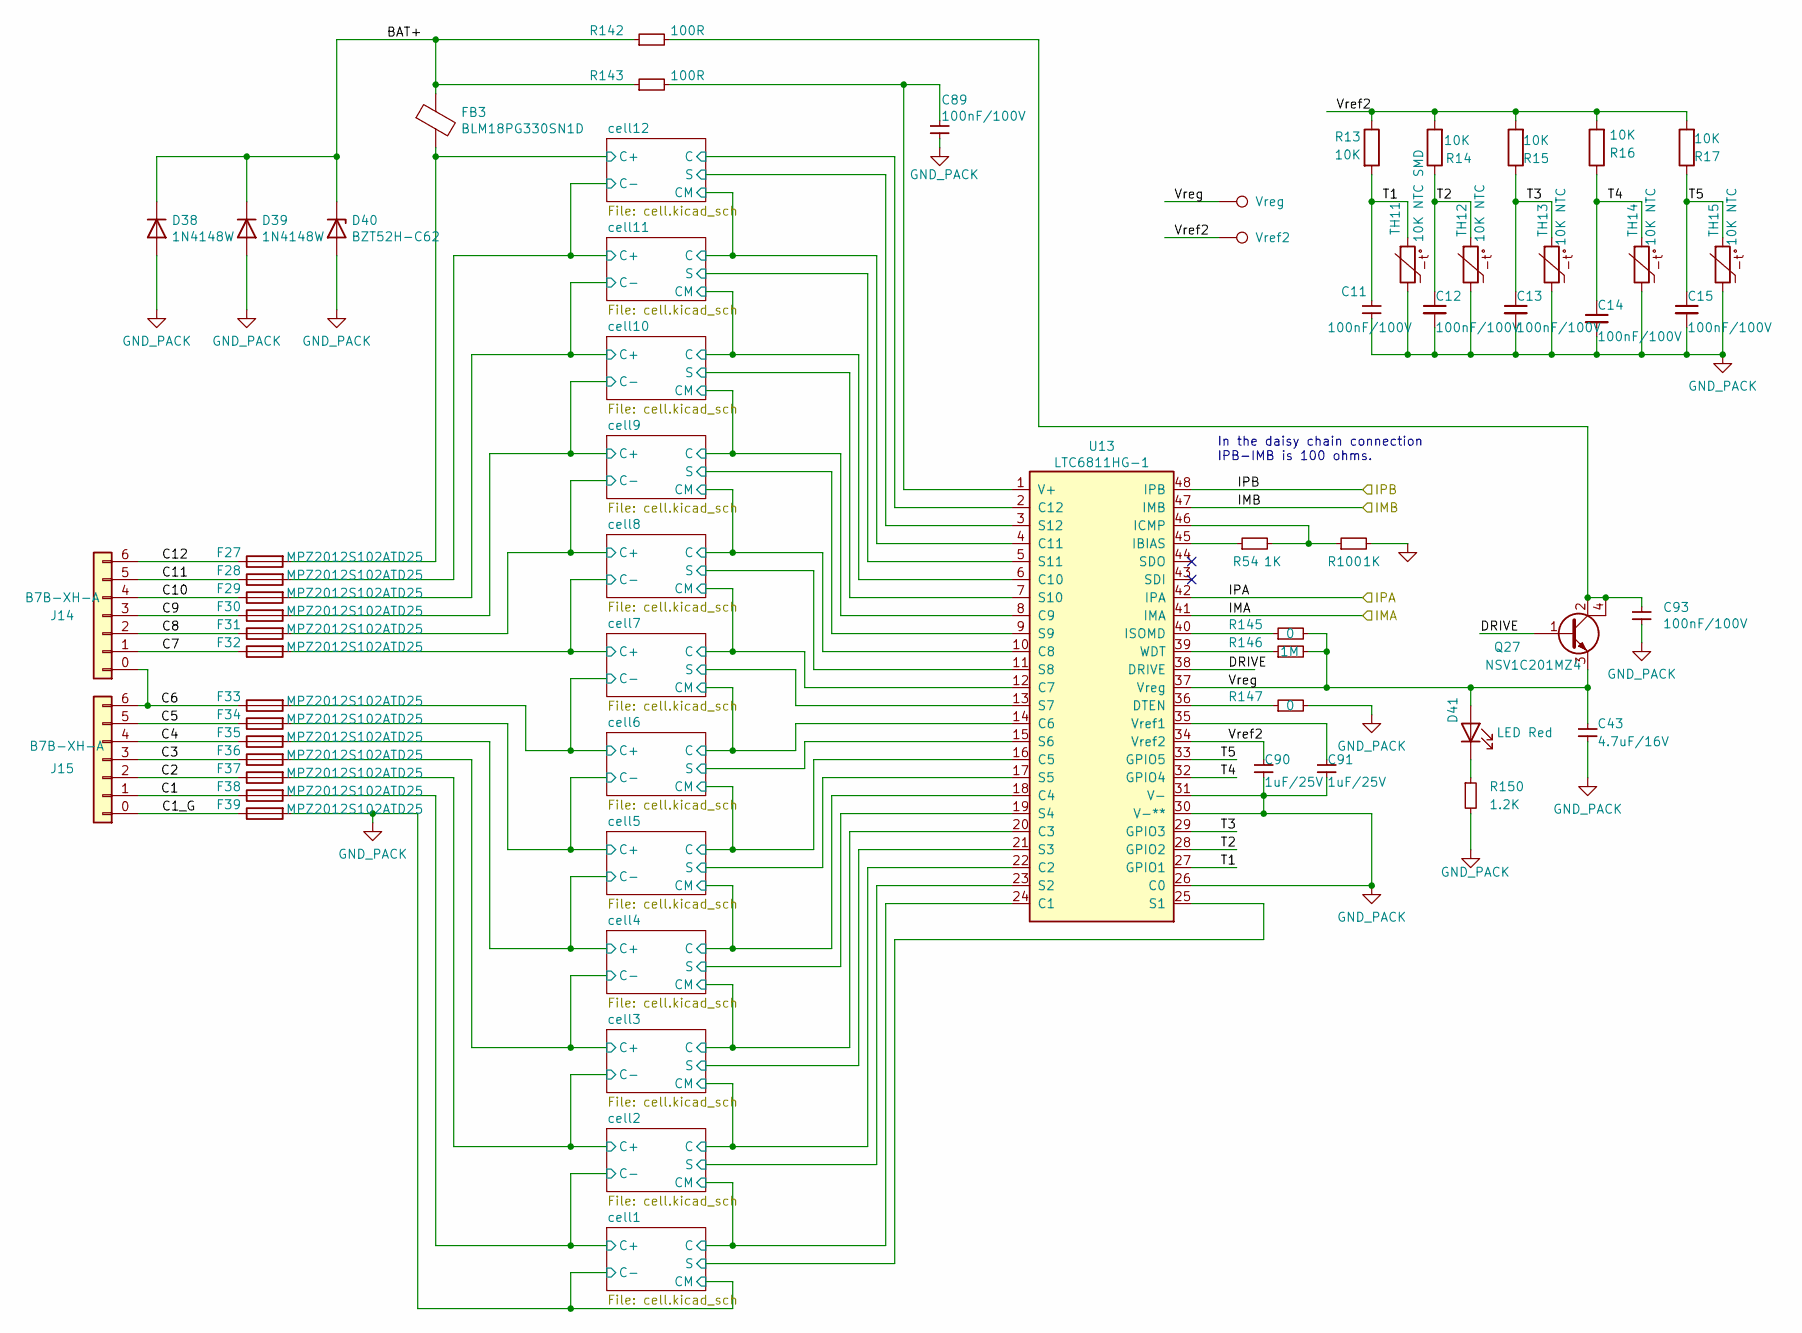
[picture p47: schematic LTC6811.kicad_sch]

Parts:
C11, C12, C13, C14, C15, C89, C93: 100nF/100V; C_0603_1608Metric; MPN CL10B104KC8NNNC
C43: 4.7uF/16V; C_0603_1608Metric; MPN CL10A475KO8NNNC
C90, C91: 1uF/25V; C_0603_1608Metric; MPN CL10B105KA8NNNC
D38, D39: 1N4148W; D_SOD-123; MPN 1N4148W-7-F
D40: BZT52H-C62; D_SOD-123F; MPN BZT52H-C62,115
D41: LED Red; LED_0603_1608Metric; MPN LTST-C190KRKT
F27, F28, F29, F30, F31, F32, F33, F34, F35, F36, F37, F38, F39: MPZ2012S102ATD25; Fuse_0805_2012Metric; MPN MPZ2012S102ATD25
FB3: BLM18PG330SN1D; R_0603_1608Metric; MPN BLM18PG330SN1D
J14, J15: B7B-XH-A; JST_XH_B7B-XH-A_1x07_P2.50mm_Vertical_BAT_6S; MPN B7B-XH-A
Q27: NSV1C201MZ4; SOT-223; MPN NSV1C201MZ4T1G
R13, R14, R15, R16, R17: 10K; R_0603_1608Metric; MPN RC0603FR-0710KL
R54, R100: 1K; R_0603_1608Metric; MPN RC0603FR-071KL
R142, R143: 100R; R_0603_1608Metric; MPN RC0603FR-07100RL
R145, R147: 0; R_0603_1608Metric; MPN RC0603JR-070RL
R146: 1M; R_0603_1608Metric; MPN RC0603JR-071ML
R150: 1.2K; R_0603_1608Metric; MPN RC0603JR-071K2L
TH11: 10K NTC SMD; R_0603_1608Metric; MPN NCU18XH103F6SRB
TH12, TH13, TH14, TH15: 10K NTC; R_Axial_DIN0204_L3.6mm_D1.6mm_P1.90mm_Vertical; MPN MF52C1103F3380
TP7: Vreg; TestPoint_Pad_D1.0mm
TP8: Vref2; TestPoint_Pad_D1.0mm
U13: LTC6811HG-1; TSSOP-48_6.1x12.5mm_P0.5mm; MPN LTC6811HG-1#3ZZPBF

Connections:
/LTC6811_3/BAT+: D38.1 (K), D39.1 (K), D40.1 (K), FB3.1, R142.1, R143.1
/LTC6811_3/C1: F38.1, J15.1 (Pin_2)
/LTC6811_3/C1_G: F39.1, J15.0 (Pin_1)
/LTC6811_3/C2: F37.1, J15.2 (Pin_3)
/LTC6811_3/C3: F36.1, J15.3 (Pin_4)
/LTC6811_3/C4: F35.1, J15.4 (Pin_5)
/LTC6811_3/C5: F34.1, J15.5 (Pin_6)
/LTC6811_3/C6: F33.1, J14.0 (Pin_1), J15.6 (Pin_7)
/LTC6811_3/C7: F32.1, J14.1 (Pin_2)
/LTC6811_3/C8: F31.1, J14.2 (Pin_3)
/LTC6811_3/C9: F30.1, J14.3 (Pin_4)
/LTC6811_3/C10: F29.1, J14.4 (Pin_5)
/LTC6811_3/C11: F28.1, J14.5 (Pin_6)
/LTC6811_3/C12: F27.1, J14.6 (Pin_7)
/LTC6811_3/DRIVE: Q27.1 (B), U13.38 (DRIVE)
/LTC6811_3/IMA: U13.41 (IMA); also elsewhere on the board
/LTC6811_3/IMB: U13.47 (IMB); also elsewhere on the board
/LTC6811_3/IPA: U13.42 (IPA); also elsewhere on the board
/LTC6811_3/IPB: U13.48 (IPB); also elsewhere on the board
/LTC6811_3/T1: C11.1, R13.2, TH11.1, U13.27 (GPIO1)
/LTC6811_3/T2: C12.1, R14.1, TH12.1, U13.28 (GPIO2)
/LTC6811_3/T3: C13.1, R15.1, TH13.1, U13.29 (GPIO3)
/LTC6811_3/T4: C14.1, R16.1, TH14.1, U13.32 (GPIO4)
/LTC6811_3/T5: C15.1, R17.1, TH15.1, U13.33 (GPIO5)
/LTC6811_3/Vref2: C90.1, R13.1, R14.2, R15.2, R16.2, R17.2, TP8.1, U13.34 (Vref2)
/LTC6811_3/Vreg: C43.1, D41.2 (A), Q27.3 (E), R145.2, R146.2, TP7.1, U13.37 (Vreg)
/LTC6811_3/cell1/C: U13.24 (C1); also elsewhere on the board
/LTC6811_3/cell1/C+: F38.2; also elsewhere on the board
/LTC6811_3/cell1/S: U13.25 (S1); also elsewhere on the board
/LTC6811_3/cell2/C: U13.22 (C2); also elsewhere on the board
/LTC6811_3/cell2/C+: F37.2; also elsewhere on the board
/LTC6811_3/cell2/S: U13.23 (S2); also elsewhere on the board
/LTC6811_3/cell3/C: U13.20 (C3); also elsewhere on the board
/LTC6811_3/cell3/C+: F36.2; also elsewhere on the board
/LTC6811_3/cell3/S: U13.21 (S3); also elsewhere on the board
/LTC6811_3/cell4/C: U13.18 (C4); also elsewhere on the board
/LTC6811_3/cell4/C+: F35.2; also elsewhere on the board
/LTC6811_3/cell4/S: U13.19 (S4); also elsewhere on the board
/LTC6811_3/cell5/C: U13.16 (C5); also elsewhere on the board
/LTC6811_3/cell5/C+: F34.2; also elsewhere on the board
/LTC6811_3/cell5/S: U13.17 (S5); also elsewhere on the board
/LTC6811_3/cell6/C: U13.14 (C6); also elsewhere on the board
/LTC6811_3/cell6/C+: F33.2; also elsewhere on the board
/LTC6811_3/cell6/S: U13.15 (S6); also elsewhere on the board
/LTC6811_3/cell7/C: U13.12 (C7); also elsewhere on the board
/LTC6811_3/cell7/C+: F32.2; also elsewhere on the board
/LTC6811_3/cell7/S: U13.13 (S7); also elsewhere on the board
/LTC6811_3/cell8/C: U13.10 (C8); also elsewhere on the board
/LTC6811_3/cell8/C+: F31.2; also elsewhere on the board
/LTC6811_3/cell8/S: U13.11 (S8); also elsewhere on the board
/LTC6811_3/cell9/S: U13.9 (S9); also elsewhere on the board
/LTC6811_3/cell10/C: U13.6 (C10); also elsewhere on the board
/LTC6811_3/cell10/C+: F29.2; also elsewhere on the board
/LTC6811_3/cell10/C-: F30.2; also elsewhere on the board
/LTC6811_3/cell10/CM: U13.8 (C9); also elsewhere on the board
/LTC6811_3/cell10/S: U13.7 (S10); also elsewhere on the board
/LTC6811_3/cell11/C: U13.4 (C11); also elsewhere on the board
/LTC6811_3/cell11/C+: F28.2; also elsewhere on the board
/LTC6811_3/cell11/S: U13.5 (S11); also elsewhere on the board
/LTC6811_3/cell12/C: U13.2 (C12); also elsewhere on the board
/LTC6811_3/cell12/C+: F27.2, FB3.2; also elsewhere on the board
/LTC6811_3/cell12/S: U13.3 (S12); also elsewhere on the board
GND_PACK: C11.2, C12.2, C13.2, C14.2, C15.2, C43.2, C89.2, C90.2, C91.2, C93.2, D38.2 (A), D39.2 (A), D40.2 (A), F39.2, R100.2, R147.2, R150.2, TH11.2, TH12.2, TH13.2, TH14.2, TH15.2, U13.26 (C0), U13.30 (V-**), U13.31 (V-); also elsewhere on the board
unnamed: C93.1, Q27.2 (C), Q27.4 (C), R142.2
unnamed: D41.1 (K), R150.1
unnamed: R147.1, U13.36 (DTEN)
unnamed: R54.1, U13.45 (IBIAS)
unnamed: R54.2, R100.1, U13.46 (ICMP)
unnamed: R145.1, U13.40 (ISOMD)
unnamed: C89.1, R143.2, U13.1 (V+)
unnamed: C91.1, U13.35 (Vref1)
unnamed: R146.1, U13.39 (WDT)

Parts of its further copies:
C16, C17, C18, C19, C22, C115, C119: 100nF/100V; C_0603_1608Metric; MPN CL10B104KC8NNNC
C66: 4.7uF/16V; C_0603_1608Metric; MPN CL10A475KO8NNNC
C116, C117: 1uF/25V; C_0603_1608Metric; MPN CL10B105KA8NNNC
D54, D55: 1N4148W; D_SOD-123; MPN 1N4148W-7-F
D56: BZT52H-C62; D_SOD-123F; MPN BZT52H-C62,115
D57: LED Red; LED_0603_1608Metric; MPN LTST-C190KRKT
F40, F41, F42, F43, F44, F45, F46, F47, F48, F49, F50, F51, F52: MPZ2012S102ATD25; Fuse_0805_2012Metric; MPN MPZ2012S102ATD25
FB4: BLM18PG330SN1D; R_0603_1608Metric; MPN BLM18PG330SN1D
J16, J17: B7B-XH-A; JST_XH_B7B-XH-A_1x07_P2.50mm_Vertical_BAT_6S; MPN B7B-XH-A
Q40: NSV1C201MZ4; SOT-223; MPN NSV1C201MZ4T1G
R18, R19, R20, R21, R22: 10K; R_0603_1608Metric; MPN RC0603FR-0710KL
R93, R101: 1K; R_0603_1608Metric; MPN RC0603FR-071KL
R193, R194: 100R; R_0603_1608Metric; MPN RC0603FR-07100RL
R196, R198: 0; R_0603_1608Metric; MPN RC0603JR-070RL
R197: 1M; R_0603_1608Metric; MPN RC0603JR-071ML
R201: 1.2K; R_0603_1608Metric; MPN RC0603JR-071K2L
TH16: 10K NTC SMD; R_0603_1608Metric; MPN NCU18XH103F6SRB
TH17, TH18, TH19, TH20: 10K NTC; R_Axial_DIN0204_L3.6mm_D1.6mm_P1.90mm_Vertical; MPN MF52C1103F3380
TP9: Vreg; TestPoint_Pad_D1.0mm
TP10: Vref2; TestPoint_Pad_D1.0mm
U14: LTC6811HG-1; TSSOP-48_6.1x12.5mm_P0.5mm; MPN LTC6811HG-1#3ZZPBF

Connections of its further copies:
/LTC6811_4/BAT+: D54.1 (K), D55.1 (K), D56.1 (K), FB4.1, R193.1, R194.1
/LTC6811_4/C1: F51.1, J17.1 (Pin_2)
/LTC6811_4/C1_G: F52.1, J17.0 (Pin_1)
/LTC6811_4/C2: F50.1, J17.2 (Pin_3)
/LTC6811_4/C3: F49.1, J17.3 (Pin_4)
/LTC6811_4/C4: F48.1, J17.4 (Pin_5)
/LTC6811_4/C5: F47.1, J17.5 (Pin_6)
/LTC6811_4/C6: F46.1, J16.0 (Pin_1), J17.6 (Pin_7)
/LTC6811_4/C7: F45.1, J16.1 (Pin_2)
/LTC6811_4/C8: F44.1, J16.2 (Pin_3)
/LTC6811_4/C9: F43.1, J16.3 (Pin_4)
/LTC6811_4/C10: F42.1, J16.4 (Pin_5)
/LTC6811_4/C11: F41.1, J16.5 (Pin_6)
/LTC6811_4/C12: F40.1, J16.6 (Pin_7)
/LTC6811_4/DRIVE: Q40.1 (B), U14.38 (DRIVE)
/LTC6811_4/IMA: U14.41 (IMA); also elsewhere on the board
/LTC6811_4/IMB: U14.47 (IMB); also elsewhere on the board
/LTC6811_4/IPA: U14.42 (IPA); also elsewhere on the board
/LTC6811_4/IPB: U14.48 (IPB); also elsewhere on the board
/LTC6811_4/T1: C16.1, R18.2, TH16.1, U14.27 (GPIO1)
/LTC6811_4/T2: C17.1, R19.1, TH17.1, U14.28 (GPIO2)
/LTC6811_4/T3: C18.1, R20.1, TH18.1, U14.29 (GPIO3)
/LTC6811_4/T4: C19.1, R21.1, TH19.1, U14.32 (GPIO4)
/LTC6811_4/T5: C22.1, R22.1, TH20.1, U14.33 (GPIO5)
/LTC6811_4/Vref2: C116.1, R18.1, R19.2, R20.2, R21.2, R22.2, TP10.1, U14.34 (Vref2)
/LTC6811_4/Vreg: C66.1, D57.2 (A), Q40.3 (E), R196.2, R197.2, TP9.1, U14.37 (Vreg)
/LTC6811_4/cell1/C: U14.24 (C1); also elsewhere on the board
/LTC6811_4/cell1/C+: F51.2; also elsewhere on the board
/LTC6811_4/cell1/S: U14.25 (S1); also elsewhere on the board
/LTC6811_4/cell2/C: U14.22 (C2); also elsewhere on the board
/LTC6811_4/cell2/C+: F50.2; also elsewhere on the board
/LTC6811_4/cell2/S: U14.23 (S2); also elsewhere on the board
/LTC6811_4/cell3/C: U14.20 (C3); also elsewhere on the board
/LTC6811_4/cell3/C+: F49.2; also elsewhere on the board
/LTC6811_4/cell3/S: U14.21 (S3); also elsewhere on the board
/LTC6811_4/cell4/C: U14.18 (C4); also elsewhere on the board
/LTC6811_4/cell4/C+: F48.2; also elsewhere on the board
/LTC6811_4/cell4/S: U14.19 (S4); also elsewhere on the board
/LTC6811_4/cell5/C: U14.16 (C5); also elsewhere on the board
/LTC6811_4/cell5/C+: F47.2; also elsewhere on the board
/LTC6811_4/cell5/S: U14.17 (S5); also elsewhere on the board
/LTC6811_4/cell6/C: U14.14 (C6); also elsewhere on the board
/LTC6811_4/cell6/C+: F46.2; also elsewhere on the board
/LTC6811_4/cell6/S: U14.15 (S6); also elsewhere on the board
/LTC6811_4/cell7/C: U14.12 (C7); also elsewhere on the board
/LTC6811_4/cell7/C+: F45.2; also elsewhere on the board
/LTC6811_4/cell7/S: U14.13 (S7); also elsewhere on the board
/LTC6811_4/cell8/C: U14.10 (C8); also elsewhere on the board
/LTC6811_4/cell8/C+: F44.2; also elsewhere on the board
/LTC6811_4/cell8/S: U14.11 (S8); also elsewhere on the board
/LTC6811_4/cell9/S: U14.9 (S9); also elsewhere on the board
/LTC6811_4/cell10/C: U14.6 (C10); also elsewhere on the board
/LTC6811_4/cell10/C+: F42.2; also elsewhere on the board
/LTC6811_4/cell10/C-: F43.2; also elsewhere on the board
/LTC6811_4/cell10/CM: U14.8 (C9); also elsewhere on the board
/LTC6811_4/cell10/S: U14.7 (S10); also elsewhere on the board
/LTC6811_4/cell11/C: U14.4 (C11); also elsewhere on the board
/LTC6811_4/cell11/C+: F41.2; also elsewhere on the board
/LTC6811_4/cell11/S: U14.5 (S11); also elsewhere on the board
/LTC6811_4/cell12/C: U14.2 (C12); also elsewhere on the board
/LTC6811_4/cell12/C+: F40.2, FB4.2; also elsewhere on the board
/LTC6811_4/cell12/S: U14.3 (S12); also elsewhere on the board
GND_PACK: C16.2, C17.2, C18.2, C19.2, C22.2, C66.2, C115.2, C116.2, C117.2, C119.2, D54.2 (A), D55.2 (A), D56.2 (A), F52.2, R101.2, R198.2, R201.2, TH16.2, TH17.2, TH18.2, TH19.2, TH20.2, U14.26 (C0), U14.30 (V-**), U14.31 (V-); also elsewhere on the board
unnamed: C119.1, Q40.2 (C), Q40.4 (C), R193.2
unnamed: D57.1 (K), R201.1
unnamed: R198.1, U14.36 (DTEN)
unnamed: R93.1, U14.45 (IBIAS)
unnamed: R93.2, R101.1, U14.46 (ICMP)
unnamed: R196.1, U14.40 (ISOMD)
unnamed: C115.1, R194.2, U14.1 (V+)
unnamed: C117.1, U14.35 (Vref1)
unnamed: R197.1, U14.39 (WDT)

Notes on the sheet:
In the daisy chain connection IPB-IMB is 100 ohms.

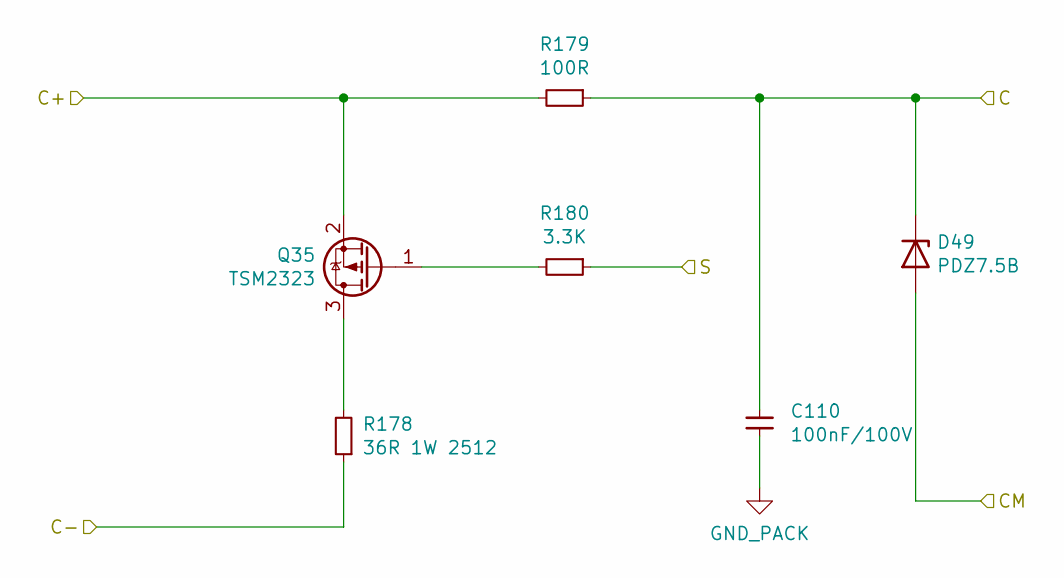
[picture p48: schematic cell.kicad_sch]

Parts:
C110: 100nF/100V; C_0603_1608Metric; MPN CL10B104KC8NNNC
D49: PDZ7.5B; D_SOD-323_HandSoldering; MPN PDZ7.5BZ
Q35: TSM2323; SOT-23; MPN TSM2323CX RFG
R178: 36R 1W 2512; R_2512_6332Metric; MPN RTT25360JTE
R179: 100R; R_0603_1608Metric; MPN RC0603FR-07100RL
R180: 3.3K; R_0603_1608Metric; MPN RC0603FR-073K3L

Connections:
/LTC6811_3/cell4/C: D49.2 (A); also elsewhere on the board
/LTC6811_3/cell4/C+: R178.1; also elsewhere on the board
/LTC6811_3/cell5/C: C110.1, D49.1 (K), R179.1; also elsewhere on the board
/LTC6811_3/cell5/C+: Q35.2 (S), R179.2; also elsewhere on the board
/LTC6811_3/cell5/S: R180.1; also elsewhere on the board
GND_PACK: C110.2; also elsewhere on the board
unnamed: Q35.3 (D), R178.2
unnamed: Q35.1 (G), R180.2

Parts of its further copies:
C103, C104, C105, C106, C107, C108, C109, C111, C112, C113, C114, C129, C130, C131, C132, C133, C134, C135, C136, C137, C138, C139, C140: 100nF/100V; C_0603_1608Metric; MPN CL10B104KC8NNNC
D42, D43, D44, D45, D46, D47, D48, D50, D51, D52, D53, D58, D59, D60, D61, D62, D63, D64, D65, D66, D67, D68, D69: PDZ7.5B; D_SOD-323_HandSoldering; MPN PDZ7.5BZ
Q28, Q29, Q30, Q31, Q32, Q33, Q34, Q36, Q37, Q38, Q39, Q41, Q42, Q43, Q44, Q45, Q46, Q47, Q48, Q49, Q50, Q51, Q52: TSM2323; SOT-23; MPN TSM2323CX RFG
R157, R160, R163, R166, R169, R172, R175, R181, R184, R187, R190, R208, R211, R214, R217, R220, R223, R226, R229, R232, R235, R238, R241: 36R 1W 2512; R_2512_6332Metric; MPN RTT25360JTE
R158, R161, R164, R167, R170, R173, R176, R182, R185, R188, R191, R209, R212, R215, R218, R221, R224, R227, R230, R233, R236, R239, R242: 100R; R_0603_1608Metric; MPN RC0603FR-07100RL
R159, R162, R165, R168, R171, R174, R177, R183, R186, R189, R192, R210, R213, R216, R219, R222, R225, R228, R231, R234, R237, R240, R243: 3.3K; R_0603_1608Metric; MPN RC0603FR-073K3L

Connections of its further copies:
/LTC6811_3/cell1/C: C114.1, D52.2 (A), D53.1 (K), R191.1; also elsewhere on the board
/LTC6811_3/cell1/C+: Q39.2 (S), R187.1, R191.2; also elsewhere on the board
/LTC6811_3/cell1/S: R192.1; also elsewhere on the board
/LTC6811_3/cell2/C: C113.1, D51.2 (A), D52.1 (K), R188.1; also elsewhere on the board
/LTC6811_3/cell2/C+: Q38.2 (S), R184.1, R188.2; also elsewhere on the board
/LTC6811_3/cell2/S: R189.1; also elsewhere on the board
/LTC6811_3/cell3/C: C112.1, D50.2 (A), D51.1 (K), R185.1; also elsewhere on the board
/LTC6811_3/cell3/C+: Q37.2 (S), R181.1, R185.2; also elsewhere on the board
/LTC6811_3/cell3/S: R186.1; also elsewhere on the board
/LTC6811_3/cell4/C: C111.1, D50.1 (K), R182.1; also elsewhere on the board
/LTC6811_3/cell4/C+: Q36.2 (S), R182.2; also elsewhere on the board
/LTC6811_3/cell4/S: R183.1; also elsewhere on the board
/LTC6811_3/cell5/C: D48.2 (A); also elsewhere on the board
/LTC6811_3/cell5/C+: R175.1; also elsewhere on the board
/LTC6811_3/cell6/C: C109.1, D47.2 (A), D48.1 (K), R176.1; also elsewhere on the board
/LTC6811_3/cell6/C+: Q34.2 (S), R172.1, R176.2; also elsewhere on the board
/LTC6811_3/cell6/S: R177.1; also elsewhere on the board
/LTC6811_3/cell7/C: C108.1, D46.2 (A), D47.1 (K), R173.1; also elsewhere on the board
/LTC6811_3/cell7/C+: Q33.2 (S), R169.1, R173.2; also elsewhere on the board
/LTC6811_3/cell7/S: R174.1; also elsewhere on the board
/LTC6811_3/cell8/C: C107.1, D45.2 (A), D46.1 (K), R170.1; also elsewhere on the board
/LTC6811_3/cell8/C+: Q32.2 (S), R166.1, R170.2; also elsewhere on the board
/LTC6811_3/cell8/S: R171.1; also elsewhere on the board
/LTC6811_3/cell9/S: R168.1; also elsewhere on the board
/LTC6811_3/cell10/C: C105.1, D43.2 (A), D44.1 (K), R164.1; also elsewhere on the board
/LTC6811_3/cell10/C+: Q30.2 (S), R160.1, R164.2; also elsewhere on the board
/LTC6811_3/cell10/C-: Q31.2 (S), R163.1, R167.2; also elsewhere on the board
/LTC6811_3/cell10/CM: C106.1, D44.2 (A), D45.1 (K), R167.1; also elsewhere on the board
/LTC6811_3/cell10/S: R165.1; also elsewhere on the board
/LTC6811_3/cell11/C: C104.1, D42.2 (A), D43.1 (K), R161.1; also elsewhere on the board
/LTC6811_3/cell11/C+: Q29.2 (S), R157.1, R161.2; also elsewhere on the board
/LTC6811_3/cell11/S: R162.1; also elsewhere on the board
/LTC6811_3/cell12/C: C103.1, D42.1 (K), R158.1; also elsewhere on the board
/LTC6811_3/cell12/C+: Q28.2 (S), R158.2; also elsewhere on the board
/LTC6811_3/cell12/S: R159.1; also elsewhere on the board
/LTC6811_4/cell1/C: C140.1, D68.2 (A), D69.1 (K), R242.1; also elsewhere on the board
/LTC6811_4/cell1/C+: Q52.2 (S), R238.1, R242.2; also elsewhere on the board
/LTC6811_4/cell1/S: R243.1; also elsewhere on the board
/LTC6811_4/cell2/C: C139.1, D67.2 (A), D68.1 (K), R239.1; also elsewhere on the board
/LTC6811_4/cell2/C+: Q51.2 (S), R235.1, R239.2; also elsewhere on the board
/LTC6811_4/cell2/S: R240.1; also elsewhere on the board
/LTC6811_4/cell3/C: C138.1, D66.2 (A), D67.1 (K), R236.1; also elsewhere on the board
/LTC6811_4/cell3/C+: Q50.2 (S), R232.1, R236.2; also elsewhere on the board
/LTC6811_4/cell3/S: R237.1; also elsewhere on the board
/LTC6811_4/cell4/C: C137.1, D65.2 (A), D66.1 (K), R233.1; also elsewhere on the board
/LTC6811_4/cell4/C+: Q49.2 (S), R229.1, R233.2; also elsewhere on the board
/LTC6811_4/cell4/S: R234.1; also elsewhere on the board
/LTC6811_4/cell5/C: C136.1, D64.2 (A), D65.1 (K), R230.1; also elsewhere on the board
/LTC6811_4/cell5/C+: Q48.2 (S), R226.1, R230.2; also elsewhere on the board
/LTC6811_4/cell5/S: R231.1; also elsewhere on the board
/LTC6811_4/cell6/C: C135.1, D63.2 (A), D64.1 (K), R227.1; also elsewhere on the board
/LTC6811_4/cell6/C+: Q47.2 (S), R223.1, R227.2; also elsewhere on the board
/LTC6811_4/cell6/S: R228.1; also elsewhere on the board
/LTC6811_4/cell7/C: C134.1, D62.2 (A), D63.1 (K), R224.1; also elsewhere on the board
/LTC6811_4/cell7/C+: Q46.2 (S), R220.1, R224.2; also elsewhere on the board
/LTC6811_4/cell7/S: R225.1; also elsewhere on the board
/LTC6811_4/cell8/C: C133.1, D61.2 (A), D62.1 (K), R221.1; also elsewhere on the board
/LTC6811_4/cell8/C+: Q45.2 (S), R217.1, R221.2; also elsewhere on the board
/LTC6811_4/cell8/S: R222.1; also elsewhere on the board
/LTC6811_4/cell9/S: R219.1; also elsewhere on the board
/LTC6811_4/cell10/C: C131.1, D59.2 (A), D60.1 (K), R215.1; also elsewhere on the board
/LTC6811_4/cell10/C+: Q43.2 (S), R211.1, R215.2; also elsewhere on the board
/LTC6811_4/cell10/C-: Q44.2 (S), R214.1, R218.2; also elsewhere on the board
/LTC6811_4/cell10/CM: C132.1, D60.2 (A), D61.1 (K), R218.1; also elsewhere on the board
/LTC6811_4/cell10/S: R216.1; also elsewhere on the board
/LTC6811_4/cell11/C: C130.1, D58.2 (A), D59.1 (K), R212.1; also elsewhere on the board
/LTC6811_4/cell11/C+: Q42.2 (S), R208.1, R212.2; also elsewhere on the board
/LTC6811_4/cell11/S: R213.1; also elsewhere on the board
/LTC6811_4/cell12/C: C129.1, D58.1 (K), R209.1; also elsewhere on the board
/LTC6811_4/cell12/C+: Q41.2 (S), R209.2; also elsewhere on the board
/LTC6811_4/cell12/S: R210.1; also elsewhere on the board
GND_PACK: C103.2, C104.2, C105.2, C106.2, C107.2, C108.2, C109.2, C111.2, C112.2, C113.2, C114.2, C129.2, C130.2, C131.2, C132.2, C133.2, C134.2, C135.2, C136.2, C137.2, C138.2, C139.2, C140.2, D53.2 (A), D69.2 (A), R190.1, R241.1; also elsewhere on the board
unnamed: Q28.3 (D), R157.2
unnamed: Q28.1 (G), R159.2
unnamed: Q29.3 (D), R160.2
unnamed: Q29.1 (G), R162.2
unnamed: Q30.3 (D), R163.2
unnamed: Q30.1 (G), R165.2
unnamed: Q31.3 (D), R166.2
unnamed: Q31.1 (G), R168.2
unnamed: Q32.3 (D), R169.2
unnamed: Q32.1 (G), R171.2
unnamed: Q33.3 (D), R172.2
unnamed: Q33.1 (G), R174.2
unnamed: Q34.3 (D), R175.2
unnamed: Q34.1 (G), R177.2
unnamed: Q36.3 (D), R181.2
unnamed: Q36.1 (G), R183.2
unnamed: Q37.3 (D), R184.2
unnamed: Q37.1 (G), R186.2
unnamed: Q38.3 (D), R187.2
unnamed: Q38.1 (G), R189.2
unnamed: Q39.3 (D), R190.2
unnamed: Q39.1 (G), R192.2
unnamed: Q41.3 (D), R208.2
unnamed: Q41.1 (G), R210.2
unnamed: Q42.3 (D), R211.2
unnamed: Q42.1 (G), R213.2
unnamed: Q43.3 (D), R214.2
unnamed: Q43.1 (G), R216.2
unnamed: Q44.3 (D), R217.2
unnamed: Q44.1 (G), R219.2
unnamed: Q45.3 (D), R220.2
unnamed: Q45.1 (G), R222.2
unnamed: Q46.3 (D), R223.2
unnamed: Q46.1 (G), R225.2
unnamed: Q47.3 (D), R226.2
unnamed: Q47.1 (G), R228.2
unnamed: Q48.3 (D), R229.2
unnamed: Q48.1 (G), R231.2
unnamed: Q49.3 (D), R232.2
unnamed: Q49.1 (G), R234.2
unnamed: Q50.3 (D), R235.2
unnamed: Q50.1 (G), R237.2
unnamed: Q51.3 (D), R238.2
unnamed: Q51.1 (G), R240.2
unnamed: Q52.3 (D), R241.2
unnamed: Q52.1 (G), R243.2

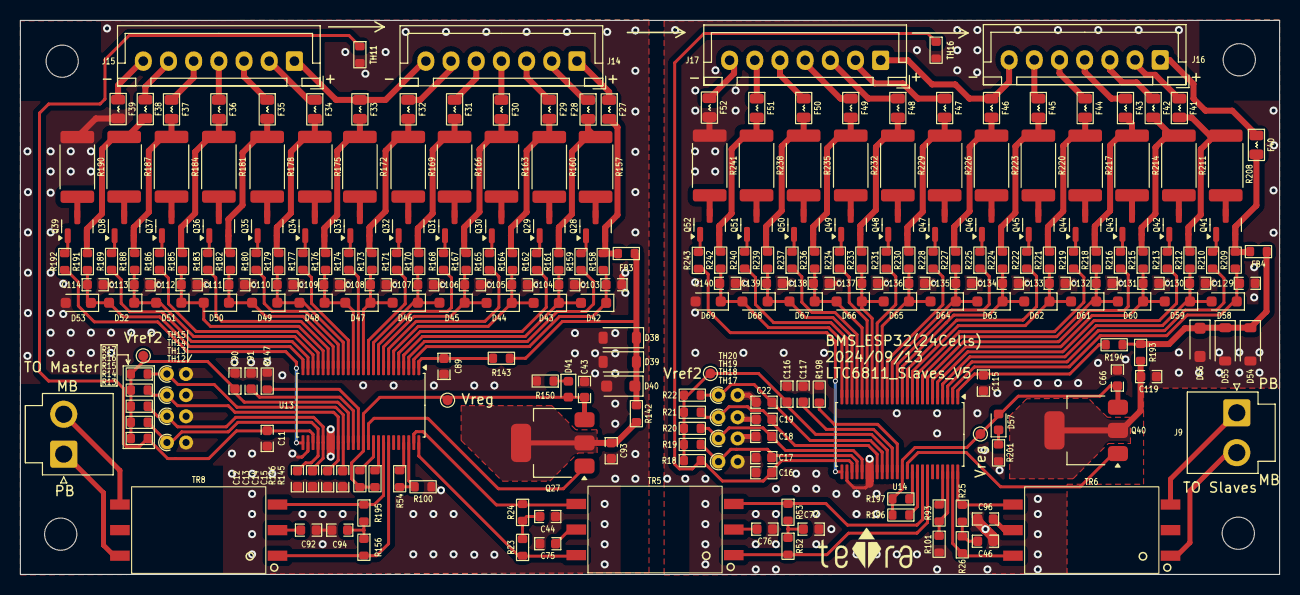
[picture p49: board LTC6811_ESP32_Slaves_V5.kicad_pcb from above]

Board: 2 copper layers, 125.0 x 55.0 mm, 275 parts (1 on the bottom side), 203 nets.
