tetra-aero/LTC6811_ESP32/Master/ESP32_Master_V2/ESP32_Master_V2.kicad_pcb

## KiCad design Master/ESP32_Master_V2/ESP32_Master_V2.kicad_pcb (2024-07-11)

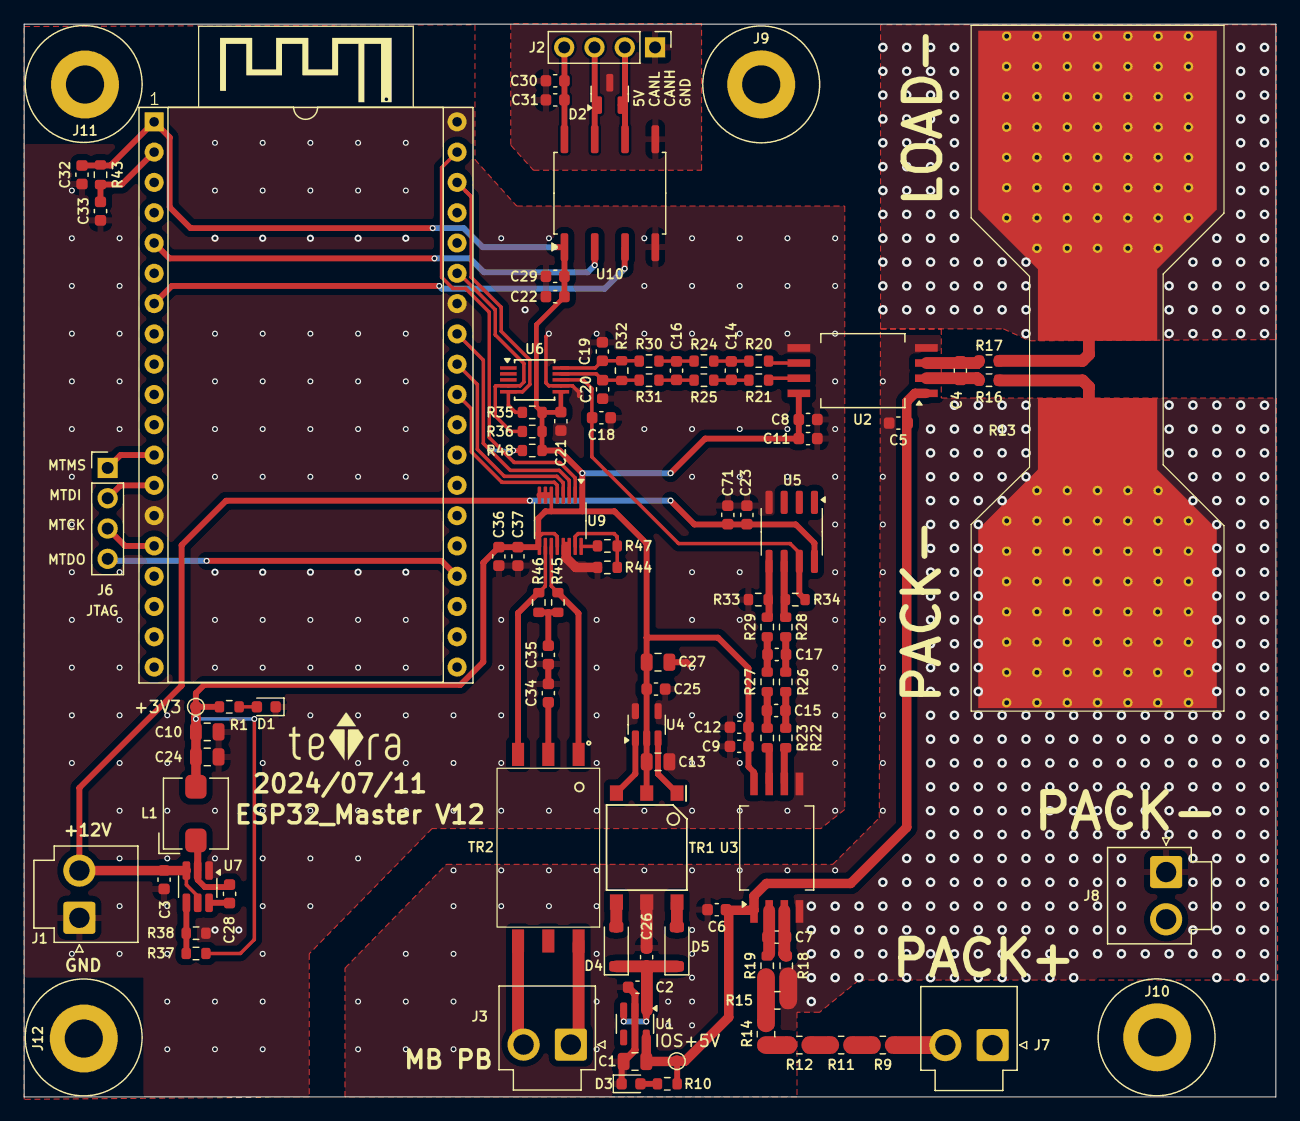
[picture p50: board ESP32_Master_V2.kicad_pcb from above]

Board: 2 copper layers, 104.9 x 90.0 mm, 106 parts (0 on the bottom side), 67 nets.

Parts:
C1, C10, C13, C24, C27: 10uF/16V; C_0805_2012Metric
C2, C5, C6, C8, C9, C18, C19, C20, C21, C23, C25, C28, C29, C31, C32, C33, C37: 100nF/100V; C_0603_1608Metric
C3, C11, C12: 2.2uF/25V; C_0603_1608Metric
C4, C7: 330pF/100V; C_0603_1608Metric
C14, C15: 2.2nF/16V; C_0603_1608Metric
C16, C17: 220pF/50V; C_0603_1608Metric
C22, C30, C36, C71: 1uF/25V; C_0603_1608Metric
C26: 4.7uF/16V; C_0603_1608Metric
C34, C35: 10nF/100V; C_0603_1608Metric
D1, D3: LED Red; LED_0603_1608Metric
D2: ESD24VS2U; SOT-23
D4, D5: MBR0520; D_SOD-123
J1: PB MB; JST_VH_B2P-VH-B_1x02_P3.96mm_Vertical
J2: CAN; PinHeader_1x04_P2.54mm_Vertical
J3: PA MA; JST_VH_B2P-VH-B_1x02_P3.96mm_Vertical
J6: JTAG /NC; PinHeader_1x04_P2.54mm_Vertical
J7, J8: Check_Votage; JST_VH_B2P-VH-B_1x02_P3.96mm_Vertical
J9, J10, J11, J12: Hole /NC; MountingHole_3.2mm_M3_ISO7380_Pad
L1: 3.3uH; L_Bourns_SRP5030T
LOGO1: teTra /NC; teTra-LOGO
R1, R10: 470R; R_0603_1608Metric
R9, R11, R12, R14: 470KΩ ±0.1% 250mW; R_0805_2012Metric
R13: 0.1MR 1% 15W; R_PSR500HTQFB0L10_Metric_Pad5.2x8.75mm_Hole
R15: 1KΩ ±0.1% 250mW; R_0805_2012Metric
R16, R17, R18, R24, R25, R26, R27, R32: 1K; R_0603_1608Metric
R19: 10R; R_0603_1608Metric
R20, R21, R22, R23: 100R; R_0603_1608Metric
R28, R29: 5.6K; R_0603_1608Metric
R30, R31: 3.3K; R_0603_1608Metric
R33, R34: 33K; R_0603_1608Metric
R35, R36: 4.7K; R_0603_1608Metric
R37: 100K; R_0603_1608Metric
R38: 22.1K; R_0603_1608Metric
R43: 10K; R_0603_1608Metric
R44: 806R; R_0603_1608Metric
R45, R46: 51R; R_0603_1608Metric
R47: 1.2K; R_0603_1608Metric
R48: 2K; R_0603_1608Metric
TP1: IOS+5V; TestPoint_Pad_D1.0mm
TP2: +3V3; TestPoint_Pad_D1.0mm
TR1: Transformer; WURTH-760390015
TR2: HM2108NL
U1: TPS76350; SOT-23-5
U2: AMC1301 or AMC1302; SSO-8_6.8x5.9mm_P1.27mm_Clearance8mm
U3: AMC1301; SSO-8_6.8x5.9mm_P1.27mm_Clearance8mm
U4: SN6501DBV; SOT-23-5
U5: OPA2197IDR; SOIC-8_3.9x4.9mm_P1.27mm
U6: ISL28022; MSOP-10_3x3mm_P0.5mm
U7: LMR51420XDDCR; SOT-23-6_Handsoldering
U8: ESP32-DevKitC V4; ESP32-DevKitc V4_DIP-38_27.9mm×48.2mm
U9: LTC6820; MSOP-16_3x4mm_P0.5mm
U10: ISO1050DUBR; SOP-8_6.62x9.15mm_P2.54mm

Connections:
+3V3: C8.1, C9.1, C10.1, C11.1, C12.1, C13.1, C21.2, C22.1, C24.1, C25.1, C27.1, C29.1, C32.2, C36.2, C37.1, L1.2, R1.2, R35.1, R36.1, R37.2, R43.1, R48.1, TP2.1, TR1.2, U2.8 (VDD2), U3.8 (VDD2), U4.2 (VCC), U6.6 (Vs), U8.1 (3V3), U9.1 (EN), U9.6 (Vcc0), U9.7 (POL), U9.8 (PHA), U9.9 (VCC), U9.12 (MSTR), U10.1 (Vcc1)
+12V: C3.1, C23.1, C71.2, J1.2, U5.8 (V+), U7.3 (VIN), U7.5 (EN)
/CAN/5V_CAN: C30.1, C31.2, J2.4, U10.8 (Vcc2)
/CAN/CANH: D2.2 (K), J2.2, U10.6 (CANL)
/CAN/CANL: D2.1 (K), J2.3, U10.7 (CANH)
/CAN/CAN_GND: C30.2, C31.1, D2.3 (A), J2.1, U10.5 (GND2)
/CAN/CAN_RX: U8.5 (IO34), U10.2 (RXD)
/CAN/CAN_TX: U8.7 (IO32), U10.3 (TXD)
/MA: J3.2, TR2.6
/MCU/IM: R46.1, TR2.3, U9.10 (IM)
/MCU/IP: R45.2, TR2.1, U9.11 (IP)
/MCU/MISO: R48.2, U8.31 (IO19), U9.3 (MISO)
/MCU/MOSI: U8.37 (IO23), U9.2 (MOSI)
/MCU/MTCK: J6.3, U8.15 (IO13)
/MCU/MTDI: J6.2, U8.13 (IO12)
/MCU/MTDO: J6.4, U8.23 (IO15)
/MCU/MTMS: J6.1, U8.12 (IO14)
/MCU/NRST: C33.2, R43.2, U8.2 (EN)
/MCU/SCK: U8.30 (IO18), U9.4 (SCK)
/MCU/SCL: R35.2, U6.5 (SCL), U8.36 (IO22)
/MCU/SDA: R36.2, U6.4 (SDA), U8.33 (IO21)
/MCU/SS: U8.29 (IO5), U9.5 (CSB)
/PA: J3.1, TR2.4
/PowerMonitor/BAT+: J7.2, R9.1
/PowerMonitor/INN: R13.2, R17.1
/PowerMonitor/ISO+5V: C1.1, C5.1, C6.1, R10.2, TP1.1, U1.5 (VOUT), U2.1 (VDD1), U3.1 (VDD1)
/PowerMonitor/VBAT_SENSE: C18.2, R34.2, U5.7, U6.8 (Vbus)
/PowerMonitor/Vin+: C19.2, R30.1, R32.1, U6.10 (Vin+)
/PowerMonitor/Vin-: C20.2, R31.1, R32.2, U6.9 (Vin-)
GND: C3.2, C8.2, C9.2, C10.2, C11.2, C12.2, C13.2, C18.1, C19.1, C20.1, C21.1, C22.2, C23.2, C24.2, C25.2, C27.2, C29.2, C32.1, C33.1, C34.2, C35.1, C36.1, C37.2, C71.1, D1.1 (K), J1.1, R33.2, R38.2, R44.2, U2.5 (GND2), U3.5 (GND2), U4.4 (GND), U4.5 (GND), U5.4 (V-), U6.7 (GND), U7.1 (GND), U8.14 (GND), U8.32 (GND), U8.38 (GND), U9.13 (SLOW), U9.14 (GND), U10.4 (GND1)
GNDA: C1.2, C2.2, C5.2, C6.2, C26.2, D3.1 (K), J8.1, R13.1, R15.2, R16.1, R18.2, TR1.5, U1.2 (GND), U2.4 (GND1), U3.4 (GND1)
unnamed: C14.1, R20.1, R24.1
unnamed: C14.2, R21.1, R25.1
unnamed: C15.1, R22.1, R26.1
unnamed: C15.2, R23.1, R27.1
unnamed: C16.1, R24.2, R30.2
unnamed: C16.2, R25.2, R31.2
unnamed: C17.1, R26.2, R28.1
unnamed: C17.2, R27.2, R29.1
unnamed: C34.1, TR2.2
unnamed: C35.2, R45.1, R46.2
unnamed: D1.2 (A), R1.1
unnamed: D3.2 (A), R10.1
unnamed: D4.2 (A), TR1.4
unnamed: C2.1, C26.1, D4.1 (K), D5.1 (K), U1.1 (VIN), U1.3 (EN)
unnamed: D5.2 (A), TR1.6
unnamed: R9.2, R11.1
unnamed: R11.2, R12.1
unnamed: R12.2, R14.1
unnamed: R14.2, R15.1, R19.1
unnamed: C4.2, R17.2, U2.3 (VINN)
unnamed: C4.1, R16.2, U2.2 (VINP)
unnamed: R20.2, U2.6 (VOUTN)
unnamed: R21.2, U2.7 (VOUTP)
unnamed: C7.2, R18.1, U3.3 (VINN)
unnamed: C7.1, R19.2, U3.2 (VINP)
unnamed: R22.2, U3.6 (VOUTN)
unnamed: R23.2, U3.7 (VOUTP)
unnamed: TR1.3, U4.1 (D1)
unnamed: TR1.1, U4.3 (D2)
unnamed: R29.2, R33.1, U5.5 (+)
unnamed: R28.2, R34.1, U5.6 (-)
unnamed: C28.2, U7.6 (CB)
unnamed: R37.1, R38.1, U7.4 (FB)
unnamed: C28.1, L1.1, U7.2 (SW)
unnamed: R47.1, U9.16 (IBIAS)
unnamed: R44.1, R47.2, U9.15 (ICMP)
