tetra-aero/LTC6811_ESP32/Slaves/ESP32_Slaves_V0/ESP32_Slaves_V0.kicad_pcb

## KiCad design Slaves/ESP32_Slaves_V0/ESP32_Slaves_V0.kicad_pcb (2024-06-14)

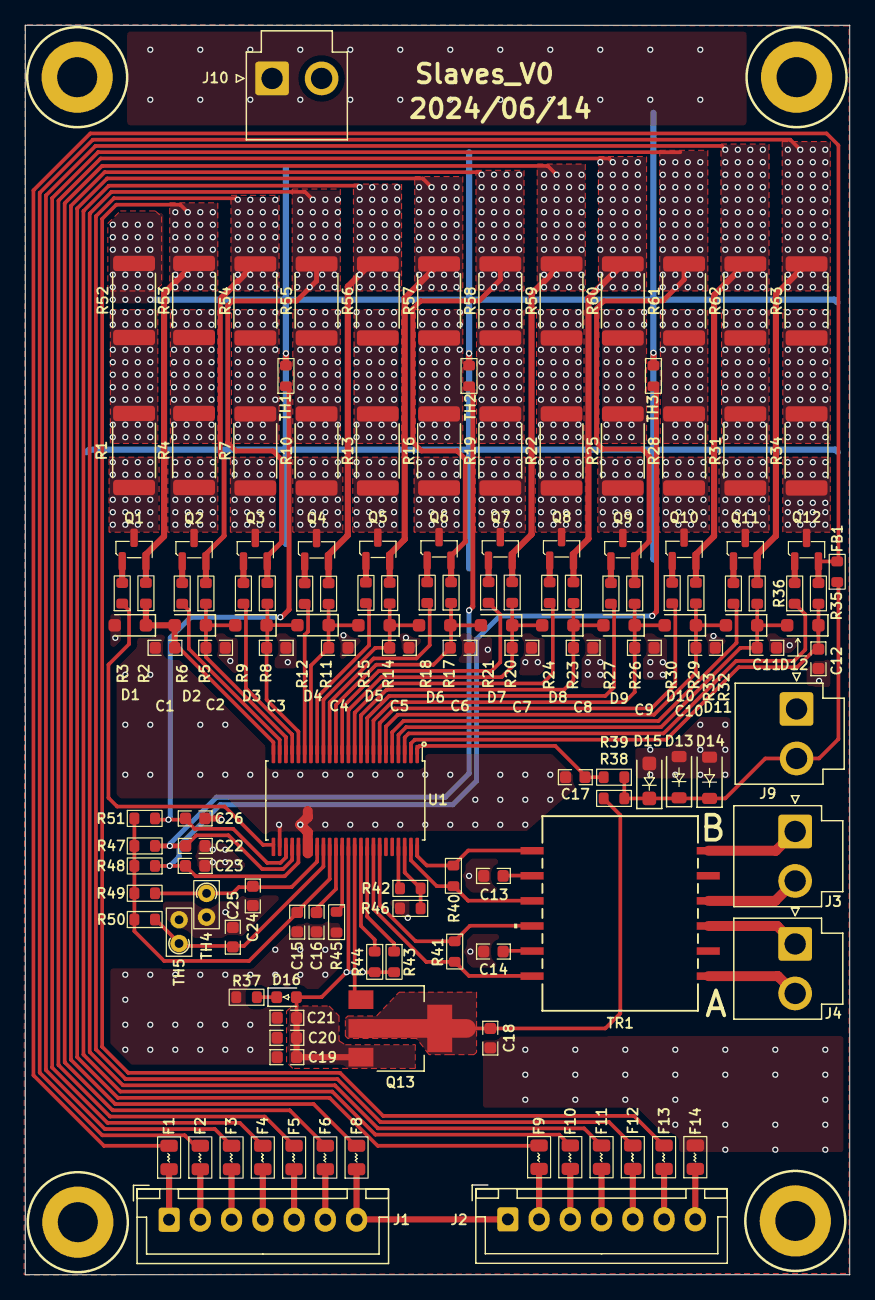
[picture p51: board ESP32_Slaves_V0.kicad_pcb from above]

Board: 2 copper layers, 65.9 x 99.9 mm, 150 parts (1 on the bottom side), 114 nets.

Parts:
C1, C2, C3, C4, C5, C6, C7, C8, C9, C10, C11, C12, C17, C18, C22, C23, C24, C25, C26: 100nF 100V; C_0603_1608Metric
C13, C14: 100pF 100V; C_0603_1608Metric
C15, C16, C19, C20, C21: 1uF 25V; C_0603_1608Metric
D1, D2, D3, D4, D5, D6, D7, D8, D9, D10, D11, D12: PDZ7.5B; D_SOD-323_HandSoldering
D13, D14: 1N4148W; D_SOD-123
D15: BZT52H-C62; D_SOD-123F
D16: LED Red; LED_0603_1608Metric
F1, F2, F3, F4, F5, F6, F8, F9, F10, F11, F12, F13, F14: MPZ2012S102ATD25; Fuse_0805_2012Metric
FB1: BLM18PG330SN1D; R_0603_1608Metric
J1, J2: B7B-XH-A; JST_XH_B7B-XH-A_1x07_P2.50mm_Vertical_BAT_6S
J3: PB MB; JST_VH_B2P-VH-B_1x02_P3.96mm_Vertical
J4: PB MA; JST_VH_B2P-VH-B_1x02_P3.96mm_Vertical
J5, J6, J7, J8: Hole /NC; MountingHole_3.2mm_M3_ISO7380_Pad
J9: BAT+; JST_VH_B2P-VH-B_1x02_P3.96mm_Vertical
J10: PACK-; JST_VH_B2P-VH-B_1x02_P3.96mm_Vertical
LOGO1: teTra; teTra-LOGO
Q1, Q2, Q3, Q4, Q5, Q6, Q7, Q8, Q9, Q10, Q11, Q12: TSM2323; SOT-23
Q13: NSV1C201MZ4; SOT-223
R1, R4, R7, R10, R13, R16, R19, R22, R25, R28, R31, R34, R52, R53, R54, R55, R56, R57, R58, R59, R60, R61, R62, R63: 18R 1W 2512; R_2512_6332Metric
R2, R5, R8, R11, R14, R17, R20, R23, R26, R29, R32, R35, R38, R39, R40, R41: 100R; R_0603_1608Metric
R3, R6, R9, R12, R15, R18, R21, R24, R27, R30, R33, R36: 3.3K; R_0603_1608Metric
R37, R42: 1.2K; R_0603_1608Metric
R43, R45: 0; R_0603_1608Metric
R44: 1M; R_0603_1608Metric
R46: 806R; R_0603_1608Metric
R47, R48, R49, R50, R51: 10K; R_0603_1608Metric
TH1, TH2, TH3: 10K NTC; R_0603_1608Metric
TH4, TH5: 10K NTC; R_Axial_DIN0204_L3.6mm_D1.6mm_P1.90mm_Vertical
TR1: HM2102NL; HM2102NL_PUL
U1: LTC6811HG-1; TSSOP-48_6.1x12.5mm_P0.5mm

Connections:
/BAT+: D13.1 (K), D14.1 (K), D15.1 (K), FB1.1, J9.2, R38.1, R39.1
/C1: F13.1, J2.1 (Pin_2)
/C1_G: F14.1, J2.0 (Pin_1)
/C2: F12.1, J2.2 (Pin_3)
/C2_G: F8.1, J1.0 (Pin_1), J2.6 (Pin_7)
/C3: F11.1, J2.3 (Pin_4)
/C4: F10.1, J2.4 (Pin_5)
/C5: F9.1, J2.5 (Pin_6)
/C7: F6.1, J1.1 (Pin_2)
/C8: F5.1, J1.2 (Pin_3)
/C9: F4.1, J1.3 (Pin_4)
/C10: F3.1, J1.4 (Pin_5)
/C11: F2.1, J1.5 (Pin_6)
/C12: F1.1, J1.6 (Pin_7)
/DRIVE: Q13.1 (B), U1.38 (DRIVE)
/IMA: R41.2, TR1.12, U1.41 (IMA)
/IMB: R40.2, TR1.9, U1.47 (IMB)
/IPA: R41.1, TR1.10, U1.42 (IPA)
/IPB: R40.1, TR1.7, U1.48 (IPB)
/T1: C26.1, R51.2, TH1.1, U1.27 (GPIO1)
/T2: C22.1, R47.1, TH2.1, U1.28 (GPIO2)
/T3: C23.1, R48.1, TH3.1, U1.29 (GPIO3)
/T4: C24.1, R49.1, TH4.1, U1.32 (GPIO4)
/T5: C25.1, R50.1, TH5.1, U1.33 (GPIO5)
/Vref2: C15.1, R47.2, R48.2, R49.2, R50.2, R51.1, U1.34 (Vref2)
/Vreg: C19.1, C20.1, C21.1, D16.2 (A), Q13.3 (E), R43.2, R44.2, U1.37 (Vreg)
/cell1/C: C1.1, D1.1 (K), D2.2 (A), R2.1, U1.24 (C1)
/cell1/C+: F13.2, Q1.2 (S), R2.2, R53.1
/cell1/S: R3.1, U1.25 (S1)
/cell2/C: C2.1, D2.1 (K), D3.2 (A), R5.1, U1.22 (C2)
/cell2/C+: F12.2, Q2.2 (S), R5.2, R54.1
/cell2/S: R6.1, U1.23 (S2)
/cell3/C: C3.1, D3.1 (K), D4.2 (A), R8.1, U1.20 (C3)
/cell3/C+: F11.2, Q3.2 (S), R8.2, R55.1
/cell3/S: R9.1, U1.21 (S3)
/cell4/C: C4.1, D4.1 (K), D5.2 (A), R11.1, U1.18 (C4)
/cell4/C+: F10.2, Q4.2 (S), R11.2, R56.1
/cell4/S: R12.1, U1.19 (S4)
/cell5/C: C5.1, D5.1 (K), D6.2 (A), R14.1, U1.16 (C5)
/cell5/C+: F9.2, Q5.2 (S), R14.2, R57.1
/cell5/S: R15.1, U1.17 (S5)
/cell6/C: C6.1, D6.1 (K), D7.2 (A), R17.1, U1.14 (C6)
/cell6/C+: F8.2, Q6.2 (S), R17.2, R58.1
/cell6/S: R18.1, U1.15 (S6)
/cell7/C: C7.1, D7.1 (K), D8.2 (A), R20.1, U1.12 (C7)
/cell7/C+: F6.2, Q7.2 (S), R20.2, R59.1
/cell7/S: R21.1, U1.13 (S7)
/cell8/C: C8.1, D8.1 (K), D9.2 (A), R23.1, U1.10 (C8)
/cell8/C+: F5.2, Q8.2 (S), R23.2, R60.1
/cell8/S: R24.1, U1.11 (S8)
/cell9/S: R27.1, U1.9 (S9)
/cell10/C: C10.1, D10.1 (K), D11.2 (A), R29.1, U1.6 (C10)
/cell10/C+: F3.2, Q10.2 (S), R29.2, R62.1
/cell10/C-: F4.2, Q9.2 (S), R26.2, R61.1
/cell10/CM: C9.1, D9.1 (K), D10.2 (A), R26.1, U1.8 (C9)
/cell10/S: R30.1, U1.7 (S10)
/cell11/C: C11.1, D11.1 (K), D12.2 (A), R32.1, U1.4 (C11)
/cell11/C+: F2.2, Q11.2 (S), R32.2, R63.1
/cell11/S: R33.1, U1.5 (S11)
/cell12/C: C12.1, D12.1 (K), R35.1, U1.2 (C12)
/cell12/C+: F1.2, FB1.2, Q12.2 (S), R35.2
/cell12/S: R36.1, U1.3 (S12)
GND_PACK: C1.2, C2.2, C3.2, C4.2, C5.2, C6.2, C7.2, C8.2, C9.2, C10.2, C11.2, C12.2, C13.2, C14.2, C15.2, C16.2, C17.2, C18.2, C19.2, C20.2, C21.2, C22.2, C23.2, C24.2, C25.2, C26.2, D1.2 (A), D13.2 (A), D14.2 (A), D15.2 (A), F14.2, J10.1, R37.2, R45.2, R46.2, R52.1, TH1.2, TH2.2, TH3.2, TH4.2, TH5.2, U1.26 (C0), U1.30 (V-**), U1.31 (V-)
unnamed: C13.1, TR1.8
unnamed: C14.1, TR1.11
unnamed: C18.1, Q13.2 (C), Q13.4 (C), R38.2
unnamed: D16.1 (K), R37.1
unnamed: J3.1, TR1.6
unnamed: J3.2, TR1.4
unnamed: J4.1, TR1.3
unnamed: J4.2, TR1.1
unnamed: Q1.3 (D), R1.2
unnamed: Q1.1 (G), R3.2
unnamed: Q2.3 (D), R4.2
unnamed: Q2.1 (G), R6.2
unnamed: Q3.3 (D), R7.2
unnamed: Q3.1 (G), R9.2
unnamed: Q4.3 (D), R10.2
unnamed: Q4.1 (G), R12.2
unnamed: Q5.3 (D), R13.2
unnamed: Q5.1 (G), R15.2
unnamed: Q6.3 (D), R16.2
unnamed: Q6.1 (G), R18.2
unnamed: Q7.3 (D), R19.2
unnamed: Q7.1 (G), R21.2
unnamed: Q8.3 (D), R22.2
unnamed: Q8.1 (G), R24.2
unnamed: Q9.3 (D), R25.2
unnamed: Q9.1 (G), R27.2
unnamed: Q10.3 (D), R28.2
unnamed: Q10.1 (G), R30.2
unnamed: Q11.3 (D), R31.2
unnamed: Q11.1 (G), R33.2
unnamed: Q12.3 (D), R34.2
unnamed: Q12.1 (G), R36.2
unnamed: R1.1, R52.2
unnamed: R4.1, R53.2
unnamed: R10.1, R55.2
unnamed: R13.1, R56.2
unnamed: R16.1, R57.2
unnamed: R19.1, R58.2
unnamed: R22.1, R59.2
unnamed: R25.1, R60.2
unnamed: R28.1, R61.2
unnamed: R31.1, R62.2
unnamed: R34.1, R63.2
unnamed: R7.1, R54.2
unnamed: R45.1, U1.36 (DTEN)
unnamed: R42.1, U1.45 (IBIAS)
unnamed: R42.2, R46.1, U1.46 (ICMP)
unnamed: R43.1, U1.40 (ISOMD)
unnamed: C17.1, R39.2, U1.1 (V+)
unnamed: C16.1, U1.35 (Vref1)
unnamed: R44.1, U1.39 (WDT)
