tetra-aero/LTC6811_ESP32/LTC6811_ESP32_V1p4/LTC6811_ESP32_V1p4.kicad_pcb

## KiCad design LTC6811_ESP32_V1p4/LTC6811_ESP32_V1p4.kicad_pcb (2024-06-12)

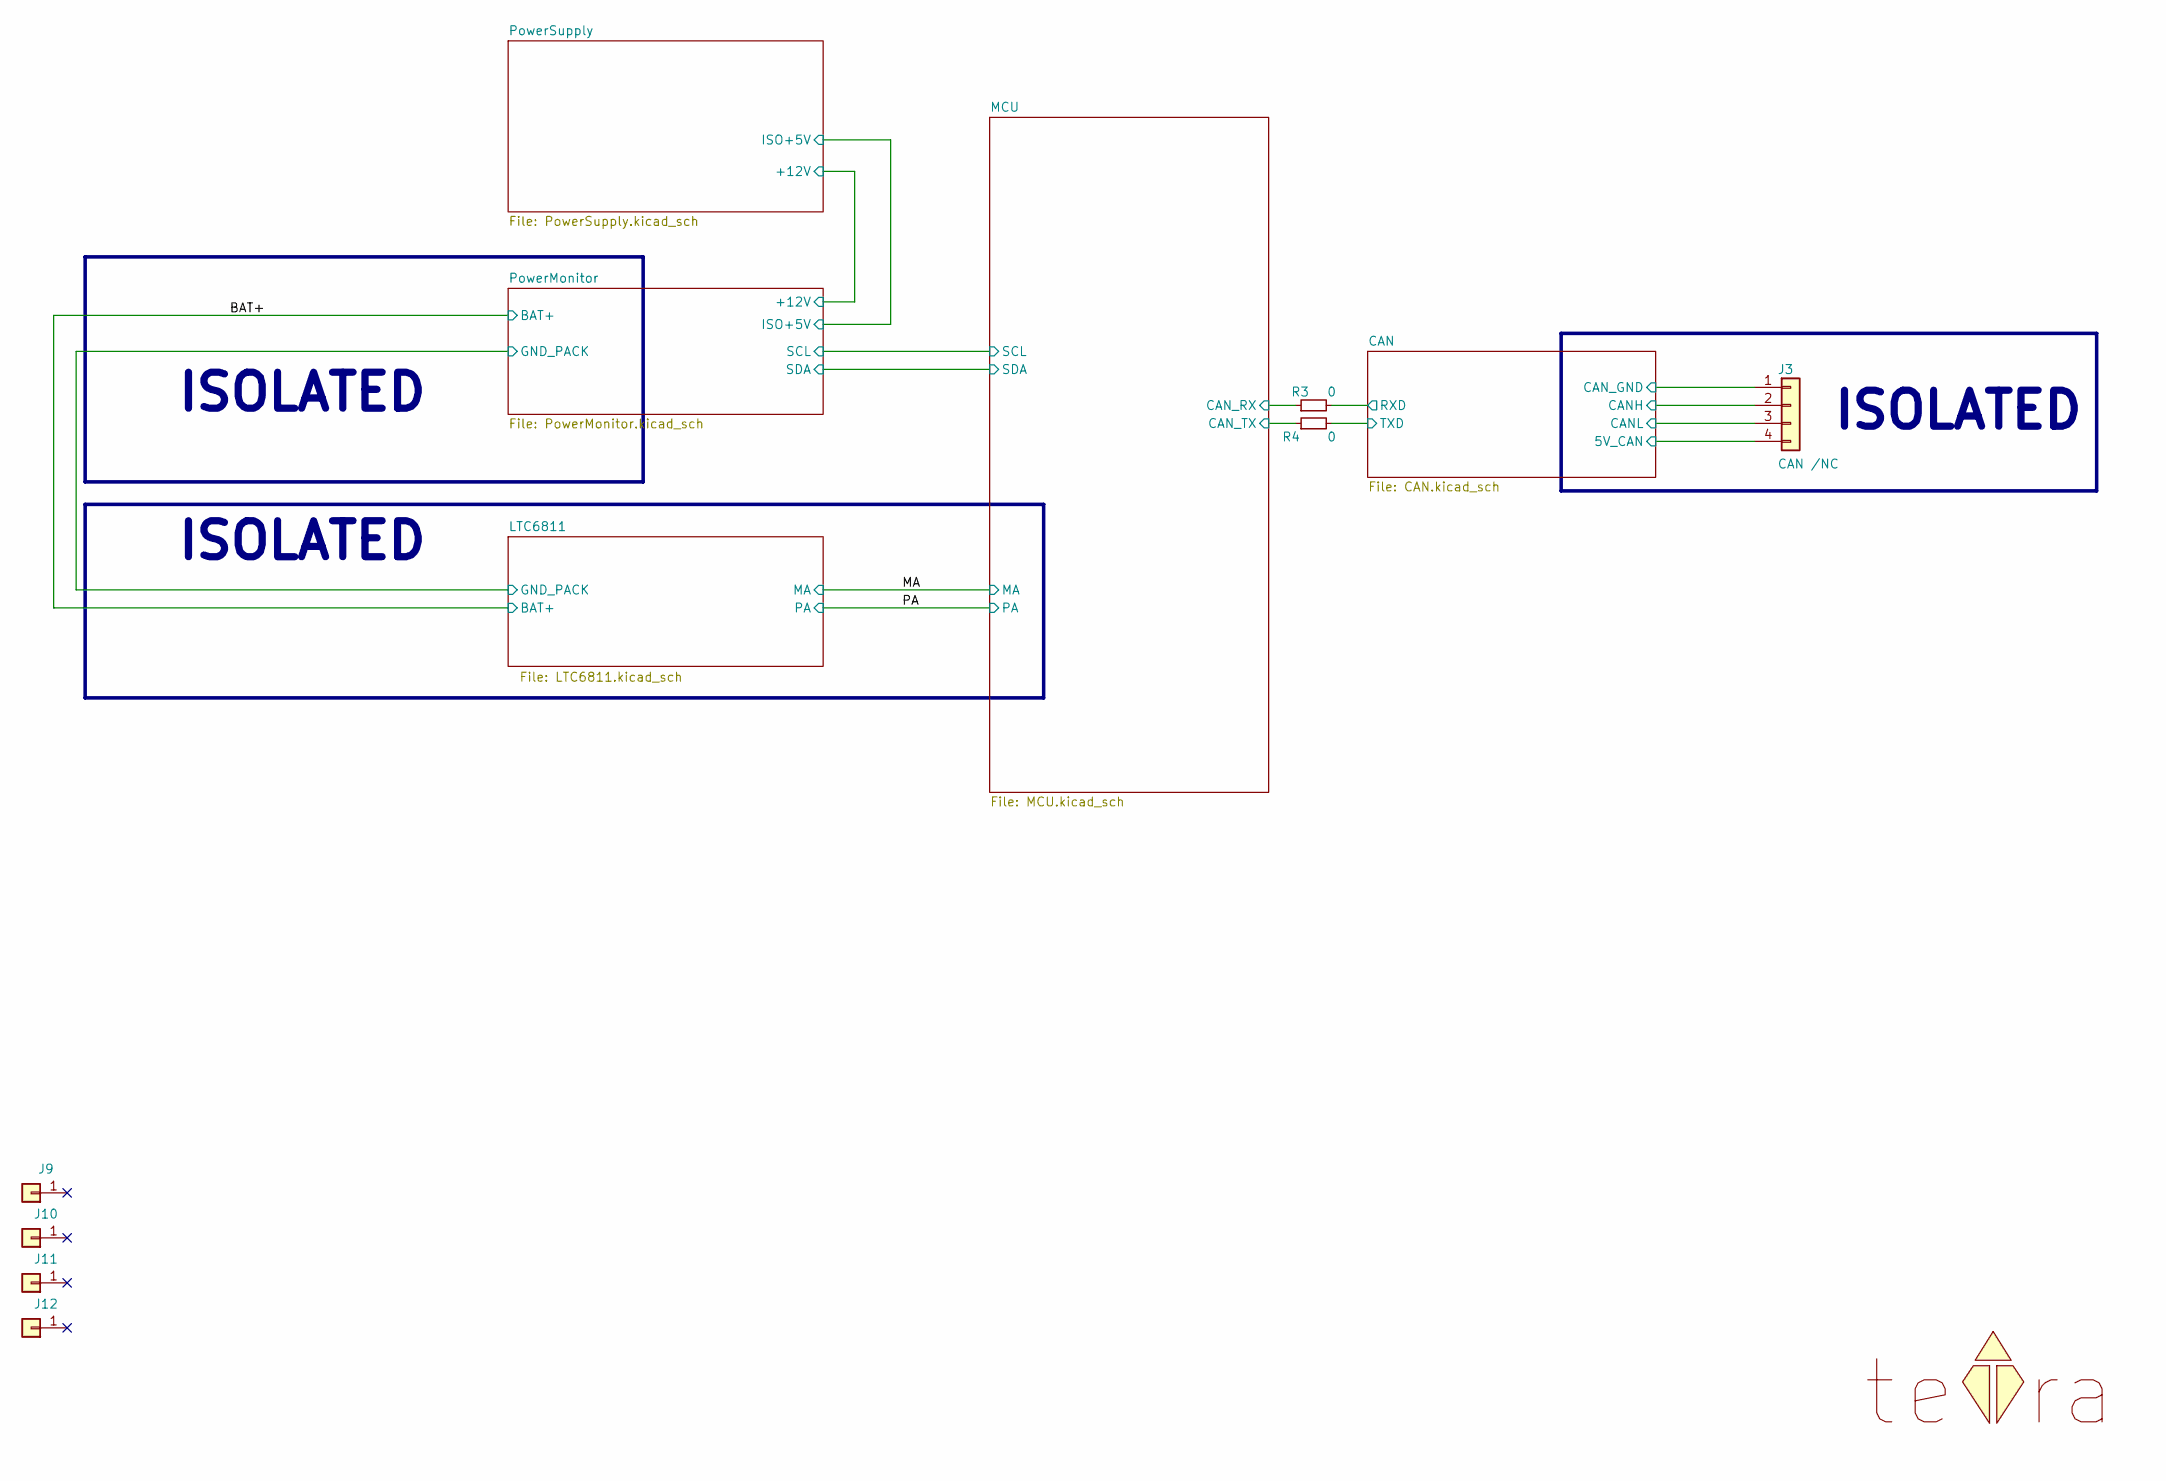
[picture p52: schematic LTC6811_ESP32_V1p4.kicad_sch, BMS-Master]

Parts:
J3: CAN /NC; PinHeader_1x04_P2.54mm_Vertical; MPN G800W304018EU
J9, J10, J11, J12: Hole /NC; MountingHole_3.2mm_M3_ISO7380_Pad; MPN N/A
LOGO1: teTra /NC; teTra-LOGO
R3, R4: 0; R_0603_1608Metric; MPN RC0603JR-070RL

Connections:
/CAN/5V_CAN: J3.4; also elsewhere on the board
/CAN/CANH: J3.2; also elsewhere on the board
/CAN/CANL: J3.3; also elsewhere on the board
/CAN/CAN_GND: J3.1; also elsewhere on the board
/CAN/RXD: R3.2; also elsewhere on the board
/CAN/TXD: R4.2; also elsewhere on the board
/CAN_RX: R3.1
/CAN_TX: R4.1

Notes on the sheet:
ISOLATED

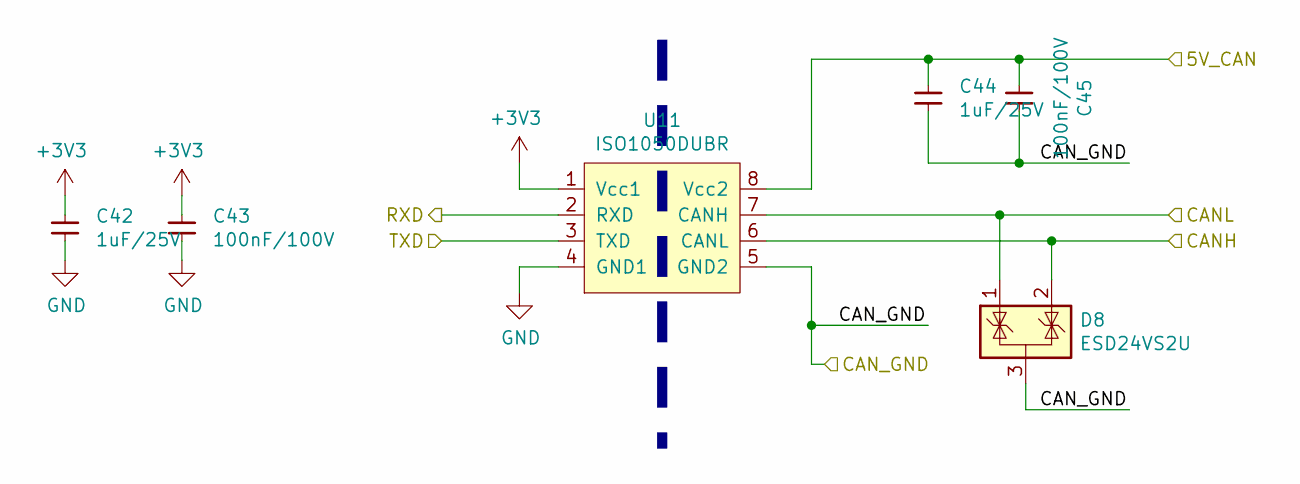
[picture p53: schematic CAN.kicad_sch]

Parts:
C42, C44: 1uF/25V; C_0603_1608Metric; MPN 0603B105K250XD
C43, C45: 100nF/100V; C_0603_1608Metric; MPN CL10B104KC8NNNC
D8: ESD24VS2U; SOT-23; MPN ESD24VS2UE6327HTSA1
U11: ISO1050DUBR; SOP-8_6.62x9.15mm_P2.54mm; MPN ISO1050DUBR

Connections:
/CAN/5V_CAN: C44.1, C45.2, U11.8 (Vcc2); also elsewhere on the board
/CAN/CANH: D8.2 (K), U11.6 (CANL); also elsewhere on the board
/CAN/CANL: D8.1 (K), U11.7 (CANH); also elsewhere on the board
/CAN/CAN_GND: C44.2, C45.1, D8.3 (A), U11.5 (GND2); also elsewhere on the board
/CAN/RXD: U11.2 (RXD); also elsewhere on the board
/CAN/TXD: U11.3 (TXD); also elsewhere on the board

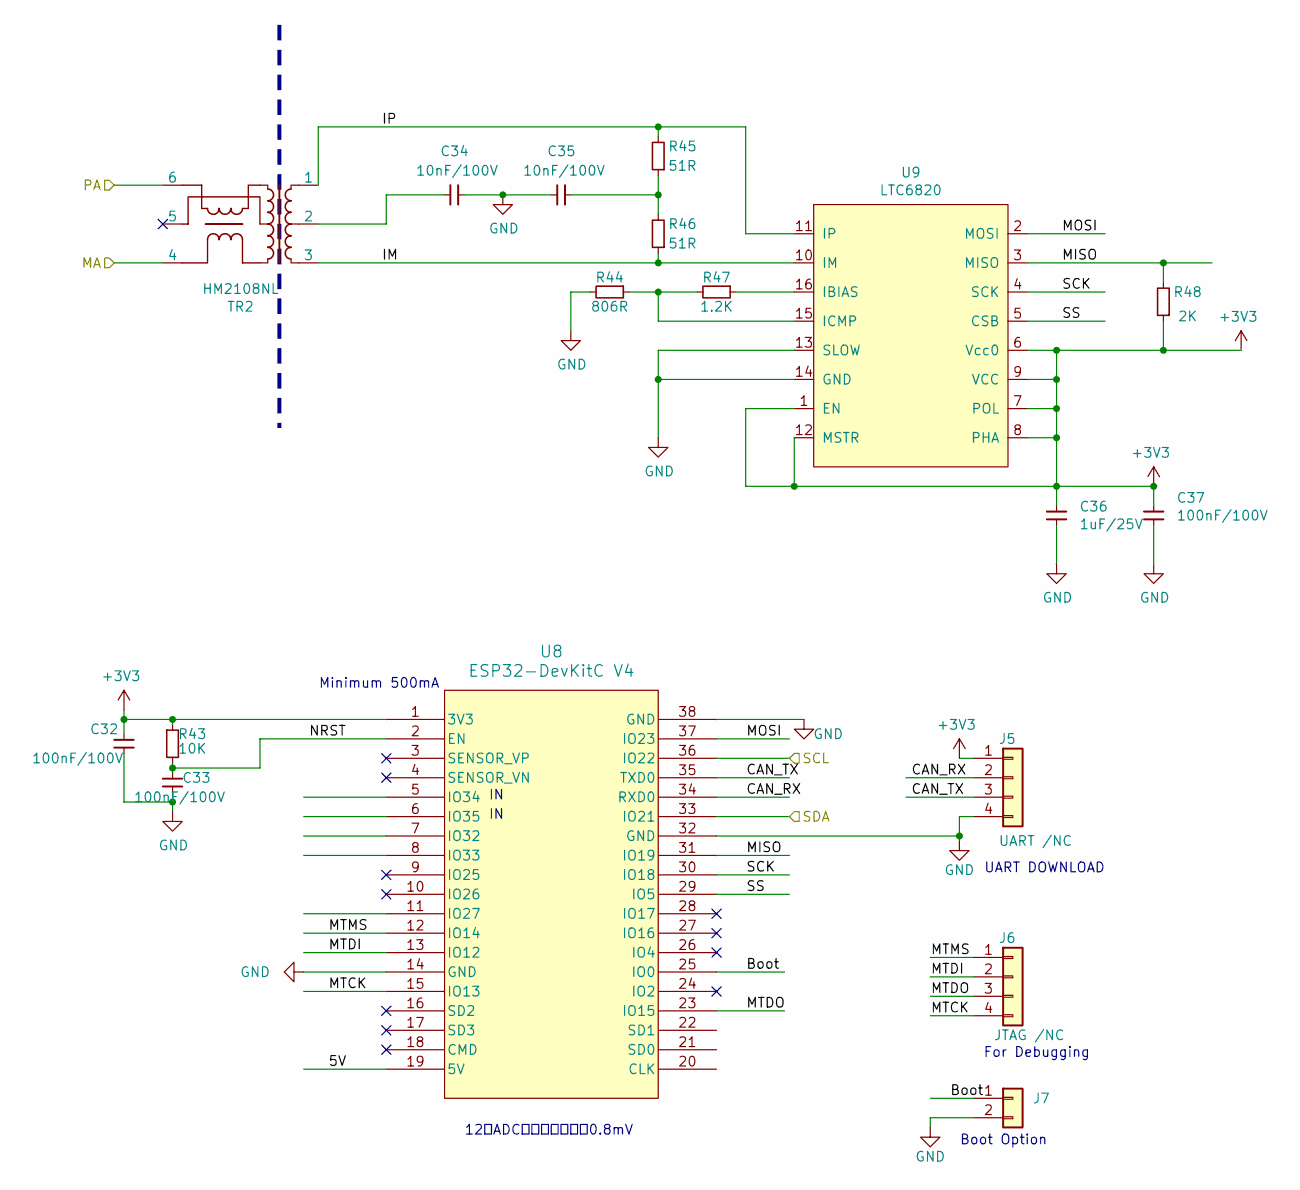
[picture p54: schematic MCU.kicad_sch]

Parts:
C32, C33, C37: 100nF/100V; C_0603_1608Metric; MPN CL10B104KC8NNNC
C34, C35: 10nF/100V; C_0603_1608Metric; MPN GCM188R72A103KA37D
C36: 1uF/25V; C_0603_1608Metric; MPN 0603B105K250XD
J5: UART /NC; PinHeader_1x04_P2.54mm_Vertical; MPN G800W304018EU
J6: JTAG /NC; PinHeader_1x04_P2.54mm_Vertical; MPN G800W304018EU
J7: Boot Option /NC; PinHeader_1x02_P2.54mm_Vertical; MPN G800W306018EU
R43: 10K; R_0603_1608Metric; MPN RMCF0603FT10K0
R44: 806R; R_0603_1608Metric; MPN RC0603FR-07806RL
R45, R46: 51R; R_0603_1608Metric; MPN RC0603JR-0751RL
R47: 1.2K; R_0603_1608Metric; MPN RC0603JR-071K2L
R48: 2K; R_0603_1608Metric; MPN RC0603FR-072KL
TR2: HM2108NL; MPN HM2108NL
U8: ESP32-DevKitC V4; ESP32-DevKitc V4_DIP-38_27.9mm×48.2mm; MPN ESP32-DEVKITC-32E
U9: LTC6820; MSOP-16_3x4mm_P0.5mm; MPN LTC6820IMS#PBF

Connections:
/MA: TR2.4; also elsewhere on the board
/MCU/5V: U8.19 (5V)
/MCU/Boot: J7.1, U8.25 (IO0)
/MCU/CAN_RX: J5.2, U8.34 (RXD0)
/MCU/CAN_TX: J5.3, U8.35 (TXD0)
/MCU/IM: R46.1, TR2.3, U9.10 (IM)
/MCU/IP: R45.2, TR2.1, U9.11 (IP)
/MCU/MISO: R48.2, U8.31 (IO19), U9.3 (MISO)
/MCU/MOSI: U8.37 (IO23), U9.2 (MOSI)
/MCU/MTCK: J6.4, U8.15 (IO13)
/MCU/MTDI: J6.2, U8.13 (IO12)
/MCU/MTDO: J6.3, U8.23 (IO15)
/MCU/MTMS: J6.1, U8.12 (IO14)
/MCU/NRST: C33.2, R43.2, U8.2 (EN)
/MCU/SCK: U8.30 (IO18), U9.4 (SCK)
/MCU/SCL: U8.36 (IO22); also elsewhere on the board
/MCU/SDA: U8.33 (IO21); also elsewhere on the board
/MCU/SS: U8.29 (IO5), U9.5 (CSB)
/PA: TR2.6; also elsewhere on the board
unnamed: C34.1, TR2.2
unnamed: C35.2, R45.1, R46.2
unnamed: R47.1, U9.16 (IBIAS)
unnamed: R44.1, R47.2, U9.15 (ICMP)

Notes on the sheet:
12位ADC最小测量电压为0.8mV
Boot Option
UART DOWNLOAD
Minimum 500mA
For Debugging

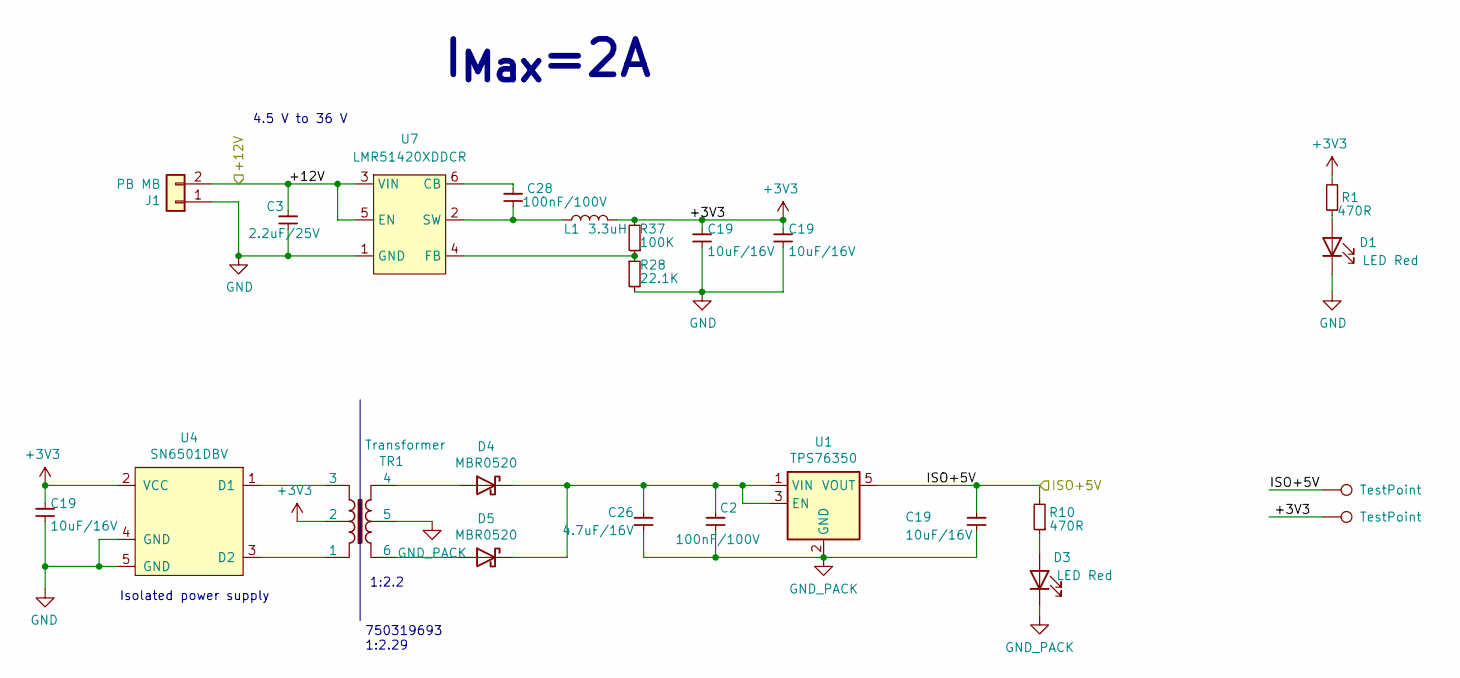
[picture p55: schematic PowerSupply.kicad_sch]

Parts:
C2, C28: 100nF/100V; C_0603_1608Metric; MPN CL10B104KC8NNNC
C3: 2.2uF/25V; C_0603_1608Metric; MPN GRM188R61E225KA12D
C19: 10uF/16V; C_0805_2012Metric; MPN CL21A106KOQNNNE
C26: 4.7uF/16V; C_0603_1608Metric; MPN CL10A475KO8NNNC
D1, D3: LED Red; LED_0603_1608Metric; MPN LTST-C190KRKT
D4, D5: MBR0520; D_SOD-123; MPN MBR0520-TP
J1: PB MB; JST_VH_B2P-VH-B_1x02_P3.96mm_Vertical; MPN B2P-VH
L1: 3.3uH; L_Bourns_SRP5030T; MPN SRP5030CC-3R3M
R1, R10: 470R; R_0603_1608Metric; MPN RC0603JR-07470RL
R28: 22.1K; R_0603_1608Metric; MPN RMCF0603FT22K1
R37: 100K; R_0603_1608Metric; MPN RC0603JR-07100KL
TP1, TP2: TestPoint; TestPoint_Pad_D1.0mm
TR1: Transformer; WURTH-760390015; MPN 760390015
U1: TPS76350; SOT-23-5; MPN TPS76350DBVR
U4: SN6501DBV; SOT-23-5; MPN SN6501DBVR
U7: LMR51420XDDCR; SOT-23-6_Handsoldering; MPN LMR51420XDDCR

Connections:
+12V: C3.1, J1.2, U7.3 (VIN), U7.5 (EN); also elsewhere on the board
unnamed: D1.2 (A), R1.1
unnamed: D3.2 (A), R10.1
unnamed: D4.2 (A), TR1.4
unnamed: C2.1, C26.1, D4.1 (K), D5.1 (K), U1.1 (VIN), U1.3 (EN)
unnamed: D5.2 (A), TR1.6
unnamed: TR1.3, U4.1 (D1)
unnamed: TR1.1, U4.3 (D2)
unnamed: C28.2, U7.6 (CB)
unnamed: C28.1, L1.1, U7.2 (SW)

Parts of its further copies:
C1, C10, C13, C24: 10uF/16V; C_0805_2012Metric; MPN CL21A106KOQNNNE
R38: 22.1K; R_0603_1608Metric; MPN RMCF0603FT22K1

Notes on the sheet:
1:2.2
I_{Max}=2A
Isolated power supply
750319693 1:2.29
4.5 V to 36 V

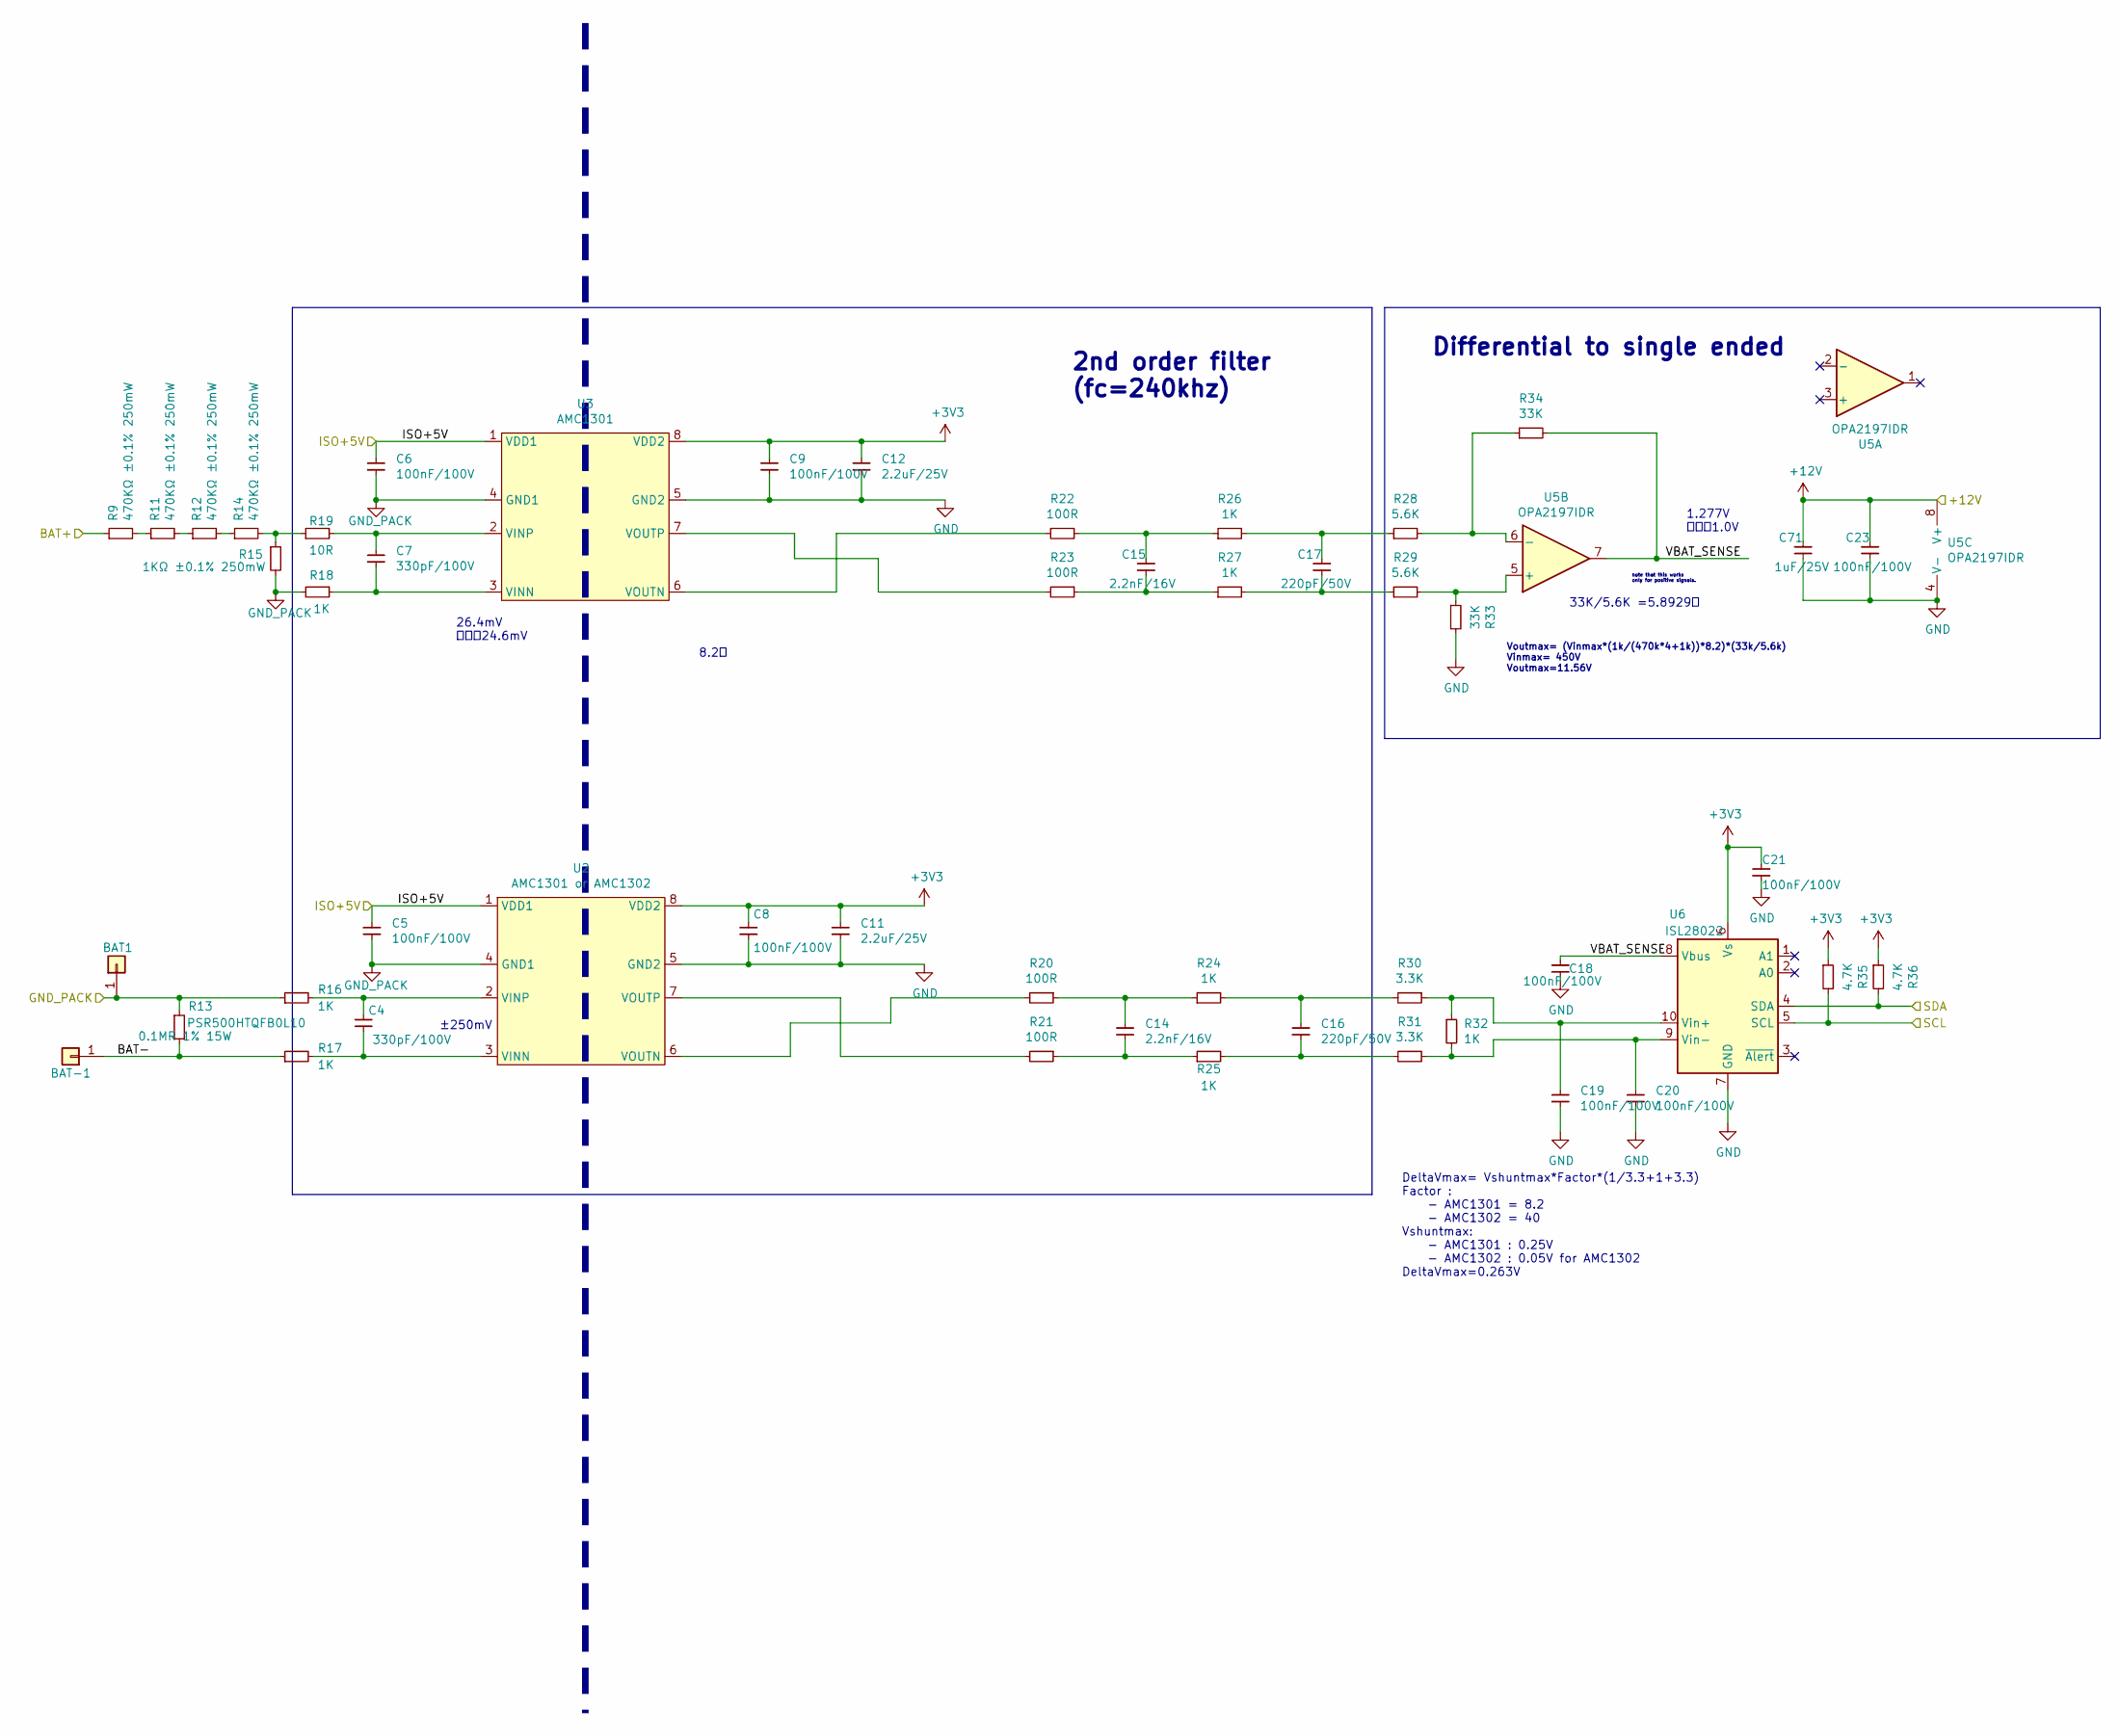
[picture p56: schematic PowerMonitor.kicad_sch]

Parts:
BAT1: BAT-; Battery_6mm×10mm_Cell_half_2
BAT-1: BAT-; Battery_6mm×10mm_Cell_half_2
C4, C7: 330pF/100V; C_0603_1608Metric; MPN GRM188R72A331KA01D
C5, C6, C8, C9, C18, C19, C20, C21, C23: 100nF/100V; C_0603_1608Metric; MPN CL10B104KC8NNNC
C11, C12: 2.2uF/25V; C_0603_1608Metric; MPN GRM188R61E225KA12D
C14, C15: 2.2nF/16V; C_0603_1608Metric; MPN C0603C222K4RECAUTO
C16, C17: 220pF/50V; C_0603_1608Metric; MPN GCM1885C1H221JA16D
C71: 1uF/25V; C_0603_1608Metric; MPN 0603B105K250XD
R9, R11, R12, R14: 470KΩ ±0.1% 250mW; R_0805_2012Metric; MPN ERJ-PB6B4703V
R13: 0.1MR 1% 15W; R_PSR500HTQFB0L10_Metric_Pad5.2x8.75mm_HandSolder; MPN PSR500HTQFB0L10
R15: 1KΩ ±0.1% 250mW; R_0805_2012Metric; MPN ERJ-PB6B1001V
R16, R17, R18, R24, R25, R26, R27, R32: 1K; R_0603_1608Metric; MPN CRCW06031K00FKEA
R19: 10R; R_0603_1608Metric; MPN RC0603JR-0710RL
R20, R21, R22, R23: 100R; R_0603_1608Metric; MPN RC0603FR-07100RL
R28, R29: 5.6K; R_0603_1608Metric; MPN RC0603JR-075K6L
R30, R31: 3.3K; R_0603_1608Metric; MPN RC0603FR-073K3L
R33, R34: 33K; R_0603_1608Metric; MPN RC0603FR-0733KL
R35, R36: 4.7K; R_0603_1608Metric; MPN RC0603JR-074K7L
U2: AMC1301 or AMC1302; SSO-8_6.8x5.9mm_P1.27mm_Clearance8mm; MPN AMC1301DWV
U3: AMC1301; SSO-8_6.8x5.9mm_P1.27mm_Clearance8mm; MPN AMC1301DWV
U5: OPA2197IDR; SOIC-8_3.9x4.9mm_Pitch1.27mm; MPN OPA2197IDR
U6: ISL28022; MSOP-10_3x3mm_P0.5mm; MPN ISL28022FUZ-T7A

Connections:
+12V: C23.1, C71.2, U5.8 (V+); also elsewhere on the board
/BAT+: R9.1; also elsewhere on the board
/MCU/SCL: R35.2, U6.5 (SCL); also elsewhere on the board
/MCU/SDA: R36.2, U6.4 (SDA); also elsewhere on the board
/PowerMonitor/BAT-: BAT-1.1, R13.2, R17.1
/PowerMonitor/VBAT_SENSE: C18.2, R34.2, U5.7, U6.8 (Vbus)
unnamed: C14.1, R20.1, R24.1
unnamed: C14.2, R21.1, R25.1
unnamed: C15.1, R22.1, R26.1
unnamed: C15.2, R23.1, R27.1
unnamed: C16.1, R24.2, R30.2
unnamed: C16.2, R25.2, R31.2
unnamed: C17.2, R27.2, R29.1
unnamed: R9.2, R11.1
unnamed: R11.2, R12.1
unnamed: R12.2, R14.1
unnamed: R14.2, R15.1, R19.1
unnamed: C4.2, R17.2, U2.3 (VINN)
unnamed: C4.1, R16.2, U2.2 (VINP)
unnamed: R20.2, U2.6 (VOUTN)
unnamed: R21.2, U2.7 (VOUTP)
unnamed: C7.2, R18.1, U3.3 (VINN)
unnamed: C7.1, R19.2, U3.2 (VINP)
unnamed: R22.2, U3.6 (VOUTN)
unnamed: R23.2, U3.7 (VOUTP)
unnamed: R29.2, R33.1, U5.5 (+)
unnamed: C20.2, R31.1, R32.2, U6.9 (Vin-)

Notes on the sheet:
DeltaVmax= Vshuntmax*Factor*(1/3.3+1+3.3) Factor : - AMC1301 = 8.2 - AMC1302 = 40 Vshuntmax: - AMC1301 : 0.25V - AMC1302 : 0.05V for AMC1302 DeltaVmax=0.263V
note that this works only for positive signals.
2nd order filter (fc=240khz)
±250mV
33K/5.6K =5.8929倍
Voutmax= (Vinmax*(1k/(470k*4+1k))*8.2)*(33k/5.6k) Vinmax= 450V Voutmax=11.56V
8.2倍
26.4mV 实际值24.6mV
1.277V 实际值1.0V
Differential to single ended
