tetra-aero/LTC6811_ESP32/LTC6811_ESP32_V1p4/LTC6811_ESP32_V1p4.kicad_pcb

## KiCad design LTC6811_ESP32_V1p4/LTC6811_ESP32_V1p4.kicad_pcb (continued)

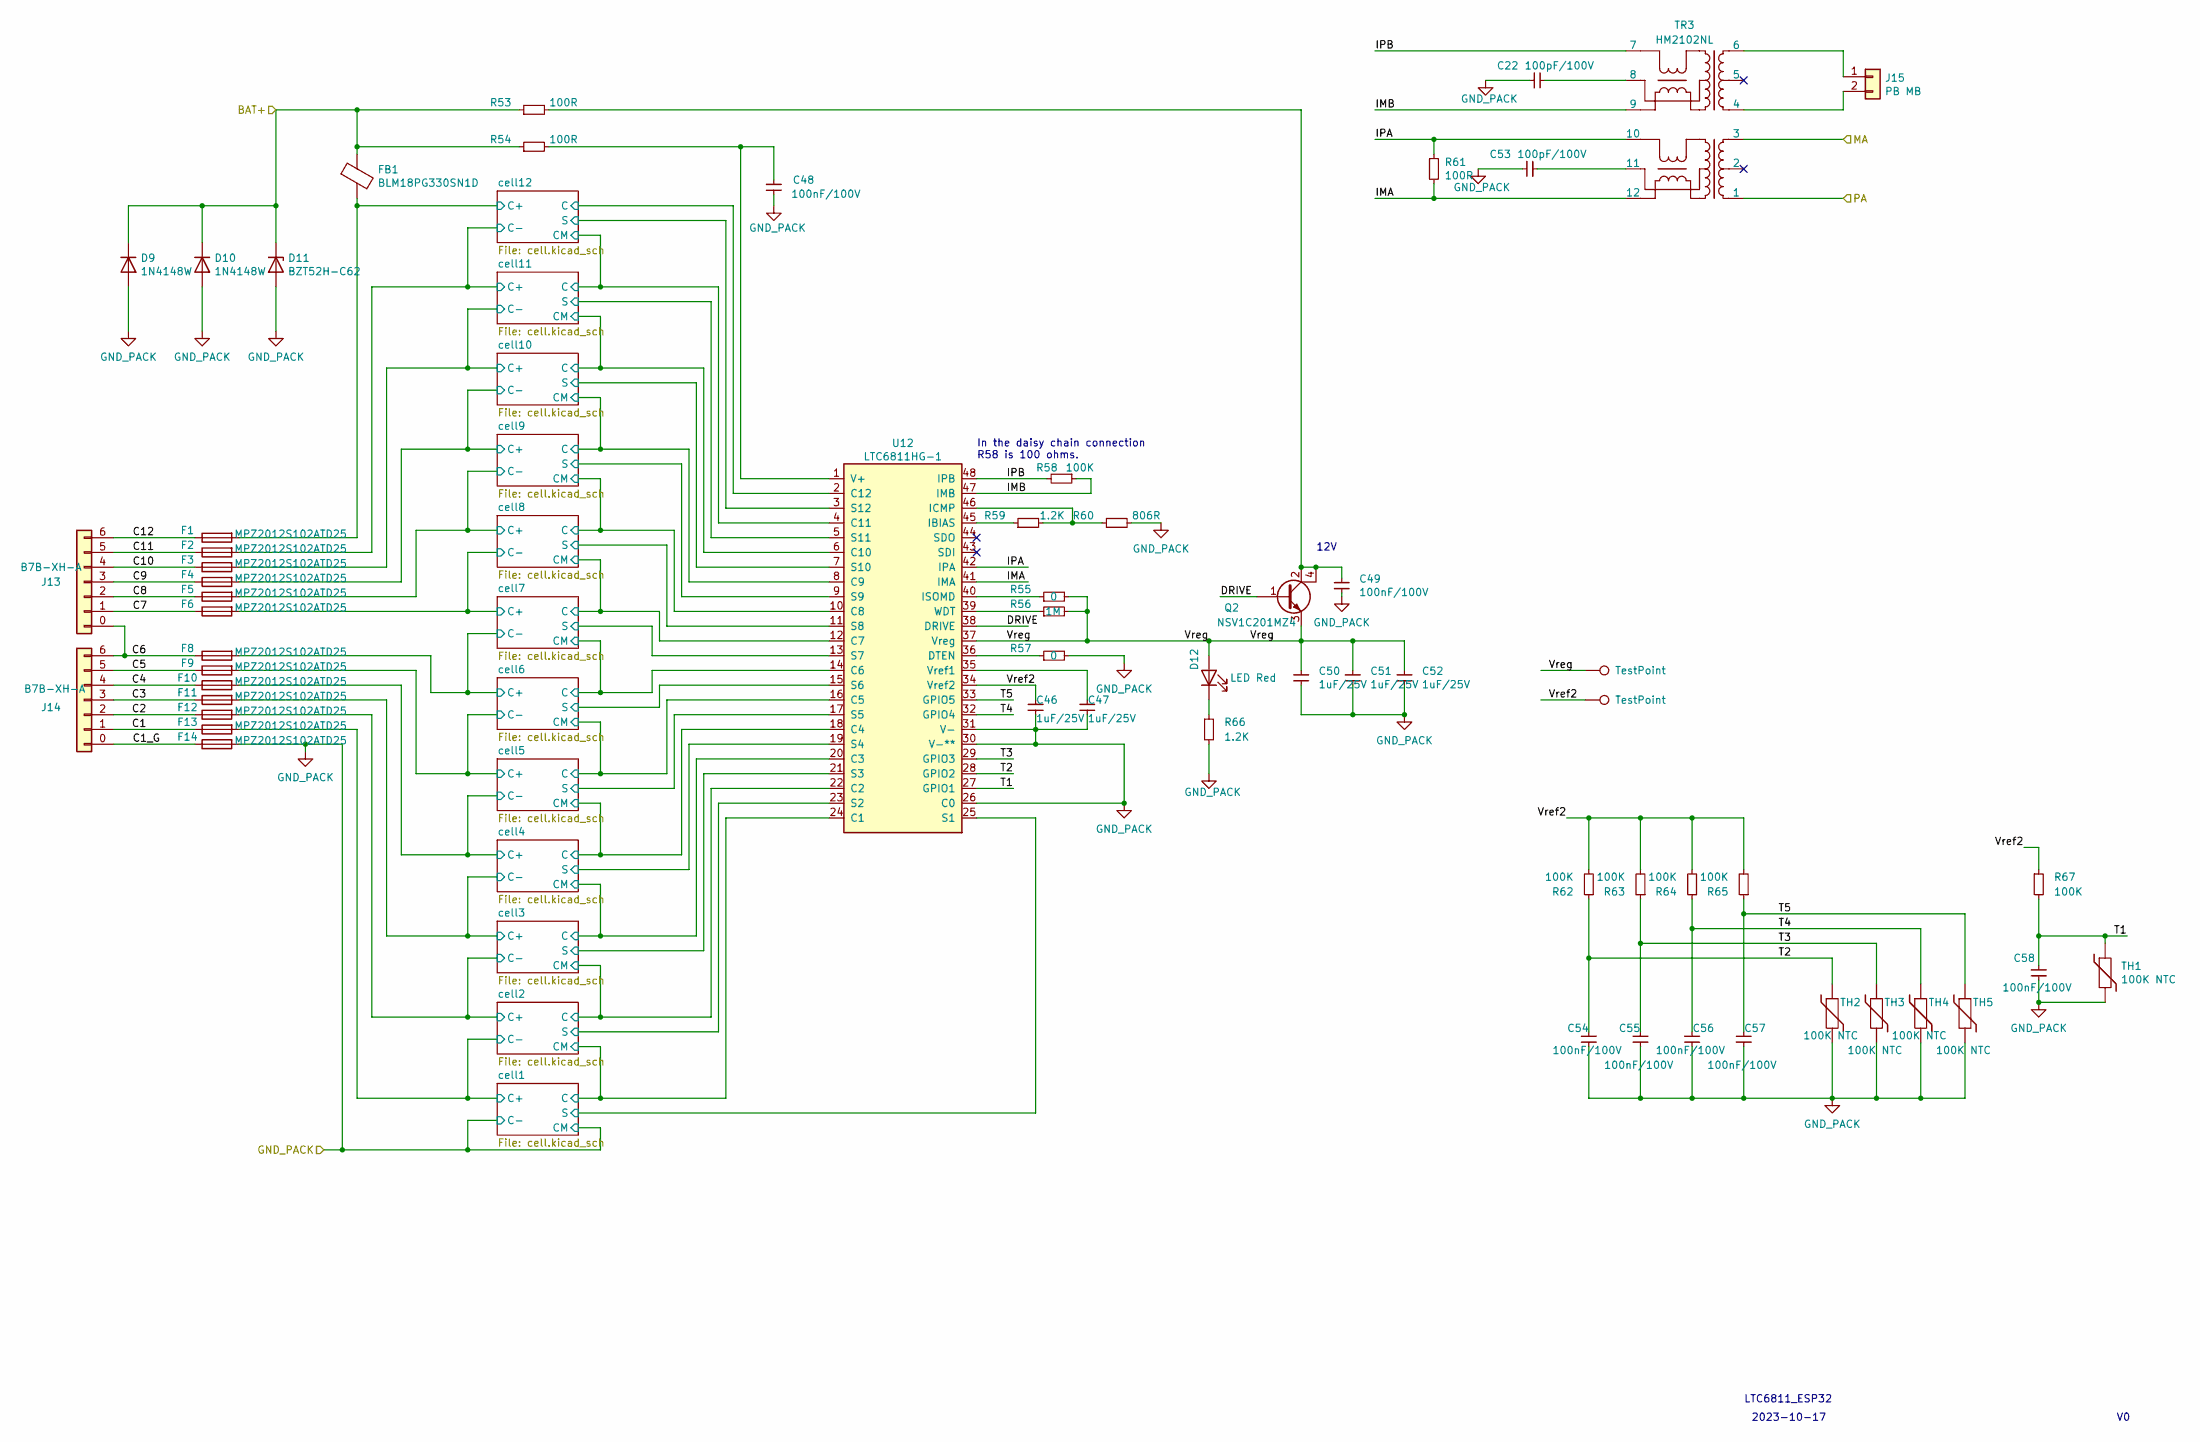
[picture p57: schematic LTC6811.kicad_sch]

Parts:
C22, C53: 100pF/100V; C_0603_1608Metric; MPN 0603B101K101SD
C46, C47, C50, C51, C52: 1uF/25V; C_0603_1608Metric; MPN 0603B105K250XD
C48, C49, C54, C55, C56, C57, C58: 100nF/100V; C_0603_1608Metric; MPN CL10B104KC8NNNC
D9, D10: 1N4148W; D_SOD-123; MPN 1N4148W-7-F
D11: BZT52H-C62; D_SOD-123F; MPN BZT52H-C62,115
D12: LED Red; LED_0603_1608Metric; MPN LTST-C190KRKT
F1, F2, F3, F4, F5, F6, F8, F9, F10, F11, F12, F13, F14: MPZ2012S102ATD25; Fuse_0805_2012Metric; MPN MPZ2012S102ATD25
FB1: BLM18PG330SN1D; R_0603_1608Metric; MPN BLM18PG330SN1D
J13, J14: B7B-XH-A; JST_XH_B7B-XH-A_1x07_P2.50mm_Vertical_BAT_6S; MPN B7B-XH-A
J15: PB MB; JST_VH_B2P-VH-B_1x02_P3.96mm_Vertical; MPN B2P-VH
Q2: NSV1C201MZ4; SOT-223; MPN NSV1C201MZ4T1G
R53, R54, R61: 100R; R_0603_1608Metric; MPN RC0603FR-07100RL
R55, R57: 0; R_0603_1608Metric; MPN RC0603JR-070RL
R56: 1M; R_0603_1608Metric; MPN RC0603JR-071ML
R58, R62, R63, R64, R65, R67: 100K; R_0603_1608Metric; MPN RC0603JR-07100KL
R59, R66: 1.2K; R_0603_1608Metric; MPN RC0603JR-071K2L
R60: 806R; R_0603_1608Metric; MPN RC0603FR-07806RL
TH1: 100K NTC; R_0603_1608Metric; MPN B57355V5104F360
TH2, TH3, TH4, TH5: 100K NTC; R_Axial_DIN0204_L3.6mm_D1.6mm_P1.90mm_Vertical; MPN MF52C1104F4150
TP3, TP4: TestPoint; TestPoint_Pad_D1.0mm
TR3: HM2102NL; HM2102NL_PUL; MPN HM2102NL
U12: LTC6811HG-1; TSSOP-48_6.1x12.5mm_P0.5mm; MPN LTC6811HG-1#3ZZPBF

Connections:
/BAT+: D9.1 (K), D10.1 (K), D11.1 (K), FB1.1, R53.1, R54.1; also elsewhere on the board
/LTC6811/C1: F13.1, J14.1 (Pin_2)
/LTC6811/C1_G: F14.1, J14.0 (Pin_1)
/LTC6811/C2: F12.1, J14.2 (Pin_3)
/LTC6811/C3: F11.1, J14.3 (Pin_4)
/LTC6811/C4: F10.1, J14.4 (Pin_5)
/LTC6811/C5: F9.1, J14.5 (Pin_6)
/LTC6811/C6: F8.1, J13.0 (Pin_1), J14.6 (Pin_7)
/LTC6811/C7: F6.1, J13.1 (Pin_2)
/LTC6811/C8: F5.1, J13.2 (Pin_3)
/LTC6811/C9: F4.1, J13.3 (Pin_4)
/LTC6811/C10: F3.1, J13.4 (Pin_5)
/LTC6811/C11: F2.1, J13.5 (Pin_6)
/LTC6811/C12: F1.1, J13.6 (Pin_7)
/LTC6811/DRIVE: Q2.1 (B), U12.38 (DRIVE)
/LTC6811/IMA: R61.2, TR3.12, U12.41 (IMA)
/LTC6811/IMB: R58.1, TR3.9, U12.47 (IMB)
/LTC6811/IPA: R61.1, TR3.10, U12.42 (IPA)
/LTC6811/IPB: R58.2, TR3.7, U12.48 (IPB)
/LTC6811/T1: C58.1, R67.2, TH1.1, U12.27 (GPIO1)
/LTC6811/T2: C54.1, R62.1, TH2.1, U12.28 (GPIO2)
/LTC6811/T3: C55.1, R63.1, TH3.1, U12.29 (GPIO3)
/LTC6811/T4: C56.1, R64.1, TH4.1, U12.32 (GPIO4)
/LTC6811/T5: C57.1, R65.1, TH5.1, U12.33 (GPIO5)
/LTC6811/Vref2: C46.1, R62.2, R63.2, R64.2, R65.2, R67.1, TP4.1, U12.34 (Vref2)
/LTC6811/Vreg: C50.1, C51.1, C52.1, D12.2 (A), Q2.3 (E), R55.2, R56.2, TP3.1, U12.37 (Vreg)
/LTC6811/cell1/C: U12.24 (C1); also elsewhere on the board
/LTC6811/cell1/C+: F13.2; also elsewhere on the board
/LTC6811/cell1/S: U12.25 (S1); also elsewhere on the board
/LTC6811/cell2/C: U12.22 (C2); also elsewhere on the board
/LTC6811/cell2/C+: F12.2; also elsewhere on the board
/LTC6811/cell2/S: U12.23 (S2); also elsewhere on the board
/LTC6811/cell3/C: U12.20 (C3); also elsewhere on the board
/LTC6811/cell3/C+: F11.2; also elsewhere on the board
/LTC6811/cell3/S: U12.21 (S3); also elsewhere on the board
/LTC6811/cell4/C: U12.18 (C4); also elsewhere on the board
/LTC6811/cell4/C+: F10.2; also elsewhere on the board
/LTC6811/cell4/S: U12.19 (S4); also elsewhere on the board
/LTC6811/cell5/C: U12.16 (C5); also elsewhere on the board
/LTC6811/cell5/C+: F9.2; also elsewhere on the board
/LTC6811/cell5/S: U12.17 (S5); also elsewhere on the board
/LTC6811/cell6/C: U12.14 (C6); also elsewhere on the board
/LTC6811/cell6/C+: F8.2; also elsewhere on the board
/LTC6811/cell6/S: U12.15 (S6); also elsewhere on the board
/LTC6811/cell7/C: U12.12 (C7); also elsewhere on the board
/LTC6811/cell7/C+: F6.2; also elsewhere on the board
/LTC6811/cell7/S: U12.13 (S7); also elsewhere on the board
/LTC6811/cell8/C: U12.10 (C8); also elsewhere on the board
/LTC6811/cell8/C+: F5.2; also elsewhere on the board
/LTC6811/cell8/S: U12.11 (S8); also elsewhere on the board
/LTC6811/cell9/S: U12.9 (S9); also elsewhere on the board
/LTC6811/cell10/C: U12.6 (C10); also elsewhere on the board
/LTC6811/cell10/C+: F3.2; also elsewhere on the board
/LTC6811/cell10/C-: F4.2; also elsewhere on the board
/LTC6811/cell10/CM: U12.8 (C9); also elsewhere on the board
/LTC6811/cell10/S: U12.7 (S10); also elsewhere on the board
/LTC6811/cell11/C: U12.4 (C11); also elsewhere on the board
/LTC6811/cell11/C+: F2.2; also elsewhere on the board
/LTC6811/cell11/S: U12.5 (S11); also elsewhere on the board
/LTC6811/cell12/C: U12.2 (C12); also elsewhere on the board
/LTC6811/cell12/C+: F1.2, FB1.2; also elsewhere on the board
/LTC6811/cell12/S: U12.3 (S12); also elsewhere on the board
/MA: TR3.3; also elsewhere on the board
/PA: TR3.1; also elsewhere on the board
unnamed: C22.1, TR3.8
unnamed: C49.1, Q2.2 (C), Q2.4 (C), R53.2
unnamed: C53.1, TR3.11
unnamed: D12.1 (K), R66.1
unnamed: J15.1, TR3.6
unnamed: J15.2, TR3.4
unnamed: R57.1, U12.36 (DTEN)
unnamed: R59.1, U12.45 (IBIAS)
unnamed: R59.2, R60.1, U12.46 (ICMP)
unnamed: R55.1, U12.40 (ISOMD)
unnamed: C48.1, R54.2, U12.1 (V+)
unnamed: C47.1, U12.35 (Vref1)
unnamed: R56.1, U12.39 (WDT)

Notes on the sheet:
In the daisy chain connection R58 is 100 ohms.
2023-10-17
LTC6811_ESP32
12V

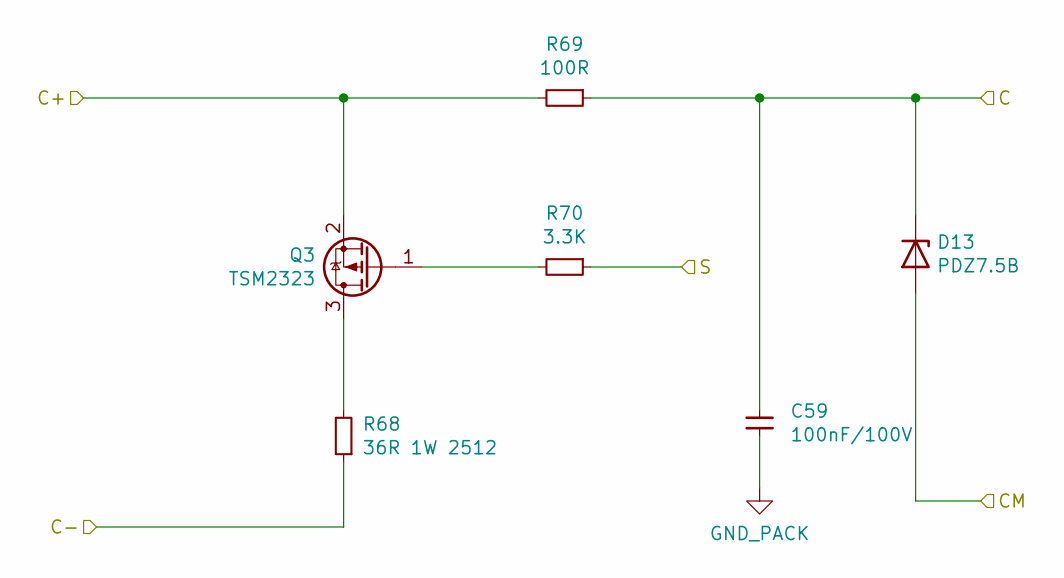
[picture p58: schematic cell.kicad_sch]

Parts:
C59: 100nF/100V; C_0603_1608Metric; MPN CL10B104KC8NNNC
D13: PDZ7.5B; D_SOD-323_HandSoldering; MPN PDZ7.5BZ
Q3: TSM2323; SOT-23; MPN TSM2323CX RFG
R68: 36R 1W 2512; R_2512_6332Metric; MPN RTT25360JTE
R69: 100R; R_0603_1608Metric; MPN RC0603FR-07100RL
R70: 3.3K; R_0603_1608Metric; MPN RC0603FR-073K3L

Connections:
/LTC6811/cell1/C: C59.1, D13.1 (K), R69.1; also elsewhere on the board
/LTC6811/cell1/C+: Q3.2 (S), R69.2; also elsewhere on the board
/LTC6811/cell1/S: R70.1; also elsewhere on the board
unnamed: Q3.3 (D), R68.2
unnamed: Q3.1 (G), R70.2

Parts of its further copies:
C60, C61, C62, C63, C64, C65, C66, C67, C68, C69, C70: 100nF/100V; C_0603_1608Metric; MPN CL10B104KC8NNNC
D14, D15, D16, D17, D18, D19, D20, D21, D22, D23, D24: PDZ7.5B; D_SOD-323_HandSoldering; MPN PDZ7.5BZ
Q4, Q5, Q6, Q7, Q8, Q9, Q10, Q11, Q12, Q13, Q14: TSM2323; SOT-23; MPN TSM2323CX RFG
R71, R74, R77, R80, R83, R86, R89, R92, R95, R98, R101: 36R 1W 2512; R_2512_6332Metric; MPN RTT25360JTE
R72, R75, R78, R81, R84, R87, R90, R93, R96, R99, R102: 100R; R_0603_1608Metric; MPN RC0603FR-07100RL
R73, R76, R79, R82, R85, R88, R91, R94, R97, R100, R103: 3.3K; R_0603_1608Metric; MPN RC0603FR-073K3L

Connections of its further copies:
/LTC6811/cell1/C: D14.2 (A); also elsewhere on the board
/LTC6811/cell1/C+: R71.1; also elsewhere on the board
/LTC6811/cell2/C: C60.1, D14.1 (K), D15.2 (A), R72.1; also elsewhere on the board
/LTC6811/cell2/C+: Q4.2 (S), R72.2, R74.1; also elsewhere on the board
/LTC6811/cell2/S: R73.1; also elsewhere on the board
/LTC6811/cell3/C: C61.1, D15.1 (K), D16.2 (A), R75.1; also elsewhere on the board
/LTC6811/cell3/C+: Q5.2 (S), R75.2, R77.1; also elsewhere on the board
/LTC6811/cell3/S: R76.1; also elsewhere on the board
/LTC6811/cell4/C: C62.1, D16.1 (K), D17.2 (A), R78.1; also elsewhere on the board
/LTC6811/cell4/C+: Q6.2 (S), R78.2, R80.1; also elsewhere on the board
/LTC6811/cell4/S: R79.1; also elsewhere on the board
/LTC6811/cell5/C: C63.1, D17.1 (K), D18.2 (A), R81.1; also elsewhere on the board
/LTC6811/cell5/C+: Q7.2 (S), R81.2, R83.1; also elsewhere on the board
/LTC6811/cell5/S: R82.1; also elsewhere on the board
/LTC6811/cell6/C: C64.1, D18.1 (K), D19.2 (A), R84.1; also elsewhere on the board
/LTC6811/cell6/C+: Q8.2 (S), R84.2, R86.1; also elsewhere on the board
/LTC6811/cell6/S: R85.1; also elsewhere on the board
/LTC6811/cell7/C: C65.1, D19.1 (K), D20.2 (A), R87.1; also elsewhere on the board
/LTC6811/cell7/C+: Q9.2 (S), R87.2, R89.1; also elsewhere on the board
/LTC6811/cell7/S: R88.1; also elsewhere on the board
/LTC6811/cell8/C: C66.1, D20.1 (K), D21.2 (A), R90.1; also elsewhere on the board
/LTC6811/cell8/C+: Q10.2 (S), R90.2, R92.1; also elsewhere on the board
/LTC6811/cell8/S: R91.1; also elsewhere on the board
/LTC6811/cell9/S: R94.1; also elsewhere on the board
/LTC6811/cell10/C: C68.1, D22.1 (K), D23.2 (A), R96.1; also elsewhere on the board
/LTC6811/cell10/C+: Q12.2 (S), R96.2, R98.1; also elsewhere on the board
/LTC6811/cell10/C-: Q11.2 (S), R93.2, R95.1; also elsewhere on the board
/LTC6811/cell10/CM: C67.1, D21.1 (K), D22.2 (A), R93.1; also elsewhere on the board
/LTC6811/cell10/S: R97.1; also elsewhere on the board
/LTC6811/cell11/C: C69.1, D23.1 (K), D24.2 (A), R99.1; also elsewhere on the board
/LTC6811/cell11/C+: Q13.2 (S), R99.2, R101.1; also elsewhere on the board
/LTC6811/cell11/S: R100.1; also elsewhere on the board
/LTC6811/cell12/C: C70.1, D24.1 (K), R102.1; also elsewhere on the board
/LTC6811/cell12/C+: Q14.2 (S), R102.2; also elsewhere on the board
/LTC6811/cell12/S: R103.1; also elsewhere on the board
unnamed: Q4.3 (D), R71.2
unnamed: Q4.1 (G), R73.2
unnamed: Q5.3 (D), R74.2
unnamed: Q5.1 (G), R76.2
unnamed: Q6.3 (D), R77.2
unnamed: Q6.1 (G), R79.2
unnamed: Q7.3 (D), R80.2
unnamed: Q7.1 (G), R82.2
unnamed: Q8.3 (D), R83.2
unnamed: Q8.1 (G), R85.2
unnamed: Q9.3 (D), R86.2
unnamed: Q9.1 (G), R88.2
unnamed: Q10.3 (D), R89.2
unnamed: Q10.1 (G), R91.2
unnamed: Q11.3 (D), R92.2
unnamed: Q11.1 (G), R94.2
unnamed: Q12.3 (D), R95.2
unnamed: Q12.1 (G), R97.2
unnamed: Q13.3 (D), R98.2
unnamed: Q13.1 (G), R100.2
unnamed: Q14.3 (D), R101.2
unnamed: Q14.1 (G), R103.2

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
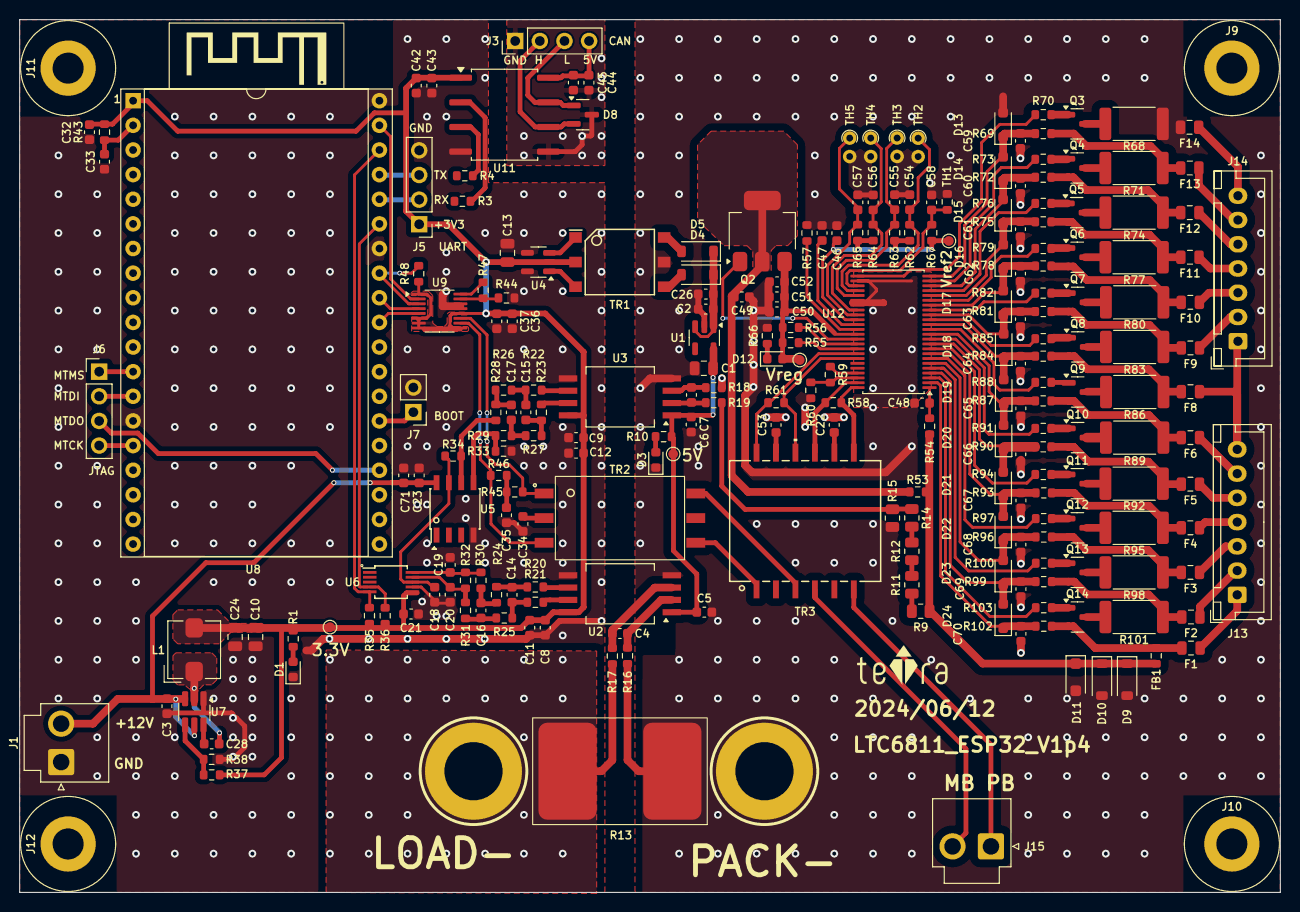
[picture p59: board LTC6811_ESP32_V1p4.kicad_pcb from above]

Board: 2 copper layers, 130.0 x 90.0 mm, 239 parts (0 on the bottom side), 168 nets.
