tetra-aero/LTC6811_ESP32/(commit log)

2023-11-14 Add daisy chain connection interface.
    [CAN.kicad_sch, LTC6811.kicad_sch, LTC6811_ESP32_BOM.xlsx, LTC6811_ESP32_V1.0.kicad_pcb, LTC6811_ESP32_V1.0.kicad_sch, MCU.kicad_sch, PowerMonitor.kicad_sch, PowerSupply.kicad_sch]
2023-11-15 checked bom
    checked bom
    [LTC6811_ESP32.kicad_pcb, LTC6811_ESP32_V1.0.kicad_pcb, LTC6811_ESP32_V1.0.kicad_sch]
2023-11-16 check pcb size
    check pcb size
    [LTC6811_ESP32.kicad_pcb]
2023-11-17 Substitute components in the bom that are out of stock.
    [LTC6811_ESP32_BOM.xlsx]
2023-11-17 Add files via upload
    I have replaced the components in the BOM purchase links that were either out of stock or temporarily available but discontinued by the manufacturer.
    [LTC6811_ESP32_BOM.xlsx]
2023-11-30 Create LTC6811_ESP32_V1
    Update component packaging for electronic parts and add master-slave board connection interfaces.
2023-11-30 Add master-slave board connection interfaces
    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
    [CAN.kicad_sch, LTC6811.kicad_sch, LTC6811_ESP32_V1.0.kicad_pcb, LTC6811_ESP32_V1.0.kicad_sch, MCU.kicad_sch, PowerMonitor.kicad_sch, PowerSupply.kicad_sch, USB.kicad_sch]
2023-11-30 Update and rename CAN.kicad_sch to LTC6811_ESP32_V0/CAN.kicad_sch
    [CAN.kicad_sch]
2023-11-30 Update and rename LTC6811.kicad_sch to LTC6811_ESP32_V0/LTC6811.kicad_sch
    [LTC6811.kicad_sch]
2023-11-30 Rename LTC6811_ESP32.kicad_prl to LTC6811_ESP32_V0 /LTC6811_ESP32.kicad_prl
2023-11-30 Rename LTC6811_ESP32.kicad_pro to LTC6811_ESP32_V0 /LTC6811_ESP32.kicad_pro
2023-11-30 Update and rename LTC6811_ESP32.kicad_sch to LTC6811_ESP32_V0 /LTC6811_ESP32.kicad_sch
    [LTC6811_ESP32.kicad_sch]
2023-11-30 Update and rename LTC6811_ESP32.kicad_sch to LTC6811_ESP32.kicad_sch
    [LTC6811_ESP32.kicad_sch]
2023-11-30 Update and rename LTC6811_ESP32_Library.kicad_sym to LTC6811_ESP32_V0/LTC6811_ESP32_Library.kicad_sym
2023-11-30 Update and rename MCU.kicad_sch to LTC6811_ESP32_V0/MCU.kicad_sch
    [MCU.kicad_sch]
2023-11-30 Update and rename PowerMonitor.kicad_sch to LTC6811_ESP32_V0/PowerMonitor.kicad_sch
    [PowerMonitor.kicad_sch]
2023-11-30 Update and rename PowerSupply.kicad_sch to LTC6811_ESP32_V0/PowerSupply.kicad_sch
    [PowerSupply.kicad_sch]
2023-11-30 Update and rename USB.kicad_sch to LTC6811_ESP32_V0/USB.kicad_sch
    [USB.kicad_sch]
2023-11-30 Update and rename cell.kicad_sch to LTC6811_ESP32_V0/cell.kicad_sch
    [cell.kicad_sch]
2023-11-30 Update and rename switches.kicad_sch to LTC6811_ESP32_V0/switches.kicad_sch
    [switches.kicad_sch]
2023-12-13 Optimize Isolated Power Supply Circuit
    [LTC6811_ESP32_V1.0.kicad_pcb]
2024-02-21 add BOM
    [CAN.kicad_sch, LTC6811.kicad_sch, LTC6811_ESP32_V1.2.kicad_pcb, LTC6811_ESP32_V1.2.kicad_sch, LTC6811_ESP32_V1.2.xlsx, MCU.kicad_sch, PowerMonitor.kicad_sch, PowerSupply.kicad_sch]
2024-02-21 Update and rename CAN.kicad_sch to CAN.kicad_sch
    [CAN.kicad_sch]
2024-02-21 Update and rename LTC6811.kicad_sch to LTC6811.kicad_sch
    [LTC6811.kicad_sch]
2024-02-21 Update and rename LTC6811_ESP32_V1.0.kicad_pcb to LTC6811_ESP32_V1.0.kicad_pcb
    [LTC6811_ESP32_V1.0.kicad_pcb]
2024-02-21 Update and rename LTC6811_ESP32_V1.0.kicad_sch to LTC6811_ESP32_V1.0.kicad_sch
    [LTC6811_ESP32_V1.0.kicad_sch]
2024-02-21 Update and rename MCU.kicad_sch to MCU.kicad_sch
    [MCU.kicad_sch]
2024-02-21 Update and rename PowerMonitor.kicad_sch to PowerMonitor.kicad_sch
    [PowerMonitor.kicad_sch]
2024-02-21 Update and rename PowerSupply.kicad_sch to PowerSupply.kicad_sch
    [PowerSupply.kicad_sch]
2024-02-21 Update and rename USB.kicad_sch to USB.kicad_sch
    [USB.kicad_sch]
2024-02-21 Update and rename LTC6811_ESP32_v1/cell.kicad_sch to LTC6811_ESP32_V1.0cell.kicad_sch
    [LTC6811_ESP32_V1.0cell.kicad_sch]
2024-02-21 Update and rename LTC6811_ESP32_V1.0cell.kicad_sch to LTC6811_ESP32_V1.0/LTC6811_ESP32_V1.0cell.kicad_sch
    [LTC6811_ESP32_V1.0cell.kicad_sch]
2024-02-24 add ignore gerber
    add ignore gerber
    [LTC6811_ESP32_V1p2.kicad_pcb]
2024-03-18 Update and rename LTC6811_ESP32_V1p3.kicad_pcb to LTC6811_ESP32_V1p3/LTC6811_ESP32_V1p3.kicad_pcb
    [LTC6811_ESP32_V1p3.kicad_pcb]
2024-03-21 Optimize signal transmission lines.
    [LTC6811.kicad_sch, LTC6811_ESP32_V1p3.kicad_pcb, LTC6811_ESP32_V1p3.kicad_sch, MCU.kicad_sch, PowerSupply.kicad_sch, USB.kicad_sch]
2024-03-29 Synchronize library files
    The default library files have been restored to KiCad-7.0.11, and DRC check has passed.
2024-03-29 V1p31 Synchronize library files
    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
    [LTC6811_ESP32_V1p31.kicad_pcb]
2024-03-29 Update and rename LTC6811_ESP32_V1p31.kicad_pcb to LTC6811_ESP32_V1p31.kicad_pcb
    [LTC6811_ESP32_V1p31.kicad_pcb]
2024-03-29 Update and rename LTC6811_ESP32_V1p31.kicad_sch to LTC6811_ESP32_V1p31.kicad_sch
    [LTC6811_ESP32_V1p31.kicad_sch]
2024-06-01 change page setting A3 for print
    change page setting A3 for print
    [LTC6811.kicad_sch, LTC6811_ESP32_V1p3.kicad_pcb, LTC6811_ESP32_V1p3.kicad_sch, LTC6811_ESP32_V1p3_BOM.xlsx, MCU.kicad_sch, PowerMonitor.kicad_sch, PowerSupply.kicad_sch, USB.kicad_sch]
2024-06-12 Replace out-of-stock components
    [ESP32_Master_V0_BOM.xlsx]
2024-06-12 kicad v8対応
    kicad v8対応
    [CAN.kicad_sch, ESP32_Master.kicad_pcb, LTC6811.kicad_sch, LTC6811_ESP32_V1p2.kicad_sch, LTC6811_ESP32_V1p3.kicad_sch, MCU.kicad_sch, PowerMonitor.kicad_sch, PowerSupply.kicad_sch]
2024-06-18 Update and rename ESP32_Master.kicad_pcb to ESP32_Master.kicad_pcb
    [ESP32_Master.kicad_pcb]
2024-06-18 update name ESP32_Master_V0
    [ESP32_Master-B_Cu.gbr, ESP32_Master-B_Mask.gbr, ESP32_Master-B_Paste.gbr, ESP32_Master-B_Silkscreen.gbr, ESP32_Master-Edge_Cuts.gbr, ESP32_Master-F_Cu.gbr, ESP32_Master-F_Mask.gbr, ESP32_Master-F_Paste.gbr]
2024-07-11 Corrected the problem of USB and CAN sharing TXRX
    [CAN.kicad_sch, ESP32_Master_V2.kicad_pcb, ESP32_Master_V2.kicad_sch, ESP32_Master_V2_BOM.xlsx, MCU.kicad_sch, PowerMonitor.kicad_sch, PowerSupply.kicad_sch, USB.kicad_sch]
2024-08-05 Add 8P DIP switch and mcp23s17
    [LTC6811.kicad_sch, LTC6811_ESP32_V2.kicad_sch, MCU.kicad_sch]
2024-08-06 Add two positioning holes.
    [LTC6811.kicad_sch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]
2024-08-06 BMS for 96 cells
    [CAN.kicad_sch, LTC6811.kicad_sch, LTC6811_2.kicad_sch, LTC6811_3.kicad_sch, LTC6811_4.kicad_sch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]
2024-08-07 Update BOM
    [CAN.kicad_sch, LTC6811.kicad_sch, LTC6811_ESP32_V3_BOM.xlsx, MCU.kicad_sch, Slaves.kicad_sch]
2024-09-12 fix page number
    fix page number
    [CAN.kicad_sch, LTC6811.kicad_sch, LTC6811_ESP32_V5_Main.kicad_sch, MCU.kicad_sch, PowerSupply.kicad_sch, Slaves.kicad_sch, cell.kicad_sch]
2024-11-01 Connect 5V and correct GND
    [LTC6811_ESP32_Master_V5P2.kicad_pcb, LTC6811_ESP32_Master_V5P2.kicad_sch]
2024-11-01 rename sub V5 step
    rename sub V5 step
    [LTC6811_ESP32_V5.step]
2025-11-14 Add 3 new relay control interface
    [CAN.kicad_sch, LTC6811.kicad_sch, LTC6811_2.kicad_sch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]
